sinara-hw/Kasli/(threads)

Thread 2 (2018-05-26):

Ethernet stops working when multiple EEMs used

gkasprow, 2018-05-26:
@marmeladapk found that when multiple Urukul or other EEM are plugged, Ethernet does not work.
The same happens when Kasli is supplied via extension backplane board.
Did you observe such case?
We will investigate it.

marmeladapk, 2018-05-26:
For example in suservo setup without dios link would not set up. On terminal no errors regarding ethernet are printed. It was a problem when 12V current was higher than ~1,5A.

jordens, 2018-05-27:
I have configured more than a dozen systems and at least 6 of them had 8 EEMs (3 Urukul, 1 Zotino, 1 Sampler, 3 DIO). I haven't seen this. From the description it's unclear what exactly you tried and what your configuration is. You'll have to supply versions, numbers etc.

gkasprow, 2018-05-27:
That's why I'm surprised that this occurred in my lab. Kasli was already tested with various configurations and so far nobody reported such effect.

jordens, 2018-05-28:
And you are sure that the hardware, gatware, firmware, bootloader versions match and are what you expect? What about the rest of the Toolchain?

hartytp, 2019-05-07:
@gkasprow @marmeladapk can you reproduce this, or can we close?

hartytp, 2019-09-19:
Can we close this?

Closed 2019-10-01.

Thread 3 (2018-06-13):

Kasli v1.2 wishlist

marmeladapk, 2018-06-13:
_From @marmeladapk on January 31, 2018 9:53_

- Rotate SATA connector
- Have I2C and UART signals in the same bank (each of them)
- Switch all components to our standard library
- Switch U1 to nonBGA version
- Maybe [Bigger heat sink](https://www.digikey.de/products/en/fans-thermal-management/thermal-heat-sinks/219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) with clamps pending measurements with big artiq setup
- Move the clock input SMA further towards the panel. Leave just enough gap for the insulating washer. Otherwise (with a gap, the two insulating washers, the panel, and the nut, even without the springy/claw washer) there is not enough thread to fully tighten an SMA connector.
- Si5369 instead of Si5324+ADCLK944 (power, board space, components, cost). Or even Si5346
- Move UART RxD away from bank 13
- Replace 100k resistors with 0R on the SMA clock input and MMCX clock outputs to tie all grounds together.
- Add note on schematic by the connectors saying something like "To float connector grounds, replace 0R with 100k. NB Kasli must be connected to mains ground for to avoid damage to it or other equipment connected to it!"
 - Add TVS on JTAG
 - Make board 2-3 mm shorter, so that technosystem doesn't need to grind each board to mount backplane connector... (they told me about it after five months!)

_Copied from original issue: sinara-hw/sinara#499_

marmeladapk, 2018-06-13:
_From @hartytp on January 31, 2018 14:2_

Is there a Kasli v1.2 planned for any time in the future?

marmeladapk, 2018-06-13:
_From @jordens on January 31, 2018 14:38_

I think we need more experience with it in the field to be able to say that.

marmeladapk, 2018-06-13:
First let's see how v1.1 operates, IMO points in the top post are not worth it right now.

marmeladapk, 2018-06-13:
> Change the Si5324 (loss of lock) LOL LED to red (as it indicates an error condition) or invert it.

@jordens Oh come on! You told me to change it from red to green so there are fewer items in the BOM. :D

Anyway LOL polarity can be changed in register 22 B1 of Si5324.

marmeladapk, 2018-06-13:
_From @jordens on February 3, 2018 7:57_

Ah. Right. Then it's perfect. I forgot about both. ;)

marmeladapk, 2018-06-13:
_From @hartytp on March 28, 2018 21:45_

The biggest thing I'd like to see changed on the list above is the heatsink, since the FPGA gets very hot atm. It might be worth going for a heatsink with a clip on fan.

marmeladapk, 2018-06-13:
_From @hartytp on March 28, 2018 23:31_

- [ ] Replace 100k resistors with 0R on the SMA clock input and MMCX clock outputs to tie all grounds together.
- [ ] Add note on schematic by the connectors saying something like "To float connector grounds, replace 0R with 100k. NB Kasli must be connected to mains ground for to avoid damage to it or other equipment connected to it!"

marmeladapk, 2018-06-13:
I think we're slowly approaching point when we can think about next revision. Are there any other things we'd like to test before I start implementing changes? What's the consensus on Si5324/Si5369/Si5346?

marmeladapk, 2018-06-13:
_From @hartytp on March 29, 2018 9:6_

@marmeladapk In the long run, I'm still potentially keen to implement WR on Kasli. Probably use a DAC + high-quality VCO for clock recovery. Then either use a LVPECL clock buffer (noise isn't critical here, so there are lots of options) or something like an AD9516-4 to do the fanout.

However, we're still doing a design study to make sure we get that right, so we won't have a design for that for another week or two.

Until/unless we switch to WR, I'm not fussed about any of the options being discussed. IMHO, the present clocking works well (modulo the stability/phase determinism issues with the Si5324) and none of the options presented above offer a good enough advantage in terms of cost/power/simplicity to be worth changing a working design and risking breaking things. However, if @jordens feels strongly about it, I don't object either.

marmeladapk, 2018-06-13:
_From @jordens on March 29, 2018 9:21_

> Kasli must be connected to mains ground for to avoid damage to it or other equipment connected to it!

I don't think that is accurate and might even be wrong. I'd state how much potential difference we are willing and able to tolerate and what the actual ground paths in the system are. Like it is done on all measurement equipment.

@sbourdeauducq wanted to do tests with the Si5326 to guide that decision.

And I don't think a big heat sink will cut it. We have been equipping them with fans.

marmeladapk, 2018-06-13:
_From @hartytp on March 29, 2018 9:30_

> And I don't think a big heat sink will cut it. We have been equipping them with fans.

:+1: Something like the heat sink on the KC705 would be nice.

> I don't think that is accurate and might even be wrong. I'd state how much potential difference we are willing and able to tolerate and what the actual ground paths in the system are. Like it is done on all measurement equipment.

AFAICT, connecting to PCB ground to mains ground is the most fool-proof solution, which should prevent damage in basically all cases (this is what almost all T&M equipment does), so it's an easy, safe recommendation to make -- I'm not aware of any situation where this could be dangerous/lead to damage, even if it's not often/always optimal from a noise perspective. Maybe change *must* to *should*, or even just re-word it to say that the potential difference between all grounds must be limited to safe-levels for all equipment, *for example* by connecting Kasli to mains ground?

Having said that, if you have a better suggestion, then feel free to make it (can you give exact text, please, including values for potential differences you want to recommend).

marmeladapk, 2018-06-13:
_From @hartytp on March 29, 2018 9:33_

@jordens @sbourdeauducq I believe the answer to this is "no", but to double check: we don't think that a bigger FPGA/higher speed grade would help with anything we're doing? e.g. for large Kasli designs, we're not close to being limited by FPGA resources, right? and, the higher speed grade wouldn't ease the CPU timing issues?

marmeladapk, 2018-06-13:
_From @sbourdeauducq on March 29, 2018 10:28_

After the siphaser system we introduced, I don't think the 5326 would improve anything significantly, it would just save something like one or two MMCMs in the FPGA since we can use the skew control registers instead. And if we start having it on any board, then we need to support both the 5324 and 5326 in the firmware. This family of chips appears to be exceptionally well-designed (case in point: the 5324 and 5326 are pin-compatible) and bug-free, so it's not a big issue if that has to be done, but why should we?

marmeladapk, 2018-06-13:
_From @sbourdeauducq on March 29, 2018 10:38_

Note that the 5326 does **not** have deterministic latency - all it brings to the table is built-in functionality to increase or decrease whatever random skew it has after locking, and higher loop bandwidth. So, it doesn't help with getting deterministic phase from the external clock input to the ARTIQ outputs.

I am in favor of either:
* keeping the 5324 (the engineering costs associated with the change and the maintainance of multiple clock chip variants in the firmware do not seem to be worth using a 5326, 5369 or 5346).
* designing a high-performance PLL a la White Rabbit.

marmeladapk, 2018-06-13:
_From @hartytp on March 29, 2018 11:6_

Thanks @sbourdeauducq. In that case, here is my suggestion:
- @WeiDaZhang keeps working on design of a WR implementation for Sinara, as well as carefully characterizing the performance of our current Si5324 setup and simulating/taking data on the performance of the WR system.
- We agree on a cut-off date for changes to the design for the next version of Kasli
- Once that cut-off date arrives:
  - if @WeiDaZhang's design isn't ready we stick with the current Si5324.
  - if we decide on the basis of @WeiDaZhang's measurements that the benefits from WR aren't sufficient to justify the changes, we stick with the Si5324
  - otherwise, we implement WR on Kasli for the next version.

Everyone happy with that plan? If so, what's the deadline for this decision?

marmeladapk, 2018-06-13:
_From @sbourdeauducq on March 29, 2018 11:18_

> Change the Si5324 (loss of lock) LOL LED to red (as it indicates an error condition) or invert it.
>
> @jordens Oh come on! You told me to change it from red to green so there are fewer items in the BOM. :D

Do we need this LED at all? Lock status is accessible from the firmware. I've never used that LED personally.

marmeladapk, 2018-06-13:
_From @jbqubit on March 29, 2018 12:55_

> AFAICT, connecting to PCB ground to mains ground is the most fool-proof solution

Agreed that this is the most fool-proof. The default configuration should protect casual end users as well as isolate the manufacturer from liability. The grounding implementation could be made so that it's easy to modify. Then modifications which might cause harm to body or the board itself are at the risk of the end user.

marmeladapk, 2018-06-13:
_From @sbourdeauducq on March 29, 2018 16:49_

> Everyone happy with that plan?

Sounds fine, but integrating the WR PLL into ARTIQ doesn't sound trivial; we need to plan for the manpower and development time in the firmware and gateware (in addition to the hardware changes).

marmeladapk, 2018-06-13:
_From @hartytp on March 29, 2018 17:14_

Absolutely, yes. That's an essential part of the cost / benefit analysis. But let's get a concrete proposal to discuss first...

marmeladapk, 2018-06-13:
_From @hartytp on April 1, 2018 8:7_

> Sounds fine, but integrating the WR PLL into ARTIQ doesn't sound trivial; we need to plan for the manpower and development time in the firmware and gateware (in addition to the hardware changes).

If we do go down the WR route, I'd still want to keep the Si5324 as well for at least the next version. Obviously, we would want to be able to use Kasli even while the WR gateware/firmware is developed and debugged.

marmeladapk, 2018-06-13:
_From @hartytp on April 1, 2018 8:19_

Is it worth considering switching to a Kintex FPGA and maybe increasing the ram width (cf the DMA issues @cjbe reported) for the next version?

Speed seems to be by far the biggest complaint of ARTIQ users, and the fact that Kasli is noticeably slower than the KC705 setups we've used in the past seems like a major step in the wrong direction. I'm all for optimising gateware/firmware, but it seems silly not to start from the fastest hardware platform we reasonably can -- I'm not sure about other users (@dhslichter @dtcallcock etc), but I would gladly pay a bit more for HW if it made my setups faster.

marmeladapk, 2018-06-13:
_From @jordens on April 1, 2018 9:0_

I'm against that. Lets keep kasli at the simple end. It was well known and acknowledged that it would be slower. Wider ram will lead to board space and power, thermal issues and redesigns. You are obviously free to fund a new device with a bigger fpga though.

marmeladapk, 2018-06-13:
_From @hartytp on April 1, 2018 14:9_

>  Lets keep kasli at the simple end.

"Simple" doesn't have to equal "slow". I'm not convinced that putting a faster FPGA on there makes it not a simple design.

> It was well known and acknowledged that it would be slower.

Really? That wasn't my impression. When I discussed this via email with you and @sbourdeauducq before Kasli v1.0's design was finalised I explicitly asked about whether there would be CPU frequency issues with the ARTIQ, and was told that there wouldn't be.

In any case, I think this point is largely irrelevant. What matters is whether, having used this in the lab and knowing what we know now, we still think the current design is the right one for the users, or whether changing the FPGA would be better. Let's not get hung up on why decisions were made.

> You are obviously free to fund a new device with a bigger fpga though.

Firstly: I read that to imply that you are funding work on the next Kasli revision. Is that actually true? Does your contract with WUT specify more than the standard two design rounds? If not, is this something that @marmeladapk and @gkasprow are doing on their own steam without and funding? If so, I don't see why you're bringing up funding here.

Secondly: I've worked hard to avoid hardware fragmentation in this project because I (still) believe that's the only way we're going to get a set of high-quality, well supported hardware which is stocked at good prices from a commercial vendor. If we all take the line of "this is my project, so if you don't like it then make your own version" then we're going to end up with a multiplicity of shoddy boards. I think we can be a bit more mature than that and work to find solutions that work for everyone.

Thirdly: while you may have funded the original version of Kasli, if you want someone like Creotech to stock it then they have to believe that it's what the users want. So, let's have an discussion that focusses on technical points, rather than shutting things down with "this is my project, go away".

> Wider ram will lead to board space and power, thermal issues and redesigns.

You've made this kind of assertion several times in this project only to be contradicted by @marmeladapk, who is actually doing the design work and has done the simulations. If you've done a simulation or have anything concrete to back up these claims then I'd love to hear about them. But, otherwise, I'd rather hear from @gkasprow or @marmeladapk.

---

tl;dr: if other users don't think a bigger FPGA is worth it (maybe this is worth addressing to the ARTIQ mailing list), or if @gkasprow or @marmeladapk think that it would be too much work/cause other issues, then let's leave it as is. But, if there are simple changes that can make Kasli work better for the users then we should consider them.

After all, it's not like the current FPGA on Kasli isn't causing problems right now, and that makes me concerned that in the long run it's not a very good choice.

marmeladapk, 2018-06-13:
_From @hartytp on April 1, 2018 14:12_

>  It was well known and acknowledged that it would be slower.

Again, I'd love to hear from one of the other groups who are actually using ARTIQ to run experiments with (e.g. @dtcallcock @dhslichter) but my feeling is that the current slowness of ARTIQ makes it a massive pain in the neck for most use cases. Anything that makes it even slower is of very limited interest as far as I'm concerned.

marmeladapk, 2018-06-13:
_From @hartytp on April 1, 2018 14:40_

To be a bit more concrete here, my concerns are things like: if we're struggling to make ARTIQ meet timing on Kasli as it is, what will happen when we want to add features like hard floating-point maths? Will we just have to accept that they aren't available on Kasli because we put a slow FPGA on it?

marmeladapk, 2018-06-13:
_From @sbourdeauducq on April 1, 2018 14:57_

> It was well known and acknowledged that it would be slower.
>
> Really? That wasn't my impression. When I discussed this via email with you and @sbourdeauducq before Kasli v1.0's design was finalised I explicitly asked about whether there would be CPU frequency issues with the ARTIQ, and was told that there wouldn't be.

I guess @jordens is talking about the RAM, which is obviously slower than on KC705 (16-bit vs. 64-bit data bus).
How strongly Vivado insists on making mor1kx systems slow on Artix-7, on the other hand, is a bit of a surprise. Switching to 7K70T might be OK (it's not much more expensive), if it weren't for the major PCB design change, plus another round of transceiver yak-shaving to make DRTIO and Ethernet work again (among their many problems, transceivers are not compatible between FPGA families and each comes with its own set of idiosyncrasies and obscure bugs).

marmeladapk, 2018-06-13:
_From @sbourdeauducq on April 1, 2018 15:28_

> How strongly Vivado insists on making mor1kx systems slow on Artix-7, on the other hand, is a bit of a surprise.

Part of the reason it's a surprise is because uniprocessor systems (e.g. the DRTIO satellite, and other MiSoC ports to Artix-7 boards) meet timing; the problems appear with the ARTIQ dual-CPU design for some reason.

marmeladapk, 2018-06-13:
_From @hartytp on April 1, 2018 17:28_

> I guess @jordens is talking about the RAM, which is obviously slower than on KC705 (16-bit vs. 64-bit data bus).

Yes, that the RAM on Kasli is obviously slower than the KC705. However, I'm not sure that the effects that has on ARTIQ DMA were obvious or anticipated (the RAM bandwidth is still pretty huge).

However, that can probably be sorted with a more efficient RAM controller, so it may be that no HW changes are needed here. Although, it's still not clear to me that the cost of adding a wider RAM bus to Kasli is actually that high, so it might still be worth considering.

marmeladapk, 2018-06-13:
_From @hartytp on April 1, 2018 17:32_

> How strongly Vivado insists on making mor1kx systems slow on Artix-7, on the other hand, is a bit of a surprise.

Yes, this concerns me much more than the RAM.

> if it weren't for the major PCB design change

IIRC, there will need to be some substantial re-routing to add a bigger heatsink, so now is the time to consider that. @marmeladapk @gkasprow what's your feeling about this? How hard would that be to do?

> plus another round of transceiver yak-shaving to make DRTIO and Ethernet work again (among their many problems, transceivers are not compatible between FPGA families and they each come with their own set of idiosyncrasies and obscure bugs).

ACK. That's a reasonable point. However, what do you think is going to be more work in the long run: fixing the transceivers once or fighting against slow silicon on Kasli for everything we do?

marmeladapk, 2018-06-13:
_From @hartytp on April 1, 2018 17:34_

> Part of the reason it's a surprise is because uniprocessor systems (e.g. the DRTIO satellite, and other MiSoC ports to Artix-7 boards) meet timing; the problems appear with the ARTIQ dual-CPU design for some reason.

Yes, that is a bit concerning. And, again, it doesn't give me much confidence that issues to do with Artix FPGAs being slow won't be a recurring theme as we develop ARTIQ further, e.g. by adding hard FP.

marmeladapk, 2018-06-13:
_From @sbourdeauducq on April 2, 2018 2:45_

> ACK. That's a reasonable point. However, what do you think is going to be more work in the long run: fixing the transceivers once or fighting against slow silicon on Kasli for everything we do?

It's not "everything"; as I posted in https://github.com/m-labs/artiq/issues/891 the LM32 processor has a lot less timing issues. Also, even with mor1kx, the magnitude of the timing failure is small: with the numbers that Robert initially reported, it would run at 122.9MHz instead of the target 125MHz, a 1.7% slowdown.

marmeladapk, 2018-06-13:
_From @hartytp on April 2, 2018 7:35_

> Also, even with mor1kx, the magnitude of the timing failure is small: with the numbers that Robert initially reported, it would run at 122.9MHz instead of the target 125MHz, a 1.7% slowdown.

Yes, although I got the impression that there was some build to build variation in that.

> It's not "everything"; as I posted in m-labs/artiq#891 the LM32 processor has a lot less timing issues.

You're right "everything" is an exaggeration. Lot's of things won't be affected by having a slower FPGA. But, it is hurting us at the moment, and it seems likely that having a CPU that only just meets timing has the potential to cause more issues in the future.

Taking a step back for a moment: I think we all agree that ARTIQ is currently too slow, and that it needs to be speeded up in the future. We know the Artix FPGA on Kasli is slower than comparably priced Kintex FPGAs, and that this can cause issues. Given that, are we sure we don't want to consider using a faster FPGA? Even if we do switch to the LM32 and even if this does fix the timing issues we're currently seeing, are you really sure that the slower FPGA won't cause other problems in the future?

marmeladapk, 2018-06-13:
_From @hartytp on April 2, 2018 7:36_

Of course, if @gkasprow or @marmeladapk say it's too much work to consider for the next version of Kasli, then it may not be an option.

marmeladapk, 2018-06-13:
> Does your contract with WUT specify more than the standard two design rounds? If not, is this something that @marmeladapk and @gkasprow are doing on their own steam without and funding?

I'm not aware of the state of the funding. However week ago I thought that design was frozen and v1.2 was only cosmetic and QoL changes.

---

>> Wider ram will lead to board space and power, thermal issues and redesigns.

@hartytp, @jordens is right on this one. While I wouldn't worry about thermal and power issues (unless we're speaking about FPGA itself, we've got plenty of power left on 1,5 V rail, see schematics) redesign would be needed here. I feel, that current configuration is optimal and we don't have any room to fiddle with this design.

First, we would have to use another bank on FPGA for additional 16 bits. We can't share it with EEM banks since they use different voltages. So we have to get rid of at least 3 extensions (if we want to minimise work that would be eem0 to 2). This is the easiest option to implement. If we don't want to cut any corners then other options include expander and level shifter for all SFP control signals that could then share bank with SDRAM. That would require bottom half of FPGA (and eem0 to 7 and 10 to 11) to be rerouted.

We could also switch to bigger package (and to Artix 200T since we need an additional bank). This may or may not require to switch to 8 layers. I can't tell because on the one hand I need to escape with additional 16 length matched signals and on the other hand FPGA side is bigger. Obviously bigger package requires rerouting everything under and in the vicinity of the FPGA (+ power planes). And changing stackup will probably require changes to all impedance controlled lines.

> if there are simple changes that can make Kasli work better for the users then we should consider them

As I said, I think we don't have any easy ways to improve this design (apart from changing 100T to 200T in the same package, but more on that later).

**TL;DR**: Wider RAM is hard.

-----

> if we're struggling to make ARTIQ meet timing on Kasli

> Vivado insists on making mor1kx systems slow on Artix-7

Is this something that more resources could help? Or are we not using over 60-70% of them (can't check right now, I can't connect to our computers at uni)? Artix 200T is available in the same package. Xilinx says that it's pin compatible, it may only have other decoupling requirements.

Also, stupid question: have we tried different synthesis and implementation strategies? Xilinx recommends trying all of them and then choosing one that works best (seriously) if design barely doesn't meet timing. 1-2% could be gained there.

> ARTIQ is currently too slow

Is it only slow on Kasli or also on Sayma and KC705?

> Is it worth considering switching to a Kintex FPGA and maybe increasing the ram width

> Artix FPGA on Kasli is slower than comparably priced Kintex FPGAs (...) are we sure we don't want to consider using a faster FPGA?

I feel that this would be the change worthy of 2.0 version number. K70T has less resources that A100T so I don't feel that would be the optimal change. Only other FPGA available in 484 package is K160T. But we have to remember, that Xilinx FPGAs are not pin-compatible between families. So that would require rerouting everything under and near FPGA. Also some LVDS lines would have to use HP banks, so we would use 1,8 V LVDS. This should not be a problem for devices (probably, @gkasprow?), just noting. But we could then use HP bank for SDRAM. Not sure if this would help, @jordens and @sbourdeauducq should chime in here.

**TL;DR** Switching to Kintex-7 is also hard.

---

Overall my feelings are, that we're moving away from the idea of cheap and simpler controller that Kasli was supposed to be. Instead I feel like we're stepping closer to inventing MTCA from scratch, only with ribbon cables this time. And while I agree with @hartytp that ARTIQ on Kasli is too slow I wouldn't jump to conclusion that changing hardware right now is the solution. It looks like knee-jerk reaction TBH.

Perhaps giving more time (and funding?) to m-labs to optimize ARTIQ and underlying software could help? It would also translate to gains on all other boards now and in the future. If @sbourdeauducq says, that he didn't anticipate processor to be so slow on Artix and we didn't find a clear bottleneck who says that it won't repeat on small Kintex?

OFC if we find the bottleneck and it's for example RAM then let's change that. But I've outlined why these aren't simple changes.

marmeladapk, 2018-06-13:
_From @sbourdeauducq on April 2, 2018 12:54_

> Also, stupid question: have we tried different synthesis and implementation strategies? Xilinx recommends trying all of them and then choosing one that works best (seriously) if design barely doesn't meet timing. 1-2% could be gained there.

Yeah, I've been looking into this. I can make many mor1kx options meet timing on many variants (opticlock, sysu, master etc.) by using various Vivado commands, but what works on one variant doesn't often work on another and some combination of commands have very long runtime.

Trying a pin-compatible 200T FPGA is a good idea, and easy to change in the gateware - let me see if that improves timing.

Closed 2018-06-13.

Thread 4 (2018-06-13):

Kasli v1.2 wishlist

marmeladapk, 2018-06-13:
_From @marmeladapk on January 31, 2018 9:53_

- Rotate SATA connector
- Have I2C and UART signals in the same bank (each of them)
- Switch all components to our standard library
- Switch U1 to nonBGA version
- Maybe [Bigger heat sink](https://www.digikey.de/products/en/fans-thermal-management/thermal-heat-sinks/219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) with clamps pending measurements with big artiq setup
- Move the clock input SMA further towards the panel. Leave just enough gap for the insulating washer. Otherwise (with a gap, the two insulating washers, the panel, and the nut, even without the springy/claw washer) there is not enough thread to fully tighten an SMA connector.
- Si5369 instead of Si5324+ADCLK944 (power, board space, components, cost). Or even Si5346
- Move UART RxD away from bank 13
- Replace 100k resistors with 0R on the SMA clock input and MMCX clock outputs to tie all grounds together.
- Add note on schematic by the connectors saying something like "To float connector grounds, replace 0R with 100k. NB Kasli must be connected to mains ground for to avoid damage to it or other equipment connected to it!"
 - Add TVS on JTAG
 - Make board 2-3 mm shorter, so that technosystem doesn't need to grind each board to mount backplane connector... (they told me about it after five months!)

_Copied from original issue: sinara-hw/sinara#499_

marmeladapk, 2018-06-13:
_From @hartytp on January 31, 2018 14:2_

Is there a Kasli v1.2 planned for any time in the future?

marmeladapk, 2018-06-13:
_From @jordens on January 31, 2018 14:38_

I think we need more experience with it in the field to be able to say that.

marmeladapk, 2018-06-13:
First let's see how v1.1 operates, IMO points in the top post are not worth it right now.

marmeladapk, 2018-06-13:
> Change the Si5324 (loss of lock) LOL LED to red (as it indicates an error condition) or invert it.

@jordens Oh come on! You told me to change it from red to green so there are fewer items in the BOM. :D

Anyway LOL polarity can be changed in register 22 B1 of Si5324.

marmeladapk, 2018-06-13:
_From @jordens on February 3, 2018 7:57_

Ah. Right. Then it's perfect. I forgot about both. ;)

marmeladapk, 2018-06-13:
_From @hartytp on March 28, 2018 21:45_

The biggest thing I'd like to see changed on the list above is the heatsink, since the FPGA gets very hot atm. It might be worth going for a heatsink with a clip on fan.

marmeladapk, 2018-06-13:
_From @hartytp on March 28, 2018 23:31_

- [ ] Replace 100k resistors with 0R on the SMA clock input and MMCX clock outputs to tie all grounds together.
- [ ] Add note on schematic by the connectors saying something like "To float connector grounds, replace 0R with 100k. NB Kasli must be connected to mains ground for to avoid damage to it or other equipment connected to it!"

marmeladapk, 2018-06-13:
I think we're slowly approaching point when we can think about next revision. Are there any other things we'd like to test before I start implementing changes? What's the consensus on Si5324/Si5369/Si5346?

marmeladapk, 2018-06-13:
_From @jordens on March 29, 2018 9:21_

> Kasli must be connected to mains ground for to avoid damage to it or other equipment connected to it!

I don't think that is accurate and might even be wrong. I'd state how much potential difference we are willing and able to tolerate and what the actual ground paths in the system are. Like it is done on all measurement equipment.

@sbourdeauducq wanted to do tests with the Si5326 to guide that decision.

And I don't think a big heat sink will cut it. We have been equipping them with fans.

marmeladapk, 2018-06-13:
_From @hartytp on March 29, 2018 9:30_

> And I don't think a big heat sink will cut it. We have been equipping them with fans.

:+1: Something like the heat sink on the KC705 would be nice.

> I don't think that is accurate and might even be wrong. I'd state how much potential difference we are willing and able to tolerate and what the actual ground paths in the system are. Like it is done on all measurement equipment.

AFAICT, connecting to PCB ground to mains ground is the most fool-proof solution, which should prevent damage in basically all cases (this is what almost all T&M equipment does), so it's an easy, safe recommendation to make -- I'm not aware of any situation where this could be dangerous/lead to damage, even if it's not often/always optimal from a noise perspective. Maybe change *must* to *should*, or even just re-word it to say that the potential difference between all grounds must be limited to safe-levels for all equipment, *for example* by connecting Kasli to mains ground?

Having said that, if you have a better suggestion, then feel free to make it (can you give exact text, please, including values for potential differences you want to recommend).

marmeladapk, 2018-06-13:
_From @hartytp on March 29, 2018 9:33_

@jordens @sbourdeauducq I believe the answer to this is "no", but to double check: we don't think that a bigger FPGA/higher speed grade would help with anything we're doing? e.g. for large Kasli designs, we're not close to being limited by FPGA resources, right? and, the higher speed grade wouldn't ease the CPU timing issues?

marmeladapk, 2018-06-13:
_From @sbourdeauducq on March 29, 2018 10:28_

After the siphaser system we introduced, I don't think the 5326 would improve anything significantly, it would just save something like one or two MMCMs in the FPGA since we can use the skew control registers instead. And if we start having it on any board, then we need to support both the 5324 and 5326 in the firmware. This family of chips appears to be exceptionally well-designed (case in point: the 5324 and 5326 are pin-compatible) and bug-free, so it's not a big issue if that has to be done, but why should we?

marmeladapk, 2018-06-13:
_From @sbourdeauducq on March 29, 2018 10:38_

Note that the 5326 does **not** have deterministic latency - all it brings to the table is built-in functionality to increase or decrease whatever random skew it has after locking, and higher loop bandwidth. So, it doesn't help with getting deterministic phase from the external clock input to the ARTIQ outputs.

I am in favor of either:
* keeping the 5324 (the engineering costs associated with the change and the maintainance of multiple clock chip variants in the firmware do not seem to be worth using a 5326, 5369 or 5346).
* designing a high-performance PLL a la White Rabbit.

marmeladapk, 2018-06-13:
_From @hartytp on March 29, 2018 11:6_

Thanks @sbourdeauducq. In that case, here is my suggestion:
- @WeiDaZhang keeps working on design of a WR implementation for Sinara, as well as carefully characterizing the performance of our current Si5324 setup and simulating/taking data on the performance of the WR system.
- We agree on a cut-off date for changes to the design for the next version of Kasli
- Once that cut-off date arrives:
  - if @WeiDaZhang's design isn't ready we stick with the current Si5324.
  - if we decide on the basis of @WeiDaZhang's measurements that the benefits from WR aren't sufficient to justify the changes, we stick with the Si5324
  - otherwise, we implement WR on Kasli for the next version.

Everyone happy with that plan? If so, what's the deadline for this decision?

marmeladapk, 2018-06-13:
_From @sbourdeauducq on March 29, 2018 11:18_

> Change the Si5324 (loss of lock) LOL LED to red (as it indicates an error condition) or invert it.
>
> @jordens Oh come on! You told me to change it from red to green so there are fewer items in the BOM. :D

Do we need this LED at all? Lock status is accessible from the firmware. I've never used that LED personally.

marmeladapk, 2018-06-13:
_From @jbqubit on March 29, 2018 12:55_

> AFAICT, connecting to PCB ground to mains ground is the most fool-proof solution

Agreed that this is the most fool-proof. The default configuration should protect casual end users as well as isolate the manufacturer from liability. The grounding implementation could be made so that it's easy to modify. Then modifications which might cause harm to body or the board itself are at the risk of the end user.

marmeladapk, 2018-06-13:
_From @sbourdeauducq on March 29, 2018 16:49_

> Everyone happy with that plan?

Sounds fine, but integrating the WR PLL into ARTIQ doesn't sound trivial; we need to plan for the manpower and development time in the firmware and gateware (in addition to the hardware changes).

marmeladapk, 2018-06-13:
_From @hartytp on March 29, 2018 17:14_

Absolutely, yes. That's an essential part of the cost / benefit analysis. But let's get a concrete proposal to discuss first...

marmeladapk, 2018-06-13:
_From @hartytp on April 1, 2018 8:7_

> Sounds fine, but integrating the WR PLL into ARTIQ doesn't sound trivial; we need to plan for the manpower and development time in the firmware and gateware (in addition to the hardware changes).

If we do go down the WR route, I'd still want to keep the Si5324 as well for at least the next version. Obviously, we would want to be able to use Kasli even while the WR gateware/firmware is developed and debugged.

marmeladapk, 2018-06-13:
_From @hartytp on April 1, 2018 8:19_

Is it worth considering switching to a Kintex FPGA and maybe increasing the ram width (cf the DMA issues @cjbe reported) for the next version?

Speed seems to be by far the biggest complaint of ARTIQ users, and the fact that Kasli is noticeably slower than the KC705 setups we've used in the past seems like a major step in the wrong direction. I'm all for optimising gateware/firmware, but it seems silly not to start from the fastest hardware platform we reasonably can -- I'm not sure about other users (@dhslichter @dtcallcock etc), but I would gladly pay a bit more for HW if it made my setups faster.

marmeladapk, 2018-06-13:
_From @jordens on April 1, 2018 9:0_

I'm against that. Lets keep kasli at the simple end. It was well known and acknowledged that it would be slower. Wider ram will lead to board space and power, thermal issues and redesigns. You are obviously free to fund a new device with a bigger fpga though.

marmeladapk, 2018-06-13:
_From @hartytp on April 1, 2018 14:9_

>  Lets keep kasli at the simple end.

"Simple" doesn't have to equal "slow". I'm not convinced that putting a faster FPGA on there makes it not a simple design.

> It was well known and acknowledged that it would be slower.

Really? That wasn't my impression. When I discussed this via email with you and @sbourdeauducq before Kasli v1.0's design was finalised I explicitly asked about whether there would be CPU frequency issues with the ARTIQ, and was told that there wouldn't be.

In any case, I think this point is largely irrelevant. What matters is whether, having used this in the lab and knowing what we know now, we still think the current design is the right one for the users, or whether changing the FPGA would be better. Let's not get hung up on why decisions were made.

> You are obviously free to fund a new device with a bigger fpga though.

Firstly: I read that to imply that you are funding work on the next Kasli revision. Is that actually true? Does your contract with WUT specify more than the standard two design rounds? If not, is this something that @marmeladapk and @gkasprow are doing on their own steam without and funding? If so, I don't see why you're bringing up funding here.

Secondly: I've worked hard to avoid hardware fragmentation in this project because I (still) believe that's the only way we're going to get a set of high-quality, well supported hardware which is stocked at good prices from a commercial vendor. If we all take the line of "this is my project, so if you don't like it then make your own version" then we're going to end up with a multiplicity of shoddy boards. I think we can be a bit more mature than that and work to find solutions that work for everyone.

Thirdly: while you may have funded the original version of Kasli, if you want someone like Creotech to stock it then they have to believe that it's what the users want. So, let's have an discussion that focusses on technical points, rather than shutting things down with "this is my project, go away".

> Wider ram will lead to board space and power, thermal issues and redesigns.

You've made this kind of assertion several times in this project only to be contradicted by @marmeladapk, who is actually doing the design work and has done the simulations. If you've done a simulation or have anything concrete to back up these claims then I'd love to hear about them. But, otherwise, I'd rather hear from @gkasprow or @marmeladapk.

---

tl;dr: if other users don't think a bigger FPGA is worth it (maybe this is worth addressing to the ARTIQ mailing list), or if @gkasprow or @marmeladapk think that it would be too much work/cause other issues, then let's leave it as is. But, if there are simple changes that can make Kasli work better for the users then we should consider them.

After all, it's not like the current FPGA on Kasli isn't causing problems right now, and that makes me concerned that in the long run it's not a very good choice.

marmeladapk, 2018-06-13:
_From @hartytp on April 1, 2018 14:12_

>  It was well known and acknowledged that it would be slower.

Again, I'd love to hear from one of the other groups who are actually using ARTIQ to run experiments with (e.g. @dtcallcock @dhslichter) but my feeling is that the current slowness of ARTIQ makes it a massive pain in the neck for most use cases. Anything that makes it even slower is of very limited interest as far as I'm concerned.

marmeladapk, 2018-06-13:
_From @hartytp on April 1, 2018 14:40_

To be a bit more concrete here, my concerns are things like: if we're struggling to make ARTIQ meet timing on Kasli as it is, what will happen when we want to add features like hard floating-point maths? Will we just have to accept that they aren't available on Kasli because we put a slow FPGA on it?

marmeladapk, 2018-06-13:
_From @sbourdeauducq on April 1, 2018 14:57_

> It was well known and acknowledged that it would be slower.
>
> Really? That wasn't my impression. When I discussed this via email with you and @sbourdeauducq before Kasli v1.0's design was finalised I explicitly asked about whether there would be CPU frequency issues with the ARTIQ, and was told that there wouldn't be.

I guess @jordens is talking about the RAM, which is obviously slower than on KC705 (16-bit vs. 64-bit data bus).
How strongly Vivado insists on making mor1kx systems slow on Artix-7, on the other hand, is a bit of a surprise. Switching to 7K70T might be OK (it's not much more expensive), if it weren't for the major PCB design change, plus another round of transceiver yak-shaving to make DRTIO and Ethernet work again (among their many problems, transceivers are not compatible between FPGA families and each comes with its own set of idiosyncrasies and obscure bugs).

marmeladapk, 2018-06-13:
_From @sbourdeauducq on April 1, 2018 15:28_

> How strongly Vivado insists on making mor1kx systems slow on Artix-7, on the other hand, is a bit of a surprise.

Part of the reason it's a surprise is because uniprocessor systems (e.g. the DRTIO satellite, and other MiSoC ports to Artix-7 boards) meet timing; the problems appear with the ARTIQ dual-CPU design for some reason.

marmeladapk, 2018-06-13:
_From @hartytp on April 1, 2018 17:28_

> I guess @jordens is talking about the RAM, which is obviously slower than on KC705 (16-bit vs. 64-bit data bus).

Yes, that the RAM on Kasli is obviously slower than the KC705. However, I'm not sure that the effects that has on ARTIQ DMA were obvious or anticipated (the RAM bandwidth is still pretty huge).

However, that can probably be sorted with a more efficient RAM controller, so it may be that no HW changes are needed here. Although, it's still not clear to me that the cost of adding a wider RAM bus to Kasli is actually that high, so it might still be worth considering.

marmeladapk, 2018-06-13:
_From @hartytp on April 1, 2018 17:32_

> How strongly Vivado insists on making mor1kx systems slow on Artix-7, on the other hand, is a bit of a surprise.

Yes, this concerns me much more than the RAM.

> if it weren't for the major PCB design change

IIRC, there will need to be some substantial re-routing to add a bigger heatsink, so now is the time to consider that. @marmeladapk @gkasprow what's your feeling about this? How hard would that be to do?

> plus another round of transceiver yak-shaving to make DRTIO and Ethernet work again (among their many problems, transceivers are not compatible between FPGA families and they each come with their own set of idiosyncrasies and obscure bugs).

ACK. That's a reasonable point. However, what do you think is going to be more work in the long run: fixing the transceivers once or fighting against slow silicon on Kasli for everything we do?

marmeladapk, 2018-06-13:
_From @hartytp on April 1, 2018 17:34_

> Part of the reason it's a surprise is because uniprocessor systems (e.g. the DRTIO satellite, and other MiSoC ports to Artix-7 boards) meet timing; the problems appear with the ARTIQ dual-CPU design for some reason.

Yes, that is a bit concerning. And, again, it doesn't give me much confidence that issues to do with Artix FPGAs being slow won't be a recurring theme as we develop ARTIQ further, e.g. by adding hard FP.

marmeladapk, 2018-06-13:
_From @sbourdeauducq on April 2, 2018 2:45_

> ACK. That's a reasonable point. However, what do you think is going to be more work in the long run: fixing the transceivers once or fighting against slow silicon on Kasli for everything we do?

It's not "everything"; as I posted in https://github.com/m-labs/artiq/issues/891 the LM32 processor has a lot less timing issues. Also, even with mor1kx, the magnitude of the timing failure is small: with the numbers that Robert initially reported, it would run at 122.9MHz instead of the target 125MHz, a 1.7% slowdown.

marmeladapk, 2018-06-13:
_From @hartytp on April 2, 2018 7:35_

> Also, even with mor1kx, the magnitude of the timing failure is small: with the numbers that Robert initially reported, it would run at 122.9MHz instead of the target 125MHz, a 1.7% slowdown.

Yes, although I got the impression that there was some build to build variation in that.

> It's not "everything"; as I posted in m-labs/artiq#891 the LM32 processor has a lot less timing issues.

You're right "everything" is an exaggeration. Lot's of things won't be affected by having a slower FPGA. But, it is hurting us at the moment, and it seems likely that having a CPU that only just meets timing has the potential to cause more issues in the future.

Taking a step back for a moment: I think we all agree that ARTIQ is currently too slow, and that it needs to be speeded up in the future. We know the Artix FPGA on Kasli is slower than comparably priced Kintex FPGAs, and that this can cause issues. Given that, are we sure we don't want to consider using a faster FPGA? Even if we do switch to the LM32 and even if this does fix the timing issues we're currently seeing, are you really sure that the slower FPGA won't cause other problems in the future?

marmeladapk, 2018-06-13:
_From @hartytp on April 2, 2018 7:36_

Of course, if @gkasprow or @marmeladapk say it's too much work to consider for the next version of Kasli, then it may not be an option.

marmeladapk, 2018-06-13:
> Does your contract with WUT specify more than the standard two design rounds? If not, is this something that @marmeladapk and @gkasprow are doing on their own steam without and funding?

I'm not aware of the state of the funding. However week ago I thought that design was frozen and v1.2 was only cosmetic and QoL changes.

---

>> Wider ram will lead to board space and power, thermal issues and redesigns.

@hartytp, @jordens is right on this one. While I wouldn't worry about thermal and power issues (unless we're speaking about FPGA itself, we've got plenty of power left on 1,5 V rail, see schematics) redesign would be needed here. I feel, that current configuration is optimal and we don't have any room to fiddle with this design.

First, we would have to use another bank on FPGA for additional 16 bits. We can't share it with EEM banks since they use different voltages. So we have to get rid of at least 3 extensions (if we want to minimise work that would be eem0 to 2). This is the easiest option to implement. If we don't want to cut any corners then other options include expander and level shifter for all SFP control signals that could then share bank with SDRAM. That would require bottom half of FPGA (and eem0 to 7 and 10 to 11) to be rerouted.

We could also switch to bigger package (and to Artix 200T since we need an additional bank). This may or may not require to switch to 8 layers. I can't tell because on the one hand I need to escape with additional 16 length matched signals and on the other hand FPGA side is bigger. Obviously bigger package requires rerouting everything under and in the vicinity of the FPGA (+ power planes). And changing stackup will probably require changes to all impedance controlled lines.

> if there are simple changes that can make Kasli work better for the users then we should consider them

As I said, I think we don't have any easy ways to improve this design (apart from changing 100T to 200T in the same package, but more on that later).

**TL;DR**: Wider RAM is hard.

-----

> if we're struggling to make ARTIQ meet timing on Kasli

> Vivado insists on making mor1kx systems slow on Artix-7

Is this something that more resources could help? Or are we not using over 60-70% of them (can't check right now, I can't connect to our computers at uni)? Artix 200T is available in the same package. Xilinx says that it's pin compatible, it may only have other decoupling requirements.

Also, stupid question: have we tried different synthesis and implementation strategies? Xilinx recommends trying all of them and then choosing one that works best (seriously) if design barely doesn't meet timing. 1-2% could be gained there.

> ARTIQ is currently too slow

Is it only slow on Kasli or also on Sayma and KC705?

> Is it worth considering switching to a Kintex FPGA and maybe increasing the ram width

> Artix FPGA on Kasli is slower than comparably priced Kintex FPGAs (...) are we sure we don't want to consider using a faster FPGA?

I feel that this would be the change worthy of 2.0 version number. K70T has less resources that A100T so I don't feel that would be the optimal change. Only other FPGA available in 484 package is K160T. But we have to remember, that Xilinx FPGAs are not pin-compatible between families. So that would require rerouting everything under and near FPGA. Also some LVDS lines would have to use HP banks, so we would use 1,8 V LVDS. This should not be a problem for devices (probably, @gkasprow?), just noting. But we could then use HP bank for SDRAM. Not sure if this would help, @jordens and @sbourdeauducq should chime in here.

**TL;DR** Switching to Kintex-7 is also hard.

---

Overall my feelings are, that we're moving away from the idea of cheap and simpler controller that Kasli was supposed to be. Instead I feel like we're stepping closer to inventing MTCA from scratch, only with ribbon cables this time. And while I agree with @hartytp that ARTIQ on Kasli is too slow I wouldn't jump to conclusion that changing hardware right now is the solution. It looks like knee-jerk reaction TBH.

Perhaps giving more time (and funding?) to m-labs to optimize ARTIQ and underlying software could help? It would also translate to gains on all other boards now and in the future. If @sbourdeauducq says, that he didn't anticipate processor to be so slow on Artix and we didn't find a clear bottleneck who says that it won't repeat on small Kintex?

OFC if we find the bottleneck and it's for example RAM then let's change that. But I've outlined why these aren't simple changes.

marmeladapk, 2018-06-13:
_From @sbourdeauducq on April 2, 2018 12:54_

> Also, stupid question: have we tried different synthesis and implementation strategies? Xilinx recommends trying all of them and then choosing one that works best (seriously) if design barely doesn't meet timing. 1-2% could be gained there.

Yeah, I've been looking into this. I can make many mor1kx options meet timing on many variants (opticlock, sysu, master etc.) by using various Vivado commands, but what works on one variant doesn't often work on another and some combination of commands have very long runtime.

Trying a pin-compatible 200T FPGA is a good idea, and easy to change in the gateware - let me see if that improves timing.

marmeladapk, 2018-06-13:
Error when importing.

Closed 2018-06-13.

Thread 5 (2018-06-13):

Kasli v1.2 wishlist

marmeladapk, 2018-06-13:
_From @marmeladapk on [2018-01-31 09:53](https://github.com/sinara-hw/sinara/issues/499)_

- [ ] Rotate SATA connector
- [ ] Have I2C and UART signals in the same bank (each of them)
- [ ] Switch all components to our standard library
- [ ] Switch U1 to nonBGA version
- [ ] Maybe [Bigger heat sink](https://www.digikey.de/products/en/fans-thermal-management/thermal-heat-sinks/219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) with clamps pending measurements with big artiq setup
- [ ] Move the clock input SMA further towards the panel. Leave just enough gap for the insulating washer. Otherwise (with a gap, the two insulating washers, the panel, and the nut, even without the springy/claw washer) there is not enough thread to fully tighten an SMA connector.
- [ ] Si5369 instead of Si5324+ADCLK944 (power, board space, components, cost). Or even Si5346
- [x] Move UART RxD away from bank 13
- [x] Replace 100k resistors with 0R on the SMA clock input and MMCX clock outputs to tie all grounds together.
- [ ] Add note on schematic by the connectors saying something like "To float connector grounds, replace 0R with 100k. NB Kasli must be connected to mains ground for to avoid damage to it or other equipment connected to it!"
 - [ ] Add TVS on JTAG
 - [x] Make board 2-3 mm shorter, so that technosystem doesn't need to grind each board to mount backplane connector... (they told me about it after five months!)

marmeladapk, 2018-06-13:
_From @hartytp on [2018-01-31 14:02](https://github.com/sinara-hw/sinara/issues/499#issuecomment-361940819)_

Is there a Kasli v1.2 planned for any time in the future?

marmeladapk, 2018-06-13:
_From @jordens on [2018-01-31 14:38](https://github.com/sinara-hw/sinara/issues/499#issuecomment-361951448)_

I think we need more experience with it in the field to be able to say that.

marmeladapk, 2018-06-13:
_From @marmeladapk on [2018-01-31 14:44](https://github.com/sinara-hw/sinara/issues/499#issuecomment-361953185)_

First let's see how v1.1 operates, IMO points in the top post are not worth it right now.

marmeladapk, 2018-06-13:
_From @marmeladapk on [2018-02-02 21:04](https://github.com/sinara-hw/sinara/issues/499#issuecomment-362706992)_

> Change the Si5324 (loss of lock) LOL LED to red (as it indicates an error condition) or invert it.

@jordens Oh come on! You told me to change it from red to green so there are fewer items in the BOM. :D

Anyway LOL polarity can be changed in register 22 B1 of Si5324.

marmeladapk, 2018-06-13:
_From @jordens on [2018-02-03 07:57](https://github.com/sinara-hw/sinara/issues/499#issuecomment-362788316)_

Ah. Right. Then it's perfect. I forgot about both. ;)

marmeladapk, 2018-06-13:
_From @hartytp on [2018-03-28 21:45](https://github.com/sinara-hw/sinara/issues/499#issuecomment-377047747)_

The biggest thing I'd like to see changed on the list above is the heatsink, since the FPGA gets very hot atm. It might be worth going for a heatsink with a clip on fan.

marmeladapk, 2018-06-13:
_From @hartytp on [2018-03-28 23:31](https://github.com/sinara-hw/sinara/issues/499#issuecomment-377071799)_

- [ ] Replace 100k resistors with 0R on the SMA clock input and MMCX clock outputs to tie all grounds together.
- [ ] Add note on schematic by the connectors saying something like "To float connector grounds, replace 0R with 100k. NB Kasli must be connected to mains ground for to avoid damage to it or other equipment connected to it!"

marmeladapk, 2018-06-13:
_From @marmeladapk on [2018-03-29 08:30](https://github.com/sinara-hw/sinara/issues/499#issuecomment-377162583)_

I think we're slowly approaching point when we can think about next revision. Are there any other things we'd like to test before I start implementing changes? What's the consensus on Si5324/Si5369/Si5346?

marmeladapk, 2018-06-13:
_From @hartytp on [2018-03-29 09:06](https://github.com/sinara-hw/sinara/issues/499#issuecomment-377172387)_

@marmeladapk In the long run, I'm still potentially keen to implement WR on Kasli. Probably use a DAC + high-quality VCO for clock recovery. Then either use a LVPECL clock buffer (noise isn't critical here, so there are lots of options) or something like an AD9516-4 to do the fanout.

However, we're still doing a design study to make sure we get that right, so we won't have a design for that for another week or two.

Until/unless we switch to WR, I'm not fussed about any of the options being discussed. IMHO, the present clocking works well (modulo the stability/phase determinism issues with the Si5324) and none of the options presented above offer a good enough advantage in terms of cost/power/simplicity to be worth changing a working design and risking breaking things. However, if @jordens feels strongly about it, I don't object either.

marmeladapk, 2018-06-13:
_From @jordens on [2018-03-29 09:21](https://github.com/sinara-hw/sinara/issues/499#issuecomment-377176336)_

> Kasli must be connected to mains ground for to avoid damage to it or other equipment connected to it!

I don't think that is accurate and might even be wrong. I'd state how much potential difference we are willing and able to tolerate and what the actual ground paths in the system are. Like it is done on all measurement equipment.

@sbourdeauducq wanted to do tests with the Si5326 to guide that decision.

And I don't think a big heat sink will cut it. We have been equipping them with fans.

marmeladapk, 2018-06-13:
_From @hartytp on [2018-03-29 09:30](https://github.com/sinara-hw/sinara/issues/499#issuecomment-377178815)_

> And I don't think a big heat sink will cut it. We have been equipping them with fans.

:+1: Something like the heat sink on the KC705 would be nice.

> I don't think that is accurate and might even be wrong. I'd state how much potential difference we are willing and able to tolerate and what the actual ground paths in the system are. Like it is done on all measurement equipment.

AFAICT, connecting to PCB ground to mains ground is the most fool-proof solution, which should prevent damage in basically all cases (this is what almost all T&M equipment does), so it's an easy, safe recommendation to make -- I'm not aware of any situation where this could be dangerous/lead to damage, even if it's not often/always optimal from a noise perspective. Maybe change *must* to *should*, or even just re-word it to say that the potential difference between all grounds must be limited to safe-levels for all equipment, *for example* by connecting Kasli to mains ground?

Having said that, if you have a better suggestion, then feel free to make it (can you give exact text, please, including values for potential differences you want to recommend).

marmeladapk, 2018-06-13:
_From @hartytp on [2018-03-29 09:33](https://github.com/sinara-hw/sinara/issues/499#issuecomment-377179619)_

@jordens @sbourdeauducq I believe the answer to this is "no", but to double check: we don't think that a bigger FPGA/higher speed grade would help with anything we're doing? e.g. for large Kasli designs, we're not close to being limited by FPGA resources, right? and, the higher speed grade wouldn't ease the CPU timing issues?

marmeladapk, 2018-06-13:
_From @sbourdeauducq on [2018-03-29 10:28](https://github.com/sinara-hw/sinara/issues/499#issuecomment-377193363)_

After the siphaser system we introduced, I don't think the 5326 would improve anything significantly, it would just save something like one or two MMCMs in the FPGA since we can use the skew control registers instead. And if we start having it on any board, then we need to support both the 5324 and 5326 in the firmware. This family of chips appears to be exceptionally well-designed (case in point: the 5324 and 5326 are pin-compatible) and bug-free, so it's not a big issue if that has to be done, but why should we?

marmeladapk, 2018-06-13:
_From @sbourdeauducq on [2018-03-29 10:38](https://github.com/sinara-hw/sinara/issues/499#issuecomment-377195503)_

Note that the 5326 does **not** have deterministic latency - all it brings to the table is built-in functionality to increase or decrease whatever random skew it has after locking, and higher loop bandwidth. So, it doesn't help with getting deterministic phase from the external clock input to the ARTIQ outputs.

I am in favor of either:
* keeping the 5324 (the engineering costs associated with the change and the maintainance of multiple clock chip variants in the firmware do not seem to be worth using a 5326, 5369 or 5346).
* designing a high-performance PLL a la White Rabbit.

marmeladapk, 2018-06-13:
_From @hartytp on [2018-03-29 11:06](https://github.com/sinara-hw/sinara/issues/499#issuecomment-377201497)_

Thanks @sbourdeauducq. In that case, here is my suggestion:
- @WeiDaZhang keeps working on design of a WR implementation for Sinara, as well as carefully characterizing the performance of our current Si5324 setup and simulating/taking data on the performance of the WR system.
- We agree on a cut-off date for changes to the design for the next version of Kasli
- Once that cut-off date arrives:
  - if @WeiDaZhang's design isn't ready we stick with the current Si5324.
  - if we decide on the basis of @WeiDaZhang's measurements that the benefits from WR aren't sufficient to justify the changes, we stick with the Si5324
  - otherwise, we implement WR on Kasli for the next version.

Everyone happy with that plan? If so, what's the deadline for this decision?

marmeladapk, 2018-06-13:
_From @sbourdeauducq on [2018-03-29 11:18](https://github.com/sinara-hw/sinara/issues/499#issuecomment-377203830)_

> Change the Si5324 (loss of lock) LOL LED to red (as it indicates an error condition) or invert it.
>
> @jordens Oh come on! You told me to change it from red to green so there are fewer items in the BOM. :D

Do we need this LED at all? Lock status is accessible from the firmware. I've never used that LED personally.

marmeladapk, 2018-06-13:
_From @jbqubit on [2018-03-29 12:55](https://github.com/sinara-hw/sinara/issues/499#issuecomment-377225991)_

> AFAICT, connecting to PCB ground to mains ground is the most fool-proof solution

Agreed that this is the most fool-proof. The default configuration should protect casual end users as well as isolate the manufacturer from liability. The grounding implementation could be made so that it's easy to modify. Then modifications which might cause harm to body or the board itself are at the risk of the end user.

marmeladapk, 2018-06-13:
_From @sbourdeauducq on [2018-03-29 16:49](https://github.com/sinara-hw/sinara/issues/499#issuecomment-377299054)_

> Everyone happy with that plan?

Sounds fine, but integrating the WR PLL into ARTIQ doesn't sound trivial; we need to plan for the manpower and development time in the firmware and gateware (in addition to the hardware changes).

marmeladapk, 2018-06-13:
_From @hartytp on [2018-03-29 17:14](https://github.com/sinara-hw/sinara/issues/499#issuecomment-377306887)_

Absolutely, yes. That's an essential part of the cost / benefit analysis. But let's get a concrete proposal to discuss first...

marmeladapk, 2018-06-13:
_From @hartytp on [2018-04-01 08:07](https://github.com/sinara-hw/sinara/issues/499#issuecomment-377770512)_

> Sounds fine, but integrating the WR PLL into ARTIQ doesn't sound trivial; we need to plan for the manpower and development time in the firmware and gateware (in addition to the hardware changes).

If we do go down the WR route, I'd still want to keep the Si5324 as well for at least the next version. Obviously, we would want to be able to use Kasli even while the WR gateware/firmware is developed and debugged.

marmeladapk, 2018-06-13:
_From @hartytp on [2018-04-01 08:19](https://github.com/sinara-hw/sinara/issues/499#issuecomment-377771120)_

Is it worth considering switching to a Kintex FPGA and maybe increasing the ram width (cf the DMA issues @cjbe reported) for the next version?

Speed seems to be by far the biggest complaint of ARTIQ users, and the fact that Kasli is noticeably slower than the KC705 setups we've used in the past seems like a major step in the wrong direction. I'm all for optimising gateware/firmware, but it seems silly not to start from the fastest hardware platform we reasonably can -- I'm not sure about other users (@dhslichter @dtcallcock etc), but I would gladly pay a bit more for HW if it made my setups faster.

marmeladapk, 2018-06-13:
_From @jordens on [2018-04-01 09:00](https://github.com/sinara-hw/sinara/issues/499#issuecomment-377773031)_

I'm against that. Lets keep kasli at the simple end. It was well known and acknowledged that it would be slower. Wider ram will lead to board space and power, thermal issues and redesigns. You are obviously free to fund a new device with a bigger fpga though.

marmeladapk, 2018-06-13:
_From @hartytp on [2018-04-01 14:09](https://github.com/sinara-hw/sinara/issues/499#issuecomment-377789367)_

>  Lets keep kasli at the simple end.

"Simple" doesn't have to equal "slow". I'm not convinced that putting a faster FPGA on there makes it not a simple design.

> It was well known and acknowledged that it would be slower.

Really? That wasn't my impression. When I discussed this via email with you and @sbourdeauducq before Kasli v1.0's design was finalised I explicitly asked about whether there would be CPU frequency issues with the ARTIQ, and was told that there wouldn't be.

In any case, I think this point is largely irrelevant. What matters is whether, having used this in the lab and knowing what we know now, we still think the current design is the right one for the users, or whether changing the FPGA would be better. Let's not get hung up on why decisions were made.

> You are obviously free to fund a new device with a bigger fpga though.

Firstly: I read that to imply that you are funding work on the next Kasli revision. Is that actually true? Does your contract with WUT specify more than the standard two design rounds? If not, is this something that @marmeladapk and @gkasprow are doing on their own steam without and funding? If so, I don't see why you're bringing up funding here.

Secondly: I've worked hard to avoid hardware fragmentation in this project because I (still) believe that's the only way we're going to get a set of high-quality, well supported hardware which is stocked at good prices from a commercial vendor. If we all take the line of "this is my project, so if you don't like it then make your own version" then we're going to end up with a multiplicity of shoddy boards. I think we can be a bit more mature than that and work to find solutions that work for everyone.

Thirdly: while you may have funded the original version of Kasli, if you want someone like Creotech to stock it then they have to believe that it's what the users want. So, let's have an discussion that focusses on technical points, rather than shutting things down with "this is my project, go away".

> Wider ram will lead to board space and power, thermal issues and redesigns.

You've made this kind of assertion several times in this project only to be contradicted by @marmeladapk, who is actually doing the design work and has done the simulations. If you've done a simulation or have anything concrete to back up these claims then I'd love to hear about them. But, otherwise, I'd rather hear from @gkasprow or @marmeladapk.

---

tl;dr: if other users don't think a bigger FPGA is worth it (maybe this is worth addressing to the ARTIQ mailing list), or if @gkasprow or @marmeladapk think that it would be too much work/cause other issues, then let's leave it as is. But, if there are simple changes that can make Kasli work better for the users then we should consider them.

After all, it's not like the current FPGA on Kasli isn't causing problems right now, and that makes me concerned that in the long run it's not a very good choice.

marmeladapk, 2018-06-13:
_From @hartytp on [2018-04-01 14:12](https://github.com/sinara-hw/sinara/issues/499#issuecomment-377789550)_

>  It was well known and acknowledged that it would be slower.

Again, I'd love to hear from one of the other groups who are actually using ARTIQ to run experiments with (e.g. @dtcallcock @dhslichter) but my feeling is that the current slowness of ARTIQ makes it a massive pain in the neck for most use cases. Anything that makes it even slower is of very limited interest as far as I'm concerned.

marmeladapk, 2018-06-13:
_From @hartytp on [2018-04-01 14:40](https://github.com/sinara-hw/sinara/issues/499#issuecomment-377791361)_

To be a bit more concrete here, my concerns are things like: if we're struggling to make ARTIQ meet timing on Kasli as it is, what will happen when we want to add features like hard floating-point maths? Will we just have to accept that they aren't available on Kasli because we put a slow FPGA on it?

marmeladapk, 2018-06-13:
_From @sbourdeauducq on [2018-04-01 14:57](https://github.com/sinara-hw/sinara/issues/499#issuecomment-377792463)_

> It was well known and acknowledged that it would be slower.
>
> Really? That wasn't my impression. When I discussed this via email with you and @sbourdeauducq before Kasli v1.0's design was finalised I explicitly asked about whether there would be CPU frequency issues with the ARTIQ, and was told that there wouldn't be.

I guess @jordens is talking about the RAM, which is obviously slower than on KC705 (16-bit vs. 64-bit data bus).
How strongly Vivado insists on making mor1kx systems slow on Artix-7, on the other hand, is a bit of a surprise. Switching to 7K70T might be OK (it's not much more expensive), if it weren't for the major PCB design change, plus another round of transceiver yak-shaving to make DRTIO and Ethernet work again (among their many problems, transceivers are not compatible between FPGA families and each comes with its own set of idiosyncrasies and obscure bugs).

marmeladapk, 2018-06-13:
_From @sbourdeauducq on [2018-04-01 15:28](https://github.com/sinara-hw/sinara/issues/499#issuecomment-377794423)_

> How strongly Vivado insists on making mor1kx systems slow on Artix-7, on the other hand, is a bit of a surprise.

Part of the reason it's a surprise is because uniprocessor systems (e.g. the DRTIO satellite, and other MiSoC ports to Artix-7 boards) meet timing; the problems appear with the ARTIQ dual-CPU design for some reason.

marmeladapk, 2018-06-13:
_From @hartytp on [2018-04-01 17:28](https://github.com/sinara-hw/sinara/issues/499#issuecomment-377802564)_

> I guess @jordens is talking about the RAM, which is obviously slower than on KC705 (16-bit vs. 64-bit data bus).

Yes, that the RAM on Kasli is obviously slower than the KC705. However, I'm not sure that the effects that has on ARTIQ DMA were obvious or anticipated (the RAM bandwidth is still pretty huge).

However, that can probably be sorted with a more efficient RAM controller, so it may be that no HW changes are needed here. Although, it's still not clear to me that the cost of adding a wider RAM bus to Kasli is actually that high, so it might still be worth considering.

marmeladapk, 2018-06-13:
_From @hartytp on [2018-04-01 17:32](https://github.com/sinara-hw/sinara/issues/499#issuecomment-377802848)_

> How strongly Vivado insists on making mor1kx systems slow on Artix-7, on the other hand, is a bit of a surprise.

Yes, this concerns me much more than the RAM.

> if it weren't for the major PCB design change

IIRC, there will need to be some substantial re-routing to add a bigger heatsink, so now is the time to consider that. @marmeladapk @gkasprow what's your feeling about this? How hard would that be to do?

> plus another round of transceiver yak-shaving to make DRTIO and Ethernet work again (among their many problems, transceivers are not compatible between FPGA families and they each come with their own set of idiosyncrasies and obscure bugs).

ACK. That's a reasonable point. However, what do you think is going to be more work in the long run: fixing the transceivers once or fighting against slow silicon on Kasli for everything we do?

marmeladapk, 2018-06-13:
_From @hartytp on [2018-04-01 17:34](https://github.com/sinara-hw/sinara/issues/499#issuecomment-377802981)_

> Part of the reason it's a surprise is because uniprocessor systems (e.g. the DRTIO satellite, and other MiSoC ports to Artix-7 boards) meet timing; the problems appear with the ARTIQ dual-CPU design for some reason.

Yes, that is a bit concerning. And, again, it doesn't give me much confidence that issues to do with Artix FPGAs being slow won't be a recurring theme as we develop ARTIQ further, e.g. by adding hard FP.

marmeladapk, 2018-06-13:
_From @sbourdeauducq on [2018-04-02 02:45](https://github.com/sinara-hw/sinara/issues/499#issuecomment-377841329)_

> ACK. That's a reasonable point. However, what do you think is going to be more work in the long run: fixing the transceivers once or fighting against slow silicon on Kasli for everything we do?

It's not "everything"; as I posted in https://github.com/m-labs/artiq/issues/891 the LM32 processor has a lot less timing issues. Also, even with mor1kx, the magnitude of the timing failure is small: with the numbers that Robert initially reported, it would run at 122.9MHz instead of the target 125MHz, a 1.7% slowdown.

marmeladapk, 2018-06-13:
_From @hartytp on [2018-04-02 07:35](https://github.com/sinara-hw/sinara/issues/499#issuecomment-377875472)_

> Also, even with mor1kx, the magnitude of the timing failure is small: with the numbers that Robert initially reported, it would run at 122.9MHz instead of the target 125MHz, a 1.7% slowdown.

Yes, although I got the impression that there was some build to build variation in that.

> It's not "everything"; as I posted in m-labs/artiq#891 the LM32 processor has a lot less timing issues.

You're right "everything" is an exaggeration. Lot's of things won't be affected by having a slower FPGA. But, it is hurting us at the moment, and it seems likely that having a CPU that only just meets timing has the potential to cause more issues in the future.

Taking a step back for a moment: I think we all agree that ARTIQ is currently too slow, and that it needs to be speeded up in the future. We know the Artix FPGA on Kasli is slower than comparably priced Kintex FPGAs, and that this can cause issues. Given that, are we sure we don't want to consider using a faster FPGA? Even if we do switch to the LM32 and even if this does fix the timing issues we're currently seeing, are you really sure that the slower FPGA won't cause other problems in the future?

marmeladapk, 2018-06-13:
_From @hartytp on [2018-04-02 07:36](https://github.com/sinara-hw/sinara/issues/499#issuecomment-377875650)_

Of course, if @gkasprow or @marmeladapk say it's too much work to consider for the next version of Kasli, then it may not be an option.

marmeladapk, 2018-06-13:
_From @marmeladapk on [2018-04-02 12:38](https://github.com/sinara-hw/sinara/issues/499#issuecomment-377920810)_

> Does your contract with WUT specify more than the standard two design rounds? If not, is this something that @marmeladapk and @gkasprow are doing on their own steam without and funding?

I'm not aware of the state of the funding. However week ago I thought that design was frozen and v1.2 was only cosmetic and QoL changes.

---

>> Wider ram will lead to board space and power, thermal issues and redesigns.

@hartytp, @jordens is right on this one. While I wouldn't worry about thermal and power issues (unless we're speaking about FPGA itself, we've got plenty of power left on 1,5 V rail, see schematics) redesign would be needed here. I feel, that current configuration is optimal and we don't have any room to fiddle with this design.

First, we would have to use another bank on FPGA for additional 16 bits. We can't share it with EEM banks since they use different voltages. So we have to get rid of at least 3 extensions (if we want to minimise work that would be eem0 to 2). This is the easiest option to implement. If we don't want to cut any corners then other options include expander and level shifter for all SFP control signals that could then share bank with SDRAM. That would require bottom half of FPGA (and eem0 to 7 and 10 to 11) to be rerouted.

We could also switch to bigger package (and to Artix 200T since we need an additional bank). This may or may not require to switch to 8 layers. I can't tell because on the one hand I need to escape with additional 16 length matched signals and on the other hand FPGA side is bigger. Obviously bigger package requires rerouting everything under and in the vicinity of the FPGA (+ power planes). And changing stackup will probably require changes to all impedance controlled lines.

> if there are simple changes that can make Kasli work better for the users then we should consider them

As I said, I think we don't have any easy ways to improve this design (apart from changing 100T to 200T in the same package, but more on that later).

**TL;DR**: Wider RAM is hard.

-----

> if we're struggling to make ARTIQ meet timing on Kasli

> Vivado insists on making mor1kx systems slow on Artix-7

Is this something that more resources could help? Or are we not using over 60-70% of them (can't check right now, I can't connect to our computers at uni)? Artix 200T is available in the same package. Xilinx says that it's pin compatible, it may only have other decoupling requirements.

Also, stupid question: have we tried different synthesis and implementation strategies? Xilinx recommends trying all of them and then choosing one that works best (seriously) if design barely doesn't meet timing. 1-2% could be gained there.

> ARTIQ is currently too slow

Is it only slow on Kasli or also on Sayma and KC705?

> Is it worth considering switching to a Kintex FPGA and maybe increasing the ram width

> Artix FPGA on Kasli is slower than comparably priced Kintex FPGAs (...) are we sure we don't want to consider using a faster FPGA?

I feel that this would be the change worthy of 2.0 version number. K70T has less resources that A100T so I don't feel that would be the optimal change. Only other FPGA available in 484 package is K160T. But we have to remember, that Xilinx FPGAs are not pin-compatible between families. So that would require rerouting everything under and near FPGA. Also some LVDS lines would have to use HP banks, so we would use 1,8 V LVDS. This should not be a problem for devices (probably, @gkasprow?), just noting. But we could then use HP bank for SDRAM. Not sure if this would help, @jordens and @sbourdeauducq should chime in here.

**TL;DR** Switching to Kintex-7 is also hard.

---

Overall my feelings are, that we're moving away from the idea of cheap and simpler controller that Kasli was supposed to be. Instead I feel like we're stepping closer to inventing MTCA from scratch, only with ribbon cables this time. And while I agree with @hartytp that ARTIQ on Kasli is too slow I wouldn't jump to conclusion that changing hardware right now is the solution. It looks like knee-jerk reaction TBH.

Perhaps giving more time (and funding?) to m-labs to optimize ARTIQ and underlying software could help? It would also translate to gains on all other boards now and in the future. If @sbourdeauducq says, that he didn't anticipate processor to be so slow on Artix and we didn't find a clear bottleneck who says that it won't repeat on small Kintex?

OFC if we find the bottleneck and it's for example RAM then let's change that. But I've outlined why these aren't simple changes.

marmeladapk, 2018-06-13:
_From @sbourdeauducq on [2018-04-02 12:54](https://github.com/sinara-hw/sinara/issues/499#issuecomment-377923344)_

> Also, stupid question: have we tried different synthesis and implementation strategies? Xilinx recommends trying all of them and then choosing one that works best (seriously) if design barely doesn't meet timing. 1-2% could be gained there.

Yeah, I've been looking into this. I can make many mor1kx options meet timing on many variants (opticlock, sysu, master etc.) by using various Vivado commands, but what works on one variant doesn't often work on another and some combination of commands have very long runtime.

Trying a pin-compatible 200T FPGA is a good idea, and easy to change in the gateware - let me see if that improves timing.

marmeladapk, 2018-06-13:
_From @hartytp on [2018-04-02 13:39](https://github.com/sinara-hw/sinara/issues/499#issuecomment-377931006)_

Thanks for the detailed explanation @marmeladapk! If wider RAM/a faster FPGA isn't an option for the next revision then that makes the decision for us, at least for the time being.

I guess that so long as we press ahead with Metlino, we should have a genuine high-performance option in case Kasli proves problematic.

> Is it only slow on Kasli or also on Sayma and KC705?

I can't comment on Sayma yet, but ARTIQ is definitely slow on the KC705. However, we're seeing new issues with Kasli that we didn't see on the KC705 and that concerns me.

> Perhaps giving more time (and funding?) to m-labs to optimize ARTIQ and underlying software could help?

I think we all agree that this is essential (I believe there is already an effort underway to do this). However, ARTIQ is quite a long way from the point where speed wouldn't be an issue, so it seems like a step in the wrong direction to move to a slower hardware platform. And, again, the concern is that even if we do eek out a few extra percent to get the CPU to meet timing, what will happen when we try to add future improvements like hard FP? Will the slower FPGA make that
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

Thread 10 (2018-07-13):

sort out grounding...

hartytp, 2018-07-13:

jordens, 2018-12-18:
@hartytp details and context for this? clock or power or switcher or FPGA or panel?

marmeladapk, 2018-12-18:
I think @hartytp meant what you outlined in #26.

hartytp, 2018-12-18:
@jordens not sure why this doesn't have a description. Let's assume that what I meant was
1. Change default population options to avoid floating the MMCXs
2. Add RC components to allow the FP to be floated, but populate the R with 0R so that by default the FP is tied to circuit ground
3. Use nice FPs with EMC gaskets

Essentially, follow the same grounding strategy we're using in other boards now.

jordens, 2018-12-18:
and ground the SMA input as well.

jordens, 2018-12-18:
Let's implement the MMCX and SMA changes ASAP.

marmeladapk, 2019-01-08:
a87c75c

Closed 2019-01-08.

Thread 7 (2018-07-13):

[RFC] Bigger heat sink

hartytp, 2018-07-13:
- [ ] Use a larger heat sink, maybe with a fan like the one on KC705. Use a clip on heat sink instead of a glue on one.

cf https://github.com/sinara-hw/Kasli/issues/5 and https://github.com/sinara-hw/Zotino/issues/4

sbourdeauducq, 2018-07-13:
IMO this is the biggest problem with Kasli right now; the current solution of gluing fans and soldering their wires onto other components of the PCB is not nice.

sbourdeauducq, 2018-07-13:
If 2.0 takes a long time, adding a fan power connector would be a minor change and already a welcome improvement.

marmeladapk, 2019-08-21:
Since I had to move EEM connectors because of SFP connector I will also move the FPGA away from EEM connectors. This will allow me to place heatsink with fan like this: https://cofan-usa.com/pdf/30-2304_REV01.pdf

I couldn't find any heatsinks with fans for 23mm x 23mm package.

If you have a tried heatsink with fan please let me know.

marmeladapk, 2019-09-10:
Closing in favour of #44

Closed 2019-09-10.

Thread 9 (2018-07-13):

[RFC] internal power connector

hartytp, 2018-07-13:
consider adding an internal ATX or other 12V power connector

jordens, 2018-07-13:
The backplane connector or the backplane adapter are already made specifically for that. I'd avoid adding a fourth power input option. It's another part on the bin, another piece that must be documented, and another source of confusion and risk.

gkasprow, 2018-07-13:
We can use RA version of one used on Sayma

hartytp, 2018-07-13:
> The backplane connector or the backplane adapter are already made specifically for that. I'd avoid adding a fourth power input option. It's another part on the bin, another piece that must be documented, and another source of confusion and risk.

True.

I'm not fussed about whether or not we have this or not. I raised it now because I was going over the old issues to break the discussions out into individual issues per item where possible, and this was something we'd discussed before.

> We can use RA version of one used on Sayma

You mean on the BP adapter?

sbourdeauducq, 2018-07-25:
I would like most Kasli systems to use an internal power supply:
* The power brick doesn't fit well in a rack.
* Many systems have free space in the crate that the power module could use.
* The current power supply solution looks a bit consumer/amateur.
* If you build a crate with two Kasli and DRTIO, there is a nice solution to transfer data (use the internal SATA connector) but having two power bricks or a DC connector splitter isn't good.

It seems to me that imposing a backplane adapter on those systems is expensive, bulky and slightly difficult to assemble, compared to adding an ATX connector on the Kasli PCB. Unlike ATX connectors, the DIN 41612 connector isn't meant to be wired directly to a small cable, so a PCB adapter would be necessary to do that cleanly.

@jordens What are the risks with that ATX connector? And, to reduce options, I'm actually happy to do away with the front panel power connector, if we have a nice internal power supply solution.

gkasprow, 2018-07-25:
We discussed it already that PSU + mains filter + IEC socket attached to the chassis rear wall is optimal solution. full ATX connector is LARGE.
It's better to add 4 pin Molex connector ( right angle) that we use on Sayma.
There is idea to merge Kasli with its backplane as single board - cost difference would be negligible.

gkasprow, 2018-07-25:
If you define exact PN of chassis, we can prepare such rear wall with cutout and remaining stuff.
2 or 3 wall lengths would do the job. Maybe one needs to have some other cutouts for i.e. SMA connectors?

jordens, 2018-07-25:
@sbourdeauducq The risks associated with adding an ATX or molex connector (changes in layout, knock on effects due to other parts being moved, things that can go wrong when using that connector, pinout uncertainty, parts supply, manufacturing the pig-tail) are probably not your biggest problem and not what you want to focus on. Have you looked at the regulatory situation in the different countries? What about certification and safety issues?
If you figure out all the issues then it sounds still much simpler and less risky to either have a 8HP wide module with IEC input and 12V barrel output that you jumper at the front panel into Kasli. That does not break other people's use cases and does not worsen the crate cabling situation by adding another set of cables on top of the ribbon + coax set.
I'm also fine with integrating the BP adapter into Kasli and making Kasli a 200mm card (still fully standard) with a Molex connector instead of the dual barrel connectors in the back. Then there is just two powering options instead of potentially four.
@gkasprow The rear wall in most use cases is currently just a 84HP panel. If you are dead set to put a PSU inside the crate covering different crates and use cases, then I'd just make it a 3U/42HP shallow device to operate next to a 3U/42HP filler panel on the back or a 3U/8HP deep device either for the front or the back. The latter could fit fine opposing a short EEM (*DIO,IDC-BNC,HD68-IDC,Clocker).

sbourdeauducq, 2018-07-25:
> It's better to add 4 pin Molex connector ( right angle) that we use on Sayma.

Yes, I meant that connector (it's also called ATX 4-pin I think?) - not the large motherboard one. There are no pinout uncertainties with that one. Or any other simple connector, really.

> There is idea to merge Kasli with its backplane as single board - cost difference would be negligible.

I'm afraid this might cause chassis compatibility problems.

We should definitely avoid getting locked into one chassis PN; there are often sourcing issues with them so it is better to keep many options.

> The rear wall in most use cases is currently just a 84HP panel.

There are many systems that fit in a 42hp crate.

> If you are dead set to put a PSU inside the crate covering different crates and use cases, then I'd just make it a 3U/42HP shallow device to operate next to a 3U/42HP filler panel on the back or a 3U/8HP deep device either for the front or the back.

These options sound good, except that it could potentially be problematic to insert a device from the back (the card guides are not symmetrical in some chassis).

jordens, 2018-07-25:
The usual 235mm depth crates (DIN: Fischer, Schroff, Vector) would work fine holding a 220mm (standard eurocard) Kasli. I don't care whether the card extends beyond the 160mm rails or whether we would use the 220mm rails.
And I don't think you need card guides at all if the supply is bolted flat to the rear panel. And yes, they are not symmetric. I just rotate them and since the horizontal rails are strictly symmetric that works fine.  Does that not work for you?

hartytp, 2019-05-07:
What's the conclusion here? Does anyone still want an ATX connector or shall we just scrap this idea (in the long run, we may be able to power via a BP connector)? I'm not fussed either way.

gkasprow, 2019-05-07:
We won't have the backplane connector anymore. So right angle Molex connector or dual footprint (Molex / DC Jack) would be useful.

jordens, 2019-05-08:
If the dual footprint is not a problem, then do it. Tight angle 4 pin Molex being default.

marmeladapk, 2019-05-08:
So right angle dual footprint if possible on the back AND front panel DC jack?

jordens, 2019-05-08:
Barrel only to the front and dual to the back with Molex default.
The Molex Is imo not suitable for external connectivity.

marmeladapk, 2019-08-21:
I placed the same connector as in banker + DC jack connector.
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

Closed 2019-08-28.

Thread 11 (2018-07-25):

Extend Kasli to 200mm

hartytp, 2018-07-25:
- Essentially, merge the current "Kasli BP adapter" with Kasli.
- moving discussion from #9

This is something I'd personally be very keen on for the next batch of Kasli. We will make heavy use of those extra EEM slots (SU-servo eats EEMs), and this gets rid of the annoying BP adapter + associated mechanical issues. Most racks I've looked at work fine with 200mm eurocards.

sbourdeauducq, 2018-07-25:
Oh right, I misunderstood what was meant by "merge with its backplane". Then this sounds fine to me.

marmeladapk, 2019-08-21:
I extended Kasli, but not to 220mm. @gkasprow requested that I conserve some space for a CPCI backplane adapter. For EEM8-11 connectors I used the same layout as on backplane adapter for easier routing.

```
                       8  9
0  1  2  3  4  5  6  7 10 11
```

jordens, 2019-08-22:
Fine.
What about reducing the space between the IDC connectors?

1. IME the IDC connectors can only be detached by pulling on the ribbon.
2. The standard way of crimping ribbon cables is such that the ribbon is pointing to the front panel on one end, i.e. "the wrong way".
3. An IDC strain relief clamp that folds the cable can only be used on 8HP cards.

Therefore adding a IDC ribbon strain relief on the Kasli end is convenient and addresses all three constraints.

gkasprow, 2019-08-22:
True. The 3M strain relief IDC assemblies enable higher density packaging of IDC headers. They can be pulled by the ribbon.

marmeladapk, 2019-09-10:
@jordens Reducing the space between IDC connectors is a minor change that requires a lot of work.

jordens, 2019-09-10:
ACK. This was only meant to point out a possible way to save space if you need it.

Thread 12 (2018-08-06):

ground front panel

gkasprow, 2018-08-06:
- [ ] ground front panel

hartytp, 2019-10-01:
Done AFAICT so closing (but please reopen if I'm wrong about that)

Closed 2019-10-01.

Thread 14 (2018-08-18):

Kasli SI/Remote EEMs

gkasprow, 2018-08-18:
_From @hartytp on April 17, 2018 9:24_

I thought there was already an issue for this, but I can't find it now :(

- I've done some basic testing to look at SI when Kasli is used with long EEM cables.
- Part of the idea here was to investigate the feasibility of using Kasli with "remote EEMS" -- EEMs connected to Kasli via a long cable (e.g. a SCSI cable, using a VHDCI_CARRIER card at each end as a VHDCI<->IDC adapter). Remote EEMs are potentially useful for things like {S,N}U-servo where one wants an ADC connected to a remote Kasli, but does not want the link to go via DRTIO.
- Design is here: https://github.com/hartytp/artiq/tree/kasli_si_test  -- it was a bit of a learning experience, so a few rough edges, but does the job
- Artiq experiment used to collect data is here: https://hastebin.com/rajoyuvegu.py
- Test uses EEM0 on Kasli as a data source, EEM1 as a sink. EEM contains a 7-bit counter as a data source and a 1-bit framing signal. Data rate is 125MHz DDR.

_Copied from original issue: sinara-hw/sinara#543_

Closed 2018-08-21.

Thread 15 (2018-08-18):

PCA9548 failed to ack write address

gkasprow, 2018-08-18:
_From @hartytp on April 11, 2018 22:4_

One of my Kasli boards is now showing up this error on boot "panic at src/libcore/result.rs:906: cannot initialize Si5324: "PCA9548 failed to ack write address"

_Copied from original issue: sinara-hw/sinara#540_

gkasprow, 2018-12-12:
Was this PCA9548 failed last time? How did Technosystem repaired it? They replaced this chip?
Did it die just itself or after configuration of boards changed?

hartytp, 2018-12-12:
Sorry, I wasn't clear. This is a different Kasli (TechnoSystem replaced the old one with a Kasli v1.1 with higher speed-grade FPGA).

I think the board configuration was changed.

gkasprow, 2018-12-12:
ESD is one issue, mains filter EMC filter capacitors charge is another issue that can kill such chip

Closed 2018-08-21.

Thread 16 (2018-08-18):

Kasli/v1.1 clock distribution

gkasprow, 2018-08-18:
_From @jordens on March 7, 2018 19:33_

The single ended clock outputs on board have gotten quite a bit noisier than in v1.0. Haven't checked AM vs PM. And the 440 kHz spur from before is now at 300 kHz. This is opticlock with free_run.

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

_Copied from original issue: sinara-hw/sinara#525_

Closed 2018-08-21.

Thread 17 (2018-08-20):

BNX022 soldering issue

sbourdeauducq, 2018-08-20:
Sometimes the solder blob on a BNX022 pad touches the component lead but does not wet it. This causes an unreliable connection and a nasty problem where a board passes tests but no longer powers on after shipping, as the vibrations broke the connection.
Might be a problem with the coating of the lead on some BNX022s as it is unusually difficult to make the solder wet when fixing it manually.

gkasprow, 2018-08-20:
Can you take a photo and post it here please?

sbourdeauducq, 2018-08-26:
It seems the coating is ok, the problem is the large metallic part connected to the ground pins inside the BNX022, which sinks heat (the problem happens on GND but I haven't seen it on +12V).

hartytp, 2019-05-07:
@gkasprow what do we do about this?

gkasprow, 2019-05-07:
There is already the thermal relief used for this part so we cannot do much from PCB design perspective.
One must pay attention during inspection and tests.

hartytp, 2019-05-07:
Ack. I guess these kind of issues are best fed back directly to the manufacturer.

Closed 2019-05-07.

Thread 18 (2018-08-30):

Change power sequence

marmeladapk, 2018-08-30:
S25FL128S (FPGA memory) datasheet states:

>During the rise of power supplies the V_IO supply voltage must remain less than or equal to the V_CC supply voltage.

Changing power sequence to bring 3V3 after 1V0 would also allow to ramp 1V8 after 1V0 and 2V5 after 1V8, which would be in line with Xilinx suggested sequence (current sequence is acceptable, but may cause higher current draw during power-on).

marmeladapk, 2019-05-08:
New power-up sequence:
12 V -> 1,0 V -> 3,3 V -> 1,8 V -> 2,5 V -> 1,5 V & 1,2 V

Closed 2019-05-08.

Thread 19 (2018-10-22):

WR PLL/ clock recover

hartytp, 2018-10-22:
Issue to discuss how a WR PLL could be implemented on Kasli (not necessarily suggesting that it *should* at this stage).

- As discussed elsewhere, we wish to use a Digitally Controllable Crystal Oscillator (DCXO) for the oscillator, combined with DDMTD for the phase detector.
- The only good choices of DCXO that we've seen so far are: Si549, LMK61e07, Si570. Si570 is a lower cost option with significantly worse noise. We're having issues getting the LMK61e07 to meet its specified performance, debugging is ongoing. Our current preference is the Si549 as it's very well documented and seems to work as expected without surprises.
- All three DCXO candidates use the same footprint and can be supported by population options. I suggest that we do that and pick the Si549 as out default population
- We should maintain support for the Si5324 at least in the next version, both for risk mitigation and to support easier switching to other clock frequencies until we have really good WR design tools.
- We need a fanout after the DCXO to drive the FPGA + EEM MMCXs. Suggest that we make this fanout a 2-input mux and drive one input from the DCXO and the other from the Si5324. One output routes to the FPGA 'MGTREFCLK_0_216' input
- DCXO needs its own dedicated I2C bus to allow updating at max rate
- DDMTD needs a "helper" oscillator. The noise for this isn't important. Can be either a Si549 or an Si570 depending on which is cheaper (does it cost less to have fewer BOM lines or to use simpler components)? The helper needs its own dedicated I2C bus as well. The helper must drive a cc pin on the fpga
- In "master" mode the SMA supplies the reference clock. This clock must not go through the Si5324 to avoid degrading the noise/stability of the reference
- In principle this can route to either a cc pin or to a MGTREF pin. In our tests on the KC705 we've always used a MGTREF pin (that was the easiest to access), but there is no fundamental reason why it has to. However, we have not directly checked the noise/stability when using a standard CC pin.
- It would be nice to connect the SMA to a MGTREF pin so that in master mode the transceivers can be clocked directly from the SMA instead of the DCXO/WR-PLL. In principle the transceivers can be clocked from a fabric clock, but that doesn't seem to be a "preferred" option
- Currently `MGTREFCLK1_216` is used by the on-board xtal. As I understand it, the reason for doing this is that the GbE needs a 125MHz clock, but some users may wish to run the WR PLL at a frequency different to 125MHz. @jordens @sbourdeauducq ***am I correct in thinking that it's not an option to route the SMA input to this for the WR reference? If so, we need to use the CC input and measure its performance on a KC705***
- The SMA should still feed one input of the Si5324 (as it currently does). This can either be done by having the SMA feed an FPGA cc pin and then connect an FPGA differential output to the Si5324. The FPGA can loop the clock back. There will be a small amount of degradation of the quality of the signal but, given the known issues with the Si5324, that's probably ok -- the Si5324 will not be used for critical clocks anyway. The other option is to add a fanout before the FPGA. That's a nice option anyway as it provides some protection to the FPGA input against signals from the outside world.
- The `CLKREC` signal is not needed by WR and can be left routed to the Si5324

Comments @jordens @sbourdeauducq @gkasprow @marmeladapk

One issue that I see is that there are few (no?) spare pins on the FPGA. This will require some thought!

WeiDaZhang, 2018-10-29:
> In principle this can route to either a cc pin or to a MGTREF pin. In our tests on the KC705 we've always used a MGTREF pin (that was the easiest to access), but there is no fundamental reason why it has to. However, we have not directly checked the noise/stability when using a standard CC pin.

> As I understand it, the reason for doing this is that the GbE needs a 125MHz clock, but some users may wish to run the WR PLL at a frequency different to 125MHz.

We are trying to determine if the GTP on Kasli can be driven by a reference input through a pair of MRCC pins, without worsening phase noise and stability of the clock transferred through the serial link.
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
A test is done as the diagram shown.
The data on the serial link is configured to be periodic, therefore the phase noise of the data itself can be measured. Though the far-end phase noise is probably whiten by the data, the close-in phase noise should reflect the phase noise of the transmitted clock.
The Tx User Clock is driven by `TXOUTCLKPMA`, the stability of which should indicate the wander/jitter caused by the clock path inside the FPGA.

The test result is interesting, the MRCC pins provide better performance on both phase noise and stability comparing to MGTREF pins, - the default and suggested GTP reference input pins.

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

The stability difference between the two reference paths is about a factor of 2, which is not much. The phase noise difference however is rather big, especially between 10Hz to 100Hz (where the loop filter bandwidth of WR and Si5324 lies), around 10dB.
The result basically suggests, for better-recovered clock at the slave end, the master should use the MRCC pins to drive the GTP and send the data, which is quite opposite to what [Xilinx suggested](https://forums.xilinx.com/t5/7-Series-FPGAs/Using-GTGREFCLK-on-V7-GTP/m-p/685353#M15626).

My hypothesis is that MRCC is less decoupled from the core power supply of the FPGA, while MGTREF is less decoupled from GTP power supply.
During the test, the core of the FPGA is basically idle, but the GTP is fairly busy, which makes MGTREF works not as good as MRCC.

We are doing the test with some work loaded to the FPGA core to see if any difference it makes.

Any other suggestions? @gkasprow @sbourdeauducq  Thanks.

sbourdeauducq, 2018-10-30:
My understanding is that Xilinx decoupled the transceiver clock from the fabric network to make it immune to whatever is happening in the fabric, causing noise that can depend on the bitstream and the data the fabric is processing (from power supplies but also crosstalk).
If we re-characterize this, we have to be very careful and do it over a wide range of fabric activity spread across many resources, including switching activity on different clock networks. We should also make sure that the hardware allows us to fall back on the recommended clocking connection if we experience unforeseen problems. The Xilinx docs are pretty clear that the fabric clock input should not be used.

hartytp, 2018-12-07:
> The Xilinx docs are pretty clear that the fabric clock input should not be used.

@sbourdeauducq yes, I think that's essentially what Weida meant (it *can* be used but shouldn't). And, indeed, subsequent tests show that with any activity on the FPGA fabric at all this does not work.

hartytp, 2018-12-07:
Closing in favour of #25

Closed 2018-12-07.

Thread 20 (2018-10-31):

Kasli v1.1 SDRAM init failed :: Read leveling: Small window

jbqubit, 2018-10-31:
Using 3.0.dev+2729.ga9f0d6a3 on a pair of Kasli v1.1. One board consistently passes SDRAM leveling check and the second fails about 4 of 5 boot attempts. Has this been seen before?

Good board....
```
Bootloader CRC passed
Gateware ident 3.0.dev+2729.ga9f0d6a3.dirty;brittonlaba
Initializing SDRAM...
Read leveling scan:
Module 1:
00000000000000000011111111000000
Module 0:
00000000000000000011111111000000
Read leveling: 21+-4 21+-4 done
SDRAM initialized
Memory test passed
```

Bad board... s/n TS 277/18 002
```
MiSoC Bootloader
Copyright (c) 2017-2018 M-Labs Limited

Bootloader CRC passed
Gateware ident 3.0.dev+2729.ga9f0d6a3.dirty;brittonlaba
Initializing SDRAM...
Read leveling scan:
Module 1:
00000000000000000000011111000000
Module 0:
00000000000000000000111111000000
Read leveling: Small window: 1: 21-25 (5)
SDRAM initialization failed
Halting.
```

jbqubit, 2018-10-31:
The ARTIQ commit is 0b43ec4719dd67aa0d839a9e9c69e26783481bdf.

jbqubit, 2018-10-31:
Also see the same error on another Kasli v1.1.

When I roll back to a much earlier version of ARTIQ I don't see any symptoms on the problematic boards.

```
[     0.000010s]  INFO(runtime): ARTIQ runtime starting...
[     0.003945s]  INFO(runtime): software ident 4.0.dev+1298.ge4d48a78;opticlock
[     0.011007s]  INFO(runtime): gateware ident 4.0.dev+1298.ge4d48a78;opticlock
[     0.018101s]  INFO(runtime): log level set to INFO by default
[     0.023799s]  INFO(runtime): UART log level set to INFO by default
[     0.029956s]  INFO(runtime): press 'e' to erase startup and idle kernels...
[     1.030653s]  INFO(runtime): continuing boot
[     1.311238s]  INFO(board_artiq::si5324): waiting for Si5324 lock...
[     5.589166s]  INFO(board_artiq::si5324):   ...locked
[     5.592905s]  INFO(runtime): using MAC address 00-0a-35-03-1e-78
[     5.598875s]  INFO(runtime): using IP address 128.8.195.91
[     5.606311s]  INFO(runtime::mgmt): management interface active
[     5.620600s]  INFO(runtime::session): accepting network sessions
[     5.635685s]  INFO(runtime::session): running startup kernel
[     5.640243s]  INFO(runtime::session): no startup kernel found
[     5.645978s]  INFO(runtime::session): no connection, starting idle kernel
[     6.105487s]  INFO(runtime::kern_hwreq): resetting RTIO
[    35.722324s]  INFO(runtime::mgmt): new connection from 128.8.195.15:41002
```

sbourdeauducq, 2018-11-01:
duplicate of https://github.com/m-labs/artiq/issues/1149

Closed 2018-11-01.

Thread 21 (2018-11-07):

Kasli sudden death during tests

gkasprow, 2018-11-07:
It happed already 3 times that Kasli FPGA died. In all cases the 2V5 rail was shorted to GND. Only FPGA replacement helped. Futher investigation shown the problem - it was short circuit between LVDS line and 3V3 supply on EEM board. Last time it happened on Urukul.
3.3V souced by Urukul from buck converter enters FPGA bank supplied from 2.5V. 0.7V is enough to trigger latchup. FPGA can typically handle 20mA of input current. Higher current triggers parasitic thyristor which then shorts 2.5V rail to GND. And it it is enough to kill the FPGA because current sourced by Kasli SMPS is high enough.
I want to build simple EEM feed-through that would sense LVDS line voltages using fast Schottky diodes and short the excessive voltage to let's say 1.5V. LVDS is centered around 1.25V so won't harm the signals. So Schottky connected to 1.5V would limit the LVDS line voltage to max 2V at 2A. To not kill the diodes thermally, such event will cut 12V rail immediately.
So I will design such module that supports 2 EEM connectors and has 3.3 and 12V MOSFET switch.

hartytp, 2018-11-07:
Nice catch Greg! Is the plan to add this to Kasli for the next revision?

gkasprow, 2018-11-07:
It won't be part of Kasli, but another module used only during tests.
It would harm signal integrity of LVDS signals and make serious impact on Kasli price.

jordens, 2018-11-07:
I'd also like to avoid putting 200 diodes on Kasli. Nice testing and deployment tool though.
How would Banker/Humpback react to 3.3V being fed on the LVDS lines? Do the resistors limit the current to not trigger?

hartytp, 2018-11-07:
> It won't be part of Kasli, but another module used only during tests.
> It would harm signal integrity of LVDS signals and make serious impact on Kasli price.

> I'd also like to avoid putting 200 diodes on Kasli. Nice testing and deployment tool though.

Fair enough. Sounds like a good plan.

gkasprow, 2018-11-07:
@jordens The same applies to ICE40 FPGA and we need such tool to protect it against damage during tests with faulty EEMs.

gkasprow, 2018-11-07:
@marmeladapk please have a look at the protection circuit I designed.
[EEM_Protector.PDF](https://github.com/sinara-hw/Kasli/files/2557602/EEM_Protector.PDF)

jordens, 2018-11-07:
How did the shorts between 3.3V and the lvds lines happen on Urukul? Bad solder on the LVDS converter?

marmeladapk, 2018-11-07:
It seems that there was a short on PCB between lines.

gkasprow, 2018-11-08:
The PCB house did'd do the electrical test properly.

hartytp, 2019-05-07:
@gkasprow closing this issue, as the EEM protector is a separate design and not part of Kasli, so I don't think there is anything to change on the Kasli repo here.

Closed 2019-05-07.

Thread 23 (2018-11-07):

JTAG and J3 MMCX collision

jordens, 2018-11-07:
Right angled MMCX connectors in J3 are hard to route and collide with the JTAG header. Either move the header (can even be DNPed IMO, I am not aware of anybody using it in practice) or J3.
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

Closed 2019-09-19.

Thread 24 (2018-11-08):

Beef up 5V USB to 3.3V LDO (IC16)

jordens, 2018-11-08:
Robustify it against >5.5V USB voltage, surges, and discharging EMI capacitors across power supplies.

gkasprow, 2019-05-11:
The FTDI 1V8 core supply is typ. 70mA. It is derived from 3V3. USB PHY (3V3) consumes max 60mA.
So we have 130mA just for the chip, without the load, output buffers, and translators.
130mA*(5V-3.3V) gives 0.2W of losses. So we don't need the switching converter here and single SOT-23 LDO would do the job nicely.
MIC5219-3.3YM5 works up to 12V, has 500mA of max current and costs pennies.
Its Thja is 220°C/W so even with 200mA of power will work. I saw SOT-23 LDOs on many boards with this chip.
BYP capacitor is not needed. Remove 10uF load cap because it has too low ESR. Leave only 100nF and 22uF output caps.

marmeladapk, 2019-05-22:
I copied the design from Sayma AMC.

Closed 2019-05-22.

Thread 25 (2018-11-24):

Kasli 1.2 WR support

gkasprow, 2018-11-24:
We have just a few free BGA balls which are not sufficient to support WR-like clocking.
we have some spare pins:
2.5V bank: W19 (clock input), F21, T3, Y17
1.5V bank: E3
But we don't need all SFP control lines like rate select, LOS, FAULT.
We don't use them and can re-route to I2C extender. In this way we get
another 10 pins or so. @jordens any objection?
In all my new designs I route all SFP control lines to dedicated per
SFP I2C extender so they don't consume valuable FPGA lines. They don't
cosume I2C switch ports either because SFPs are already connected to
I2C.
In this way we would remove bunch of level translators and replace them
by 3 8bit I2C extenders which enable SFPs be default.

jordens, 2018-11-24:
We are using the SFP lines. But I am OK with moving them somewhere else. I don't know whether I2C or SPI would be better here. And I am unclear how the software/gateware support will be implemented and who will do that. Also there are a few things that should be wired to the FPGA, like the I2C switch reset.

marmeladapk, 2018-11-24:
@jordens https://github.com/sinara-hw/sinara/issues/349#issuecomment-360517401

jordens, 2018-11-24:
Sure. But since we are now doing a big revision that will lead to a bunch of incompatibility and we just freed up a lot of pins, it's fair to revisit that perspective and enable resetting the I2C switches from the FPGA. Right now we don't make much use of the I2C bus. That is likely to change. If e.g. the FTDI interface leaves the I2C bus stuck and forgets to reset it, the FPGA can't even boot.
As a sidenote on the I2C front I have had problems with talking to SFP modules. It seems a bit fragile but it could also be a problem with the modules. One thing that I would consider is increasing the pullup resistances on the downstream switch ports to e.g. 10k-20k. Otherwise the pullup impedance is 1k in use or even lower when the tree is deeper than one switch level. That might be a bit low. AFAICT there is no situation where a bus segment would have a too high impedance or the entire bus would have too high impedance when in use.

gkasprow, 2018-11-24:
@jordens which ones are you using? Lines like Rate Select of TX Fault are not supported by most SFPs
We need just a few of them.

jordens, 2018-11-24:
LOS is supported and we use it to drive the LED.
We are using the cheap ones from FiberStore in different incarnations but also a bunch of genuine Aruba/HP ones (SFP-SX).

hartytp, 2018-12-07:
cf https://github.com/sinara-hw/meta/issues/15

hartytp, 2019-05-07:
Continuing from https://github.com/sinara-hw/Kasli/issues/5#issuecomment-490073738

> (@marmeladapk) Do we want to implement WR CDR as in Sayma and Metlino?

Side note: should we stop calling this WR, since we're not implementing most of the WR stack (PTP etc)? Shall we just call it CDR PLL or something generic? Or call it WR PLL to indicate the history?

I definitely want a DCXO PLL on Kasli v2.0 (making sure we have resources for this was the main reason we funded Kasli 2.0). Let's copy Sayma, but leave the DFF off.

> (@jordens ) WR CDR once the first iteration has flown successfully beyond bread boards and the Si5324 should be scrapped then.

I'd strongly prefer to keep the Si5324 on for v2.0, with the aim of removing it in v2.1 Ideally, I'd like a mux to select between Si5324 and DCXO PLL, but solder jumpers are fine too.

1. I don't want to rely on Sayma for the DCXO PLL development (issues with limited hardware availability for testing, likely to be delays in getting working boards ready for testing, complex design to test, potential issues with Ultrascale FPGAs etc). Ideally, we would have demonstrated the DCXO PLL on Kalsi before freezing the Sayma design, but that wasn't possible. I don't want to put off Kasli v2.0 until we've been able to demo the DCXO PLL working reliably on Sayma v2.0
2. I don't want to remove the Si5324 until we've done a few months of field testing with the DCXO PLL. I don't expect any major issues, but best to be safe.

I think it's fine to support both paths in v2.0, with the aim of moving on to v2.1, which will only have one option, fairly quickly.

marmeladapk, 2019-05-08:
Assuming that we add two Si549:
- We would need to switch from ADCLK944 to 948 to switch from main DCXO to Si5324 (IHO that a good thing, Kasli is the only board using 944)
- We have a free MRCC input on the FPGA for helper DCXO
- We would need to add two I2C buses straight to the FPGA - we have free pins for that
- I would put output enables on I2C extenders, these aren't critical signals (just for the sake of easier routing)
- We would need a beefier LDO to power Si5324 and Si549. Both Si549 and 570 support 2,5V supply (though Si570 has a different part number for 2,5V version)
- Considering board area - it might be a bit tricky to put those chips in the same area as Si5324 so I think I'll place them on the right side of MMCX connectors

hartytp, 2019-05-08:
> Is there really no way we can reassure everyone sufficiently to decide on one CDR solution instead of dragging multiple mutually exclusive approaches for the same problem around?

Let's see. On the hardware side, the DCXO/WR PLL has been quite well tested using evaluation boards and a KC705: we've checked it locks reliably (well, say 10 out of 10 times); we've used a scope on persist to verify that no cycles are slipped over days; we've measured phase noise; we've measured long term phase stability with an interferometer (mixer). It all seems good. Moreover, we've done tests both with unloaded and with heavily loaded FPGAs.

However, the cautious side of me would still like to spend a few weeks testing this on a live Artiq experiment before we commit to it as our only CDR scheme. For the reasons spelled out above, I don't think Sayma will be a good test bed for that and would much prefer to use Kasli. We could put only the DCXO/WR PLL on Kasli v2.0 and test like that, however if we do find an issue with the design those boards will be effectively useless.

On the software side: while we have working POC code, it's not close to being ready to merge into ARTIQ (although @WeiDaZhang is working on it). So, we either need to put both the SI5324 and DCXO on Kasli v2.0 or accept that we won't be able to use Kasli 2.0 until the code is ready for ARTIQ integration. I'd prefer to press on with both solutions and switch to the DCXO when the code is tested and working.

If @marmeladapk feels that keeping both the SI5324 and DCXOs will cause SI/PI/layout issues then that would change things. But, if it's not a problem to have both then that's what I'd like to do for the next version. We can finally drop one in v2.1.

marmeladapk, 2019-05-09:
@hartytp By default CMOS DCXOs are mounted. Do we plan to use LVPECL variant at all? I couldn't find stocked LVPECL variant anywhere. LVPECL and LVDS variants are shown to have nearly the same phase noise. If we'll use only CMOS and LVDS then I could simplify schematic for helper DCXO and route both output signals directly to the FPGA and (in CMOS case) terminate _P line to ground.

I also need to add buck from 12V to 5V and then LDO from 5V to 3,3V, as ADCLK948 can only be used with 3,3V.

There will be plenty of space for this since I remove one SFP cage.

jordens, 2019-05-09:
* The ADCLK948 is pretty hungry (288 mA at 3.3 V versus 139 mA at 2.5 V, both static).
* If the external SMA then only goes to the FPGA and to the SI5324, do we need another fanout? If we go for capacitors then we can do that just as well at the input to the downstream fanout and don't need the ADCLK948.
* Does the WR PLL also work well with 100 MHz or 10 MHz external reference? Since 100 MHz is the dominant use case so far it should definitely be verified.

marmeladapk, 2019-05-09:
@jordens I wanted to change ADCLK944 to 948 to have clock input selection, so it's not _another_ fanout. External SMA only goes to Si5324.

jordens, 2019-05-09:
Sure, I understand that. Is that worth the increased power consumption?
Not a path from the sma to the fpga if the dcxo is used means the external sma becomes dependent on the si5324 blocking it's removal.

hartytp, 2019-05-09:
> External SMA only goes to Si5324

> Not a path from the sma to the fpga if the dcxo is used means the external sma becomes dependent on the si5324 blocking it's removal.

For the WR master, we need an external coax (MMCX/SMA) connection to the FPGA.

Can we get away with only routing the clock to the FPGA and then use the FPGA as a mux to route it to the Si5324 if necessary?

hartytp, 2019-05-09:
> Does the WR PLL also work well with 100 MHz or 10 MHz external reference? Since 100 MHz is the dominant use case so far it should definitely be verified.

We've verified 100MHz and 125MHz so far. I'm not aware of any limitation that would make 10MHz worse (assuming clean edges), however it needs different parameters and we don't currently have a nice design tool to determine them (it's on the to do list).

hartytp, 2019-05-09:
> @hartytp By default CMOS DCXOs are mounted. Do we plan to use LVPECL variant at all? I couldn't find stocked LVPECL variant anywhere. LVPECL and LVDS variants are shown to have nearly the same phase noise. If we'll use only CMOS and LVDS then I could simplify schematic for helper DCXO and route both output signals directly to the FPGA and (in CMOS case) terminate _P line to ground.

I'm not aware of any reason to use LVPECL since the LVDS specs are fine. We used LVDS in our tests. LVCMOS isn't specified as well an we haven't tested it yet. But, if I had to guess, I'd say it's probably fine too (generally, there is another PLL after the WR DCXO like the HMC830 to clean up the broad-band noise).

hartytp, 2019-05-16:
> Does the WR PLL also work well with 100 MHz or 10 MHz external reference? Since 100 MHz is the dominant use case so far it should definitely be verified.

@jordens most of the tests @WeiDaZhang has done so far were with a 100MHz reference and 125MHz DCXO frequency. He used an FPGA PLL (MMCM?) to convert the 100MHz to 125MHz before feeding it to the DDMTD DFF. Interestingly, he did not observe any degradation in the noise spectrum or long-term stability due to the FPGA PLL (even under heavy load). So, this seems to work fine.

I guess the close-in noise for those PLLs is fine, and the WR PLL takes out all the high-frequency noise with an aggressive loop filter. In any case, it seems that this will be fine for the vast majority of use-cases.

To get an RTIO frequency significantly different to 125MHz one has to re-optimize the loop-filter and potentially change some register values in the DCXO. I'd guess that the range 100MHz to 150MHz can be supported decently without retuning the loop, but @WeiDaZhang would need to confirm this.

marmeladapk, 2019-06-12:
I pushed updated schematics, see if this is what you had in mind.
(Si549 OE needs translation)

hartytp, 2019-06-12:
@WeiDaZhang

hartytp, 2019-06-14:
> I pushed updated schematics, see if this is what you had in mind.

Can you post a pdf please?

marmeladapk, 2019-06-14:
[KASLI.PDF](https://github.com/sinara-hw/Kasli/files/3290442/KASLI.PDF)

hartytp, 2019-06-14:
Thanks! That looks good to me.

hartytp, 2019-06-18:
@marmeladapk are we sure it's okay to pull the NC pins high?

hartytp, 2019-06-27:
Wide have both reviewed the WR/clocking and are happy (modulo my above question). Assuming @sbourdeauducq / @jordens can't see any issues, I think we're good to go.

@marmeladapk what's the timeline for finishing Kasli 2.0? I'm keen to get the next batch of boards off asap as we're out of hardware in the lab.

hartytp, 2019-07-07:
@WeiDaZhang has produced an FMC with DCXOs etc on it for prototyping the WR interface on a KC705. Can you post the schematic here, please?

The test board has DFFs on it, so we can look at the loop performance both with the DDMTD DFFs inside the FPGA and with them externally. The broadband noise is about 6dB lower for the PLL external DFFs than for the FPGA DFFs. That suggests that we can have a somewhat broader-bandwidth/lower-noise lock with the external DFFs, which is nice, but not a game changer. IMHO that's not sufficient grounds to use the DFFs on Kasli yet since I'd prefer to optimize for simplicity over squeezing out the last few dB of phase noise at this stage.

Still to do: measure close-in phase noise, temp-co and long-term stability with both approaches.

hartytp, 2019-07-07:
One interesting thing that did come up is that the Si549 close-in phase noise seems to degrade with increasing DCXO temperature. This figure shows the open-loop phase noise of the DCXOs on Weida's test boards. Red is with a large heat-sink on the DCXO, orange is with a small heat-sink and yellow is no heat sink.

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

The difference is all basically in the 0.1Hz to 10Hz region. That's a bit close to the typical loop bandwidth we want to run at. It can be dealt with to a certain extent by using an aggressive (probably >3rd order) loop filter. But was unexpected and needs thought.

I don't think the DCXO thermal grounding was particularly good on Weida's board. Next week, he'll put the test setup in an oven and measure the open-loop phase noise for a couple of different DCXO case temperatures. (@WeiDaZhang NB we should ask SiLabs if this is expected behaviour on the forums once we have that data).

marmeladapk, 2019-09-03:
@hartytp Close this issue if there's nothing else to do here.

hartytp, 2019-09-03:
@weida I think we now agree that there is no point having an ext dff since the transceiver PLLs dominate. In which case, this design is optimal, right?

marmeladapk, 2019-09-18:
Uh oh. Well, we can't have everything. This excludes the whole board ;) I'd also like to keep main dcxo near clock fanout so that the clock doesn't pick up noise from travelling across the board. Perhaps above I2C fanouts and beneath JTAG connector? This seems like the most quiet place + away from everything @jordens mentioned (esp SFP cage may be dumping a lot of heat). But Si549 won't be shielded from airflow then.

Closed 2019-09-03.

Thread 26 (2018-12-18):

ground clock in (SMA) and out (MMCX) [v1.1 BOM change]

jordens, 2018-12-18:
I have a couple times now that that floating shield thing is a bad idea, also on crate-internal MMCX wiring. The symptom is 400/800 kHz switcher modulation sidebands on the urukul clock. Shorting the shield on both ends resolved it each time.
This can a pure BOM change and I'd like to have it implemented on all future Kasli v1.1 builds and Kasli v2.0 as well.

c.f. #5 and maybe #10

hartytp, 2018-12-18:
Agreed. Floating grounds can be the right thing to do in rare cases, but it's not a sensible default option.

hartytp, 2018-12-18:
(I thought we agreed to do this ages ago)

jordens, 2018-12-18:
We agreed. I'm just pushing to rush this into the current boards without waiting for v1.2/v2.0.

marmeladapk, 2019-01-08:
a87c75c

jordens, 2019-01-08:
Thanks. The v1.1.1 version you assigned is a very good idea.

Thread 27 (2019-02-25):

SDRAM module "zero window" breakage

sbourdeauducq, 2019-02-25:
This happened after shipping on a Kasli (mounted in a subrack) that was working before, without touching the firmware:
```
Initializing SDRAM...
Read leveling scan:
Module 1:
00000000000000000000000000000000
Module 0:
00000000000111111111111000000000
Read leveling: Zero window: 1: 0-0 (0)
SDRAM initialization failed
```
Has anyone seen this issue before?

marmeladapk, 2019-02-25:
We may have seen something similar when the FPGA wasn't soldered correctly.

sbourdeauducq, 2019-02-27:
Why did that affect the SDRAM in particular? Which solders were broken?

marmeladapk, 2019-02-27:
Part of the FPGA was lifted and some FPGA pins (particularly lower left quadrant) didn't make proper contact. It was easy to see visually, FPGA wasn't aligned horizontally with the board. We didn't check pin by pin as it was obvious that the FPGA had to be resoldered.

sbourdeauducq, 2019-03-01:
That failing Kasli also developed breakage on EEMs 9 and 10.

jordens, 2019-03-01:
I have one where SFP0 is not receiving and where this SDRAM zero window happens sporadically. It's also a speed grade 3.

hartytp, 2019-05-07:
@gkasprow what do we do about this?

gkasprow, 2019-05-07:
This happened on a PCB series where FPGA was soldered later on manually.
There is nothing to do with PCB design. The tests were probably not sufficient or were not conducted at all.

Closed 2019-05-07.

Thread 28 (2019-04-03):

backplane adapter fastening

sbourdeauducq, 2019-04-03:
Before Kasli 2.0, can we find a short-term solution to solidly attach backplane adapters to Kasli?
The friction from the connector + 220mm card guides is not enough. I had a crate where the adapter detached completely during shipping.

gkasprow, 2019-04-11:
@sbourdeauducq you can use the edge connector mounting holes and thin plastic zip ties to fasten the backplane to the Kasli.

Closed 2019-05-07.

Thread 29 (2019-05-07):

rotate SATA connector

hartytp, 2019-05-07:

marmeladapk, 2019-05-08:
This also requires rotating JTAG connector -- I'll switch it to surface mounted (same as in Sayma), otherwise it will block current in power planes on all layers.

jordens, 2019-05-08:
What about ditching the JTAG connector? Is it important to keep it? Is it needed and used?

marmeladapk, 2019-05-08:
Yes, for example during tests. Also you cannot use USB JTAG with Vivado (MIG and IBERT) (we'll try something with FTDI in the near future but we're not certain that it will work).

jordens, 2019-05-08:
Ok.
But really? That would imply that you can't use the digilent castellated modules (which are just FTDI) on the standard dev kits (KC705...) with IBERT or MIG.

marmeladapk, 2019-05-08:
Yes you can, however they have special ROM contents and are seen differently by Vivado. And these FTDIs on digilent modules are FT2232 not 4232.

marmeladapk, 2019-08-28:
SATA connector will be rotated and placed above SFP cage.

Closed 2019-09-19.

Thread 31 (2019-05-07):

Switch all components to our standard library

hartytp, 2019-05-07:

hartytp, 2019-10-01:
Is this done? Can we close?

gkasprow, 2019-10-01:
not yet

marmeladapk, 2019-11-28:
Only components that are not in CERN libs are:
- 43k2 1% resistor
- fansink
- Si549 (no LVDS version)

gkasprow, 2019-11-29:
Did you check recent CERN libs?

marmeladapk, 2019-11-29:
I checked those from 31st of October.

marmeladapk, 2019-12-15:
CERNlib from 3rd of December 2019 - 43k2 1% resistors and fansink are still missing.

Thread 32 (2019-05-07):

Switch U1 to nonBGA version

hartytp, 2019-05-07:

marmeladapk, 2019-08-16:
Removed it, DS181 states that absolute maximum current on V_MGTAVTT is 12 mA. If it's per pin we're still good with 200 mA LDO.

Closed 2019-08-16.

Thread 33 (2019-05-08):

move clock SMA

hartytp, 2019-05-08:
> Move the clock input SMA further towards the panel. Leave just enough gap for the insulating washer. Otherwise (with a gap, the two insulating washers, the panel, and the nut, even without the springy/claw washer) there is not enough thread to fully tighten an SMA connector.

I see a similar issue on Urukul as well, where I am not able to fully tighten the SMAs on some cards unless I fiddle with the stackup.

Now that we're not floating grounds by default, should we just DNP these washers?

jordens, 2019-08-22:
I don't think the plastic washers are the cause of the problem. And if the washers are gone, probably the hole would have to be smaller to properly counter the spring washer and nut. The smaller hole would then always prevent using the plastic washers and AC-coupling the shield. If there are no plastic washers, then the foil on the panel or anodizing will be likely be damaged by the standard metal spring/teeth washers. This would need to be considered. Also if we decide against the use of plastic washers, then we should go all the way and fully ground the shield without the use of 0R jumpers.
If this can be solved with getting the positioning and stackup right, then why not do that?

gkasprow, 2019-08-22:
I managed to:
- move the SMA 0.75mm to the panel
- move the board edge to the panel, leave 0.5mm clearance
- increase the SMA hole diameter by 0.5mm
It should solve the issue.

Closed 2019-09-19.

Thread 34 (2019-05-08):

Si5369 instead of Si5324+ADCLK944

hartytp, 2019-05-08:
>  Si5369 instead of Si5324+ADCLK944 (power, board space, components, cost). Or even Si5346

For the next version, I think we won't do this, since we'll have the DCXO PLL + ADCLK948. However, if for any reason we scrap the DCXO PLL in a future revision then we can reconsider this...

Closed 2019-05-08.

Thread 35 (2019-05-08):

add note about grounding

hartytp, 2019-05-08:
Add note on schematic by the connectors saying something like "To float connector grounds, replace 0R with 100k. NB Kasli must be connected to mains ground for to avoid damage to it or other equipment connected to it!"

dhslichter, 2019-05-08:
How about "Kasli power input must be connected to a reference ground to prevent switching power supplies from floating to hazardous voltages." or something like that.

jordens, 2019-05-08:
Please leave out that scare comment about the ground connection. As pointed out elsewhere it's inaccurate, confusing, and inconsistent. It doesn't need to be connected to "mains ground". Your instrument/measurement ground/trap ground will work. It will also work fine if not connected to mains ground.
For that comment to make sense it would need to be clear why it needs to be connected to mains ground, what exactly needs to be connected and why/how not connecting it to mains ground will damage it or other equipment.
It also contradicts itself by implying that the option explicitly described in the sentence before must not be used.

Thread 37 (2019-05-08):

hot plug warning

hartytp, 2019-05-08:
Write "DO NOT HOTPLUG" next to the EEM connectors schematic/pcb

jordens, 2019-05-08:
I think it does in fact hurt because it gives a false sense of safety and an excuse. It's incomplete.
But if you insist. Please don't overdo it in the font size, all-caps and number of exclamation marks. If the text doesn't get the message across all-caps won't help. Keep it at the same size as the "EEM0" markings.
From my observation handling devices wearing wool/plastic sweaters, rubber shoes, dragging plastic chairs without ESD protection is significantly more common. And since the damage caused by ESD is typically not immediately visible and associated with improper handling it is costlier in the long run and much harder to learn.

dhslichter, 2019-05-08:
I think it doesn't hurt to add it on the schematic and PCB.  However I agree with @jordens that what is really needed is a manual detailing these sorts of things.  I will say that the schematic may be brutally clear to those who know how to read it (or who even bother to), but the most likely case is a new grad student who doesn't fully understand the electronics or ramifications and probably didn't even look at the schematic.  A manual with a few key bullet points on the front page would go a long way towards addressing this (large, never-going-to-go-away) group of users.

gkasprow, 2019-05-08:
True, It was the first thing one of my student did with Kasli :D

gkasprow, 2019-05-08:
That's funny. I commented 3 mins ago and that comment was placed before your comments which were placed 5h ago...

dhslichter, 2019-05-08:
@gkasprow Somebody's clock is off, we are getting comments from the future!

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

jbqubit, 2019-05-09:
Within the Sinara platform several interfaces are hot pluggable including Ethernet, SFP, uTCA  AMC, uTCA RTM, USB. So it's not unreasonable for users to assume that EEM is too.

Agreed that important precautions should be written down. Users ought not have to refer to the PCB schematics to be advised on best practices.

An interim solution is the [wiki](https://github.com/sinara-hw/Kasli/wiki) which I've just updated.

jordens, 2019-05-10:
Flawed reasoning.

There is no reason to extrapolate from the connectors you mention. Why would there be? The EEM connector is actually an internal connector that is not (easily) accessible when in a crate. It is significantly different.

If you survive poking those connectors with a screw driver naively extrapolating to a wall outlet can be deadly. If you have crossed a road 100 times without being hit by a car that doesn't mean there are no cars on roads. If you have survived being stung/bitten by a mosquito, a bee, a wasp, and a rose that doesn't allow extrapolation to other animals or plants. Extrapolation is unsound without detailed reasoning and always risky.

dhslichter, 2019-05-10:
@jordens I think the point is that many first-time users will be idiots with flawed reasoning :)

jordens, 2019-05-21:
If many first time users are idiots with flawed reasoning and if this is really considered a likely behavior that needs to be addressed this way, then I don't understand why nobody wanted to put similar warnings on the mezzanine connectors on Sayma AMC, RTM and Metlino (and probably the VHDCI connectors as well since shield connection is not reliable during mating), on the TEC connector on Zotino, or on the connectors on Stabilizer and Humpback.
Now you have a system that warns in one place but omits warnings in others. That's IMO worse than before as it stimulates the risky and flawed reasoning it's supposed to prevent.

dhslichter, 2019-05-21:
The solution to this is to put warnings in all necessary places, not to put them nowhere in the name of consistency.  I agree that it would be good to be consistent with all of this if we can.

jordens, 2019-05-22:
This is getting a bit petty, but I am worried by three things which apply to other areas as well.

* Under the assumption that people act the way you describe it is plausible that when faced with an inconsistent situation where connector A has a prominent warning about hot plugging (which they don't understand but maybe accept anyway) and another connector B doesn't (e.g. right at the other end of the EEM ribbon cable), the user can in good faith assume the warning does not apply to connector B. That's certainly worse than no warning at all and hoping the user acts cautiously or asks.
* There is no activity at all to apply this warning to any of the other places where it would need to be applied. That suggests that this warning here is just a superficial reaction to some incident which may be coincident but likely doesn't have a root cause that's related to the hardware design at all. Then it shouldn't be addressed in the hardware.
* Claiming to aim for eventual consistency but then only some attempt at a partial interim solution is applied and people don't bother cleaning up after themselves.

hartytp, 2019-05-22:
@jordens I don't feel strongly about this issue, but a couple of comments:
- We have had a Kasli killed by a student (who I would definitely not describe as an idiot) hot plugging EEM connectors.
- Swapping EEM connectors is likely to be much more common than things like Sayma AFEs, so it warrants a warning there
- We currently do have a warning about hot-swapping directions for the DIO boards (as a response to that breaking boards)
- a consistent policy here is that we can't warn against everything silly people can do, but picking on the ones that are most common and most destructive in the typical lab usage scenarios we've encountered so far doesn't seem daft

jordens, 2019-05-22:
@hartytp
Please note that the idiot label does not come from me. It's not my view and contradicts my assumptions. I would like to assume the opposite and would rather give the users the info they need to understand the problem than add confusion with incomplete and inconsistent warnings.
Why does it matter whether connector mating is a common operation? If the risk is the same then the same rules apply. The argument that "it doesn't hurt" is a pretty low bar and doesn't carry much weight.
The DIO issue seems fundamentally different. It's handled consistently and arose from a design flaw that was not meant to be there. Both don't don't apply here.
We don't know whether it is even worth the board space. In practice (and at least for myself) it would not have made a difference at all. I have hot-plugged them as well. Observing myself and going into the details of the thought process when handling: Hotplugging occurs here when you are convinced you know what you are doing because you have done it several times before but you forget to check whether the prerequisites are met (the power supply is off). In that situation you would have never processed the warning on Kasli since you have already seen it several times. You already know about the risks and you are fully aware that electronics is sensitive. After it happens you immediately know what went wrong. Trying to get into that thought process at that instant and break it with a warning on the board is utterly pointless from a ergonomics perspective. Was the student you are referring able to correctly power down the boards before? Then maybe the cause was a similar lapse and not "lack of warnings"?
With "most common" you are referring to once (plus the one time it happened in Greg's lab AFAIK). We've hade ESD damage more than twice before and don't bother putting a ESD warning pictogram on the PCBs.
This warning is a non sequitur and disproportionate to me.

dtcallcock, 2019-05-22:
Perhaps we can ship every board with a pack of stickers so people can customise according to taste/philosophy.  As well as boring safety warnings, some of them could have bad puns or cool graphics on them.

Talking of which, we only have stickers with the old 'ice skaters' ARTIQ logo on.  Can we get a sticker upgrade @sbourdeauducq ?

dhslichter, 2019-05-23:
My use of the phrase "idiots with flawed reasoning" was followed by a smiley face in an attempt to indicate a certain level of satirical excess -- I don't think Kasli users are actual idiots, but was trying to point out that most will not have thought deeply about these sorts of issues prior to trying to get a system up and running for the first time.

I think that a blanket statement of "Never hot plug peripherals to Sinara boards", placed next to each such connector on all boards (stickers are fine if we already have fabbed boards, and can be applied or not depending on the taste of the user), would be nice.  Of course one is always going to have the failure mode of forgetting to turn off the power supply before connecting, and we can't protect against that.  But we can use writing on the boards themselves (whenever possible) just to provide a constant reminder for this failure mode, which seems to occur relatively often, and is an expensive error to make.  It won't prevent all issues but might help prevent some.

@dtcallcock the ARTIQ logo is open source, make your own stickers ;)

jbqubit, 2019-05-24:
Physical students in particular don't typically have an electronics background. They're not typically thinking critically about what's on PCBs when putting a system together for the first time. If we were designing a system with high-cost or consequences of failure (eg airplane, medical device) this level of analysis about consequences of imperfect warning-sign coverage might be appropriate. However, Sinara is a system for pragmatic people who are trying to string together complex lab setups often in teaching environments. I like @hartytp 's perspective here.

> a consistent policy here is that we can't warn against everything silly people can do, but picking on the ones that are most common and most destructive in the typical lab usage scenarios we've encountered so far doesn't seem daft

"People Aren’t Dumb. The World Is Hard." -Richard Thaler

http://freakonomics.com/podcast/richard-thaler/
https://science.sciencemag.org/content/339/6124/1152

gkasprow, 2019-05-25:
What about making the next revision of EEMs hot-plug survivable?
This needs adding the MOSFET power switch on the 12V rail on either Kasli or each EEM extension.
The main power would be applied after a few hundreds of ms after the EEM connector is plugged.
We can use one of the GND lines as a sensing circuit. With AC decoupling this would not break the SI of LVDS line. From the cost perspective, we need to add 12 MOSFETS, 0.2$/pc + some discrete RC components.

gkasprow, 2019-05-25:
Yet another idea is to link such hot-insertion with power-cycling of the FPGA.

dtcallcock, 2019-05-25:
I think this is a great idea if it's that simple.  Would 100ms delay work though?  I don't have a connector to hand but I feel like if you get it wrong and go in at a slight angle you might be able to make about half the connections and then get stuck.

gkasprow, 2019-05-25:
We can detect if the EEM is fully inserted and then deliver the power.

hartytp, 2019-05-26:
I’m wary of trying to make eems hot-pluggable. The worst-case scenario is that we bill them as hot-playable but there are still corner-cases where hot plugging breaks boards. E.g someone is hot plugging a unit in a rack where the cable is at an awkward angle and they offset the connector by a few pins. Now the 3V3 shorts to ground and the unit starts and breaks. What about eems with two connectors, so that when the second is plugged in it’s 12V is already live? What about hot plugging when there is still charge left on capacitors (again if the cable is accidentally offset by a few pins).

Hot plugging isn’t that useful and hard to make really robust, it just encourages bad practice. Much better to just document that eems/afes/etc should never be hot plugged.

gkasprow, 2019-05-26:
@hartytp this is a protection mechanism only. They won't be hot-pluggable. We won't even write a word about such a feature. This is only to add some robustness, especially if we go for the backplane.
With 2-EEM boards, when one is already inserted, the thread is minimal since GND and power rails are already there. The main risk is when somebody plugs 12V first, then LVDS and then GND. This breaks the FPGA.

hartytp, 2019-05-26:
@gkasprow if the connector is partially inserted but displaced by a few pins then I believe it’s possible to break the fpga as well (iirc one can end up connecting lvds to 12V or something like that).

Personally I wouldn’t bother adding complexity for a feature that will still leave many damage mechanisms open.

dhslichter, 2019-05-29:
Aren't the EEM connectors shrouded to help prevent pin misalignments?  I don't like the idea of trying to make EEMs truly hot-pluggable, but putting in some protection for common failure modes (like this MOSFET idea) seems like a reasonable thing to do as long as it doesn't degrade performance or cost a lot.

gkasprow, 2019-05-29:
they are shrouded but can be partially inserted causing missing contacts for some pins.

hartytp, 2019-10-01:
I'm not fussed about this and it seems controversial so closing.

marmeladapk, 2019-10-02:
It's already in schematics and I'll place text under EEM connectors.

Closed 2019-10-01.

Thread 38 (2019-05-08):

move some signals to I2C extenders

hartytp, 2019-05-08:
@marmeladapk
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

@jordens
> Ok moving the signals to an extender apart from the three SFP LEDs please. The other user_leds can go away.

marmeladapk, 2019-06-12:
Additional signals:
- Clock source select for AD948
- Main, Helper DCXO OE

There are 7 free pins. @jordens requested some additional FP leds, how many do you want?

jordens, 2019-06-12:
I'd like at least one FP LED on a non-I2C pin directly on the FPGA. That LED doesn't need to be associated with a connector. This is really useful for debugging and status signalling on Kasli.
The other LEDs don't matter. One I2C LED per SFP port is fine IMO. Maybe another one associated to the SMA connector.

marmeladapk, 2019-06-12:
@jordens You have 3 SFP LEDs on FP, is that enough or do you want additional one?

jordens, 2019-06-12:
If they go directly to fpga pins then that's fine. if they go through i2c extenders, I'd like another fp led that goes directly to the fpga.

marmeladapk, 2019-06-12:
You asked for SFP LEDs to go directly to the FPGA.

jordens, 2019-06-12:
Good. Then I see no urgent need for more LEDs.

Are the 7 extra pins on the FPGA or on the I2C extender?

marmeladapk, 2019-06-12:
11 on FPGA, 7 on extender, however I would avoid adding more signals to the FPGA just for the sake of it.

marmeladapk, 2019-06-12:
@jordens from https://github.com/sinara-hw/Kasli/issues/39
> And with the I2C extenders we could add a few (maybe two) more edge LEDs to indicate not SFP-related status but system status like e.g. clock lock, idle kernel running, something else running.

Is this still valid then?

jordens, 2019-06-12:
Sorting my thoughts: If the extender pins are free and if there is space to place FP LEDs so that it is clear that they are not related to the SFPs, I think we should clean this situation up a bit and put the LEDs that are associated with the SFPs onto the extender as well and add (two) general purpose indicator LEDs on the FPGA pins to the panel.

marmeladapk, 2019-08-27:
@jordens after adding SFP3 I have one free pin on GPIO expander. What about moving 2 of 3 user leds to FP and adding another one?

jordens, 2019-08-27:
Good

Closed 2019-08-28.

Thread 41 (2019-05-08):

[RFC] 2x2 SFP

jordens, 2019-05-08:
What about the following:

* Stacked SFP cages/connectors. Either 2x1 or [2x2](https://www.digikey.de/product-detail/de/pulse-electronics-network/SFPP-3130-L/553-3386-ND/4169641). That would simplify routing, space, front panel openings, LEDs. It would also get rid of the two different SFP cages.
* Ditching the SATA connector and going for 4 SFP. (Or make SATA a capacitor jumper option if sombody insists). So far the use for SATA has been to drive Sayma AFAIK. But that would be doable via SFP as well. Also having multiple Kaslis in a crate could be done cheaply with DAC SFP cables.

sbourdeauducq, 2019-05-08:
>     * So far the use for SATA has been to drive Sayma AFAIK.

No, it's also been useful for having two Kasli inside the same crate, after all EEM slots of one Kasli are exhausted.

jordens, 2019-05-08:
I prefer an external cable.

marmeladapk, 2019-05-08:
I'm for using at least one 2x1 - this will allow to better space power supply, USB and SMA connectors. And it would give more space for DCXOs.

jordens, 2019-05-08:
But then -- and even if we keep the SATA connector -- it might make sense to go 2x2 and jumper the GT lines. Two BOM lines (connector and cage) and space between the cages saved.

hartytp, 2019-05-08:
My preference would definitely be to go for 4 SPFs on the FP and scrap the SATA to make routing easier. A 2x2 SFP cage sounds like a great idea. IIRC the only reason we didn't do that on v1.0 was that we were trying to fit Kasli into a 4HP form factor. Now it's 8HP I don't see a good reason not to do this.

The internal cable between two Kasli seems a bit niche to me.

hartytp, 2019-05-08:
FWIW on Kasli Zync I suspect we may end up needing to use stacked connectors in any case as I think we'll want a SFP routed to the PS MAC for ethernet (as an added bonus, this gives us ethernet on DRTIO slaves, which could be useful). So, we'd probably want 1SFP for ethernet, then 4 SFP to the PL.

dnadlinger, 2019-05-08:
> The internal cable between two Kasli seems a bit niche to me.

Yep, that – I haven't looked at the signal standard, etc. side of things, but from purely a user's perspective, having only one type of connector/cable/… to worry about is definitely an improvement in modularity.

If just having 4 equivalent (up to gateware) SFPs is an option, that would particularly interesting as adding Ethernet to satellites is still on the back of my mind for throughput reasons, and we could still have a 1:2(+1 local) DRTIO switch this way.

sbourdeauducq, 2019-05-09:
> this gives us ethernet on DRTIO slaves, which could be useful

Why is it useful?
We could already tunnel Ethernet packets on the DRTIO aux channel, which needs no additional wiring.

sbourdeauducq, 2019-05-09:
> from purely a user's perspective, having only one type of connector/cable/… to worry about is definitely an improvement in modularity.

What I like about the internal cable is that we can ship a more seamless solution where the Kaslis are already connected; otherwise the user has to add the SFP cable themselves (which also takes space on the front of the crate).

marmeladapk, 2019-05-09:
What solution would make most sense if we plan to eventually move to cPCI?

gkasprow, 2019-05-09:
Standard CPCIS defines controller as 4HP. So we would need another PCB design anyway.
CERN backplane will have 6HP spacing.

jordens, 2019-05-10:
AFAICT cPCI will invalidate the MMCX connectors and the SATA connector because the backplane is in the way for any internal cabling. Right?

gkasprow, 2019-05-10:
CPCIS backplane has dedicated clock distribution on the backplane.
About the SATA, it depends on what you would like to use it.
We can connect it to one dedicated CPCIS slot.

jordens, 2019-05-10:
Sure. That can all be done on cPCI(S). I was just referring the mechanics of internal cabling being mutually exclusive with cPCI(S), at least for standard or "CERN" backplanes.

marmeladapk, 2019-05-22:
Okay, was there any resolution to this discussion?

gkasprow, 2019-05-22:
Can we leave it as it is?
Stacked SFPs are not that common and I already experienced availability issues.

hartytp, 2019-05-22:
> Stacked SFPs are not that common and I already experienced availability issues.

Yes, I hadn't realised that they are less common. However, there are enough parts that seem widely stocked that I wouldn't have thought it was too much of a concern. e.g.

https://octopart.com/2007492-5-te+connectivity-42631824?r=ap&s=i32uZXbMQPe8xcJPmDmv3Q

My feeling is that it's not essentially, but definitely nice to have. e.g. as @dnadlinger points out, having an ethernet port on DRTIO slaves for diagnostics/streaming data off. Also, on Kasli-Zynq how will we do ethernet? If we use the PS MAC, can we easily switch that between ethernet and DRTIO (transceiver) as we currently do? If not, then slaves only have 1 downstream port, which is a bit obnoxious for growing DRTIO trees.

gkasprow, 2019-05-22:
It depends which ZynQ you use. GTR transceivers do not support 1000BaseX, only SGMII. An obvious thing is to use the same PHY we use in Sayma and connect it to RGMII. Such configuration works nicely.
Once  I had to use GTH transceivers with Ethernet SFP modules, but only 1000Mbit was supported by Xilinx Linux kernel. I didn't manage to make GTH working in SGMII mode for other speeds than 1Gbit. It's probably not a problem here but SFP + ZYnq transceiver + EMAC configuration does not work so nicely as it should. We won't use LInux here so maybe such issues won't appear.

marmeladapk, 2019-08-21:
For now I placed 75640-5001 2x1 connector. It's necessary because I need more space for WR-like clocking. I'm still on the verge whether to put 2x2 SFP or leave SATA. @gkasprow is there a difference between 2x2 and 2x1 availability?

On a side note, 2x1 connector is longer, so I had to move EEM connectors.

gkasprow, 2019-08-21:
choose the one that is available from more sources and make sure does not have EOL status.

marmeladapk, 2019-08-22:
I'll use 2x2 cage and place SATA connector above the cage with 0201 jumpers connecting to SFP by default. Unless @sbourdeauducq is willing to forgo the SATA port.
I'll place [Amphenol UE78B212700321](https://www.amphenol-icc.com/sfp-ue78b212700321.html), it seems to be the cheapest available option.

marmeladapk, 2019-08-27:
@jordens @hartytp Additional SFP requires an additional I2C bus. Is it okay to merge Si5324 and Main Si549 I2C buses? I don't think that Si5324 and Si549 will be used in the same time and this gives us a free slot in I2C switch (IC15) for SFP3.

jordens, 2019-08-27:
Fine with me. But I think the I2C gateware is different for the Si5324 and the WR oscilators (bit bang GPIO vs proper gateware I2C). If I am not completely wrong, the helper oscillator might be doable with bitbanging in software though. @sbourdeauducq
Moving the Si5324 off of the I2C switch is definitely fine. But on that same bus there is the EEPROM which can't be shared with any of the other I2C extender buses and also should be accessible to the FT4232.
In that case it might be easiest to skip the I2C bus of the last SFP module.

sbourdeauducq, 2019-08-28:
I am already planning to support bit-banging the Si549 bus in software, so that firmware can initialize (and debug) it instead of gateware. Then there is a multiplexer that selects the gateware I2C engine.
https://github.com/m-labs/artiq/blob/wrpll/artiq/gateware/wrpll/si549.py
So this sounds fine. And anyway, I suppose that there would be different firmware/gateware depending on whether one uses the Si5324 or the Si549?

marmeladapk, 2019-08-28:
I'll connect EEPROM to SFP_3 bus with jumpers. Additionally I'll add jumpers to SFP_3, so we'll have the option to disconnect one or the other with BOM change.

marmeladapk, 2019-08-28:
@jordens On a second thought I'll leave Si5324, EEPROM and SFP3 on the same bus but I'll change EEPROM to one that has address pins. Without them it takes to much of address space and collides with SFP (as far as I've read).
So now we'll have:
Si5324: 0x68
EEPROM: 0x57
SFP3: 0x50 and 0x51.
with jumpers to each device.

jordens, 2019-08-29:
That's good.

Closed 2019-08-28.

Thread 44 (2019-08-01):

FPGA temperature control

jordens, 2019-08-01:
If a bigger/better heat sink can not keep the die temperature low enough in typical air flow conditions (I don't want to rely on forced airflow for these crates, most people don't seem to bother with that), then we need to go for a small fan and fan controller. Depends on a realistic power budget and thermal sim.

E.g. [MAX6639](https://datasheets.maximintegrated.com/en/ds/MAX6639-MAX6639F.pdf) which is also used in other projects, e.g. DIOT. The DXP/N diode connections on the FPGA die are there.

This would probably be required for Kasli-ZYNQ anyway which makes this the perfect place to test it on.

* https://github.com/sinara-hw/Kasli/issues/5#issuecomment-396934974  for the original request
* #7 for the heat sink

sbourdeauducq, 2019-08-01:
Do we need a fan controller or can the fan be simply left on at all times?

jordens, 2019-08-01:
The controller would increase the lifetime of the fan, lower power usage (up to 1W), allow monitoring over I2C, and provide protection against fan failure and overtemperature. Since the thermal shutdown of the FPGA is AFAICT above it's maximum junction temperature (certainly for the commercial temperature range) this seems required.

sbourdeauducq, 2019-08-01:
Absolute maximum temperature rating is the same for all industrial/expanded/military grades. So, if we are above the recommended temperature for the commercial grade but below the thermal shutdown threshold, the FPGA may not operate correctly (due to slowing down of the silicon and timing paths failing, likely) but should not be permanently damaged.

sbourdeauducq, 2019-08-01:
That being said, if the fan controller has good reset behavior (i.e. by default and without having to
use SMBus, the fan is on and the FANFAIL pin is working) then it's fine to use it and connect FANFAIL to e.g. the power supply control, for extra safety. I have little trust in most silicon vendors when it comes to this sort of things (especially since this particular MAX chip comes from the PC market which has a track record of awful standards such as ACPI, EFI and USB3), so this should probably be tested beforehand.

jordens, 2019-08-01:
Just connect FANFAIL. No requirement to juggle SMBus. There is no ACPI, EFI or USB3 involved here.

gkasprow, 2019-08-05:
we can place LM75-like sensor (in SOT23) close to the FPGA. It does not need any initialization and would shut down the power supply at ~80 degrees.
The MAX6649 should also work that way, but I did not test it. We can choose  85,95 or 125 deg version.
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

sbourdeauducq, 2019-08-05:
@gkasprow I think @jordens means the  MAX66**3**9, which contains a fan controller.

gkasprow, 2019-08-05:
Yes, but I'm not sure it will work without initialization. The MAX6639 needs multi-pole or high-speed fans that generate high-frequency pulses. It generates funny haunting-noise with fans with tachometers slower than 400Hz. Small fans usually meet this condition.

sbourdeauducq, 2019-08-08:
Should I order one and test it? IMO, poor reset behavior (i.e. the fan is off before configuration) is pretty bad because:
* it increases the risk for us if the configuration doesn't work for any reason.
* it makes it more difficult and frustrating to load alternative FPGA designs into Kasli, since those may need to initialize the fan controller. In my experience, many FPGA designs, including the quasi-totality of ARTIQ bitstreams, cause enough heating that a fan is necessary.

gkasprow, 2019-08-08:
@sbourdeauducq it depends on how you connect the fan. You can use PMOS or NMOS. One of these configurations will turn on fans before config. In Booster we have another one.

sbourdeauducq, 2019-08-08:
Oh, I see - yes, we can try something like that, though I think this still needs testing. There's also a proposed solution in the datasheet (figure 9) for the noise.

marmeladapk, 2019-09-03:
I found [this fansink](https://www.radianheatsinks.com/product/fi23/), which fits our package and does not require mounting holes however it does not have tachometer output.

jordens, 2019-09-03:
Looks like the KC705 thing. I am fine with this and either a fan controller or LM75 if you (@marmeladapk and @gkasprow) think its easier, less noisy, and serves the purpose.
30 khours are just 3.5 years but there are very few fans that offer significantly more (e.g. 70kh for some).

hartytp, 2019-09-03:
> 30 khours are just 3.5 years but there are very few fans that offer significantly more (e.g. 70kh for some).

Indeed. The benefit of a fan controller is that it pushes that up by a factor of a few if used in a decent thermal environment...

marmeladapk, 2019-09-04:
If we don't have tachometer then I can put just a connection to transistor base:
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
This way you cannot shut it down completely in case of a fault.
Radian wrote to me that they couldn't find a fan of this size with tachometer so it's unlikely that I'll find anything.

marmeladapk, 2019-09-04:
Do we want MAX6646 to shutdown all supply rails? With a FP red LED to indicate overtemperature. I'm only worried about LVDS inputs from EEMs and GTP inputs damaging the FPGA while it's disabled (these are the only signals that could reach the FPGA). @gkasprow is this something to worry about? Also this would disable 3V3MP on EEMs while keeping 12V on.
I will place another MIC5219-3.3 (same as used for FTDI supply) to make P3V3_MP for overtemp LED and MAX6646. It consumes max 400uA, so no worries there.

jordens, 2019-09-04:
Won't that circuit lead to weird behavior and gain reversal if the minimum duty cycle is 0 and the temperature is low enough?

GTP inputs should be AC coupled and the SFP modules should be turned off with the FPGA, right? AC signals coming in on direct-attach cables would generally be a problem independent of over temp or fain failure shutdown.
I'd be interested to hear what EEM LVDS signals would do if the FPGA is unpowered. This is generally tricky for "remote EEMs" that are powered independently.

But if we don't control the fan to gain lifetime, then for over temperature shutdown, we should just use the XADC and lower the threshold accordingly. The MAX664[679] don't seem useful then.
Maybe we can just wire the XADC to control the fan threshold as well (binary on/off , no PWM, large hysteresis to not oscillate).

What about other boards like the [Digilent Zybo Z7](https://reference.digilentinc.com/_media/reference/programmable-logic/zybo-z7/zybo-z7_rm.pdf)?
They have smaller packages, screw the fan in between the fins and are using the long life Sunon fans.

The [Genesys 2](https://reference.digilentinc.com/_media/reference/programmable-logic/genesys-2/genesys2_rm.pdf) has a tacho controlled fan for the FFG900 package, maybe we can copy from that.

Also, there should probably be some additional filtering between P12V0 and the fan. Might make sense to connect it to the upstream side of the big power supply EMI filter.

hartytp, 2019-09-04:
Not critical, but it would be fun if we could control the fan speed to stabilize the FPGA temperature e.g. to get ultra-stable clock recovery.

marmeladapk, 2019-09-10:
@jordens
> Won't that circuit lead to weird behavior and gain reversal if the minimum duty cycle is 0 and the temperature is low enough?

That was the plan - if FAN_PWM line is shorted to DC then it won't turn off the fan.

> AC signals coming in on direct-attach cables would generally be a problem independent of over temp or fain failure shutdown.

Yes, it's also a problem with external media converters.

> What about other boards like the Digilent Zybo Z7? They have smaller packages, screw the fan in between the fins and are using the long life Sunon fans.

Thanks! [This one is available](http://portal.sunon.com.tw:7778/images/sunon/rddoc/201712/266105/(D01002820G-00)-1.pdf?20190905005103) from [TME](https://www.tme.eu/en/details/mf17080v1-g99-a/dc5v-fans/sunon/mf17080v1-1000u-g99), however I'm not sure if we'll be able to screw it in the heatsink. There's also [another fansink](http://www.malico.com.tw/index.php?option=com_content&view=article&id=349:hf23&catid=70:hf&Itemid=341) from this company, perhaps with tacho. However I'm not sure about pricing or availability of those. I'm also not sure if ordering them from Malico and not through a distributor is a good idea. There's also a UK based company which has the same fansink in offer, I sent them an email. This fan however requires  5V supply.

@jordens So if we don't have a tacho then you don't want any additional temp. sensor?

jordens, 2019-09-10:
I'm probably not the most experienced person designing FPGA cooling solutions. But if we don't have a tacho and if PWM is too noisy then I'd just go for the XADC doing OT shutdown and fan on/off via ALM[0], i.e. no additional sensor and no fan controller.

Closed 2019-09-19.

Thread 45 (2019-08-19):

Kasli PCB Schematic PDF file

cnourshargh, 2019-08-19:
Can a PDF version of the Kasli schematic be added? I don't have access to a software package to view to files in the repository.

jordens, 2019-08-19:
See releases

Closed 2019-08-19.

Thread 46 (2019-08-27):

I2C pullups and I2C repeaters

jordens, 2019-08-27:
* Raise the 2k2 pullups at the I2C extender downstream side (R155-R190) to 10k: there is already 2k2 in parallel on the upstream side and 10k (typical) on each EEM. Downstream EEMs that support being I2C masters need special consideration anyway and will pull up stronger themselves. Having too strong pullups risks violating V-in-low and current compliance.
* Raise R146 and R147 to 10k. That segment is only driven by IC13 and the FPGA and can get a weaker pullup (low capacitance by design). Same for R206/R207 and R25/R26.
* The EN input to the TCA9517DGKR is referenced to and pulled up internally by the B side (VCCB). The B side outputs are somewhat stronger but don't run at 2.5V. IC13 and IC22 and IC7 are externally pulled up/driven by the A side. The side choice seems correct. But: consider removing external pullups on EN on IC7 and IC13 and making R208 2k2 to pull down stronger than the internal B side pullup if there is no USB power.

Changes are schematics/BOM-only.

jordens, 2019-08-27:
Also check:

> 9.3.3 VOL B-Side Offset Voltage
The B-side drivers operate from 2.7 V to 5.5 V. The output low level for this internal buffer is approximately 0.5 V,
but the input voltage must be 70 mV or more below the output low level when the output internally is driven low.
The higher-voltage low signal is called a buffered low. When the B-side I/O is driven low internally, the low is not
recognized as a low by the input. This feature prevents a lockup condition from occurring when the input low
condition is released. This type of design prevents 2 B-side ports from being connected to each other.

I don't really understand the "internally" notion. But the "This type of design prevents 2 B-side ports from being connected to each other." is what we are doing with IC13 and IC22. Might be wrong.

(sidenote: I have seen I2C issues on Kasli but couldn't figure out why and where).

jordens, 2019-08-27:
I think 9.3.3. means that we can't talk I2C between the FPGA I2C and the FT4232 the way we have set it up.

marmeladapk, 2019-08-29:
@jordens I implemented changes that you suggested.

Regarding I2C issues, I had one on EEM with Si570, where it didn't accept low level of ~0,5V-0,55V. Changing pull-up resistor value didn't help. I added another TCA9517 with B-side connected to Kasli and A-side facing the board (A-side generates true low states) and it worked despite the warning. I can measure voltage levels on this board if you want.

hartytp, 2019-08-29:
@marmeladapk what's the current time line for getting the new version of Kasli ready for manufacture?

jordens, 2019-08-29:
@marmeladapk We have an EEM with a Si570?
I am also worried by the 0.5 V Vol of the B side and I agree that weakening the pull ups may not be sufficient to make it robust. But I'd be equally worried about running the B side on 2.5 V.
Any other I2C extender? Or should we just hope for the best?

jordens, 2019-09-05:
Maybe look at [PCA9306](https://www.nxp.com/docs/en/data-sheet/PCA9306.pdf). Doesn't mention that high VOL and seems to be more symmetric. It also has a lot of advice about pull up strength on both sides. Same package but unfortunately not pin compatible.

jordens, 2019-09-13:
Or maybe we could look at active pull-ups like the [LTC1694](https://www.analog.com/media/en/technical-documentation/data-sheets/1694fa.pdf)?

marmeladapk, 2019-09-18:
Active pullups don't seem to solve this problem as ~0,5V bias is inherently in TCA buffer and we can only push it up or down 100mV or so. So we can only hide this problem until another problematic part shows up.

Hmm, I'm worried about this: "Vref(1)-Vbias(ref)(2)>=1 V for best results in level shifting application" in PCA from maxim. They don't seem to specify what's worse when voltage difference is less than 1V.

[Similar part from TI](https://www.ti.com/lit/ds/symlink/pca9306.pdf) lists 2V5 to 3V3 translation (part has V1-V2>=0,6V)  and I think we can use it. We don't need buffering and isolation of such a short path to FPGA is pointless (it's only around 1 pF/cm). One minus is that we'll have enable signal connected to 3V3 rail, which wakes up earlier than 2V5, but all pins are supposedly open-drain, so it should not be a problem.

jordens, 2019-09-18:
Yes. That's the PCA9306 I mentioned. They say that the propagation delays become more symmetric and slower the lower the voltage difference.
Are you sure we don't need to buffer the FPGA? The I2C switches are all is passive and in the worst case there is about 1m of ribbon cabling, a couple 10k (hopefully no 2k anymore) pullups, a couple more I2C switches (e.g. Banker, Humpback, VHDCI Adapter) plus slave devices, and maybe even some VHDCI cable on it.

marmeladapk, 2019-09-18:
> Yes. That's the PCA9306 I mentioned.

You linked PCA9306 from NXP (not from maxim as I initially wrote) which has a different threshold.

> Are you sure we don't need to buffer the FPGA?

This way can only shave off around 10 pF of PCA input capacitance + 4-5 pF as there's only trace capacitance on the path to the FPGA. I don't it will make a huge difference and if we're worried about it then we should place repeaters on slave devices where it will make a real difference.

jordens, 2019-09-18:
Right. The TI version differs quite a bit, also in switch resistance.

I don't get your logic of the repeater. Both master and slave need to be able to drive down the lines and see the pull up raise them. Ignoring transmission line effect (as one apparently does with I2C), that will look the same from both ends independent of where the pull up is, and will require the same "beefiness" on both sides.

marmeladapk, 2019-09-18:
Repeaters = active buffers in my train of thought (maybe I didn't state that clearly). So effectively the capacitance (and pull ups) of I2C bus after the buffer won't be visible for devices driving the buffer. They only need to drive the bus up until the buffer part, and the buffer will drive the part of the bus after it (both ways). So if we put buffers near EEM connectors on slaves then we "cut" the bus in ~half (as well as we can).

If we put a buffer 5cm from the FPGA then we only separate 5pF of trace capacitance that the FPGA has to drive. That buffer has to drive the rest and I think that it doesn't make any difference.

jordens, 2019-09-18:
Ok. Then we agree that EEMs like Banker, Humpback, VHDCI Adapter should get some buffer because they are likely to sit mid span. And if we say that both the FPGA and e.g. some 24c EEPROM on an EEM are ok driving the bus segment between them un-buffered, then we are ok with those passive level translating switches.

marmeladapk, 2019-09-18:
I'm not sure if we need them. Artix-7 has higher drive strength than PCA9517 is specified for (16mA vs 6 mA) so for the FPGA it shouldn't make a difference. Meanwhile slave devices on EEMs shouldn't feel a big difference between TCA and PCA sitting near the FPGA (it's additional 5pF of trace + 8 pF of pin capacitance). Plus I changed pull up resistors on slave side following your request. So if slave devices on EEMs like Banker worked before then they should also work now.

If you're still worried about it I can place pinout for TCA9517 on the bottom and DNP it to have a backup plan. I2C proved to work in mysterious ways many times already.

jordens, 2019-09-18:
I am ok with just the TI PCA9306 for translation and the 2k2 on the master segment and 10k on the EEM segments. That should improve the situation a lot.

marmeladapk, 2019-09-18:
Currently we have:
10k on 2V5 bus to FPGA <- PCA -> 2k2 on 3V3 bus <- TCA9548 fanout -> 10k on downstream bus to EEMs.

jordens, 2019-09-18:
Excellent.

Closed 2019-09-19.

Thread 47 (2019-09-19):

EEM SI simulation

jordens, 2019-09-19:
I'd be interested in seeing the simulated SI of a EEM output from Kasli. Including the FPGA, IDC connectors, 1m ribbon cable, another IDC connector, random patterns on adjacent aggressor channels.

This would be useful for [Fastino](https://github.com/sinara-hw/Fastino/issues/15
) and for the [Urukul SYNC issue](https://github.com/sinara-hw/Urukul/issues/16).

@hartytp did some nice measurements in #14

gkasprow, 2019-09-19:
I'm afraid it would be hard to find S-models of IDC connectors and assemblies. One can theoretically simulate using connector step model as the geometry but I don't know material characteristics to make it practical.
The easiest way to go would be measurements with a high-speed scope and diff probe.

hartytp, 2019-10-01:
Closing this, as it seems like nothing is going to happen here, but please do reopen if you have further requests along these lines.

Closed 2019-10-01.

Thread 48 (2019-10-01):

Kasli V2.0 Si549 Decoupling

WeiDaZhang, 2019-10-01:
A few capacitors on NET P2V5_LDO might be helpful for decoupling the supply rails for the two Si549s.

hartytp, 2019-10-01:
Should there be FBs on the power lines to decouple the two DCXOs from each other?

marmeladapk, 2019-10-16:
My bad.

Closed 2019-10-16.

Thread 49 (2019-10-01):

LVDS DCXOs

hartytp, 2019-10-01:
@marmeladapk AFICT the LVDS Si549 currently has good availability, while the CMOS ones are hard to find. Shall we switch to the LVDS parts (needs RC changes as well)?

marmeladapk, 2019-10-16:
I made a second variant with LVDS Si549:
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
This the only LVDS Si549 that I found to be available. I also DNPed helper termination in this variant near FPGA.

hartytp, 2019-10-16:
@WeiDaZhang can you look at this and sign off asap please? (Check terminations, coupling, voltage levels, part numbers, component availability, etc).

hartytp, 2019-10-16:
@marmeladapk were any changes required for the coupling of the helper PLL to the FPGA?

hartytp, 2019-10-16:
other than that, LGTM

marmeladapk, 2019-10-16:
@hartytp I don't think so, at FPGA we'll use LVDS receiver with termination and Si549 has standard common mode output voltage level.

hartytp, 2019-10-16:
cool

WeiDaZhang, 2019-10-16:
@hartytp
They all look right.

hartytp, 2019-10-16:
Cool.

hartytp, 2019-10-17:
@marmeladapk for LVDS DCXO, don't you need to DNP R225 (the termination on the helper DCXO at the FPGA)?

marmeladapk, 2019-10-17:
@hartytp It is DNPed.

hartytp, 2019-10-17:
Aah, okay, great!

Closed 2019-10-17.

Thread 50 (2019-10-02):

SMA clock in isolation

hartytp, 2019-10-02:
Question: what's the current thinking on isolating the SMA clock in? IIRC we agreed that using capacitors to float grounds was a bad idea, but how do we feel about isolation transformers?

I ask because the clock in SMA currently goes through a DC isolating transformer, which we're not actually using as such.

What about connecting the input ground of TR1 to the input SMA ground rather than the circuit ground and removing the capacitors that tie the SMA and circuit ground together? We can keep the 0R jumper populated by default so that the two grounds are tied together by default, but this would give the users an easy path (by removing the 0R resistors) to isolate the grounds galvanically.

Thoughts? @jordens

jordens, 2019-10-03:
Yes. That sounds good to me with the 0r populated.

Closed 2019-10-16.

Thread 52 (2019-10-02):

DC couple the Si5324 into the ADCLK

hartytp, 2019-10-02:
Why AC-couple it? Having a well-defined DC level at the clock buffer input would help to avoid oscillations (the Si5324 can be shutdown from software giving a logic low at the input, so won't oscillate unlike the buffers)

marmeladapk, 2019-10-15:
@hartytp Currently Si5324 outputs are configured as LVDS on all boards in ARTIQ and LVDS has different common level than LVPECL.

Also this:
> The LVPECL outputs are “LVPECL compatible.” No DC biasing circuitry is required to drive a standard LVPECL load.

and this:
> It is recommended that the outputs be ac coupled to avoid common mode issues.

from Si53xx reference manual doesn't give me much confidence in DC coupling those outputs. I'd leave it as it is unless you have seen problems caused by current coupling.

Closed 2019-10-15.

Thread 53 (2019-10-02):

schematic review

hartytp, 2019-10-02:
@marmeladapk I looked at the schematics. They look good!

I've raised a few issues, mainly with questions. Other that that LGTM. NB however I haven't done the kind of thorough review I've done for the EEMs (checking every pin on every IC, reference designs, etc), I assume that wasn't expected for this release.

@sbourdeauducq @WeiDaZhang can you sign off on the WR parts?

@jordens @sbourdeauducq are you happy to sign off on the design over all?

gkasprow, 2019-10-02:
- [ ] is there any reason to keep the SATA connector?
- [ ] what about removing boot mode selection resistors? Are there any plans to change it?
- [ ] the same with DXN, DXP resistors
- [ ] I'd replace L23, L35 with 1..2.2u inductors. FB has near 0R impedance at the buck frequency. Don't forget about adding poor tantalium to dump LC oscillations.
- [ ] I2C_3V3_SDA/SCL should be called I2C_3V3_SW_SDA/SCL
- [ ] add ordinary diode in parallel to J21. This is to protect the MOSFET and fan
- [ ] 0.5pF caps are not needed with XFMR_MINI-CIRCUITS_TC2-1TX+
- [ ] connect pin 6 of TC2-1TX+ to SMA GND via DNP 0R. At the moment we cannot use isolation potential of the transformer.

sbourdeauducq, 2019-10-02:
>     * is there any reason to keep the SATA connector?

We use it for connecting two Kasli in the same crate with DRTIO. It's a somewhat uncommon use case though.

gkasprow, 2019-10-03:
Now you can do the same with sfp patchcord

hartytp, 2019-10-08:
@jordens @sbourdeauducq have you signed off on this design review?

jordens, 2019-10-16:
Oh. And excellent work on the git commit messages, changelog, and issue tracking @marmeladapk ! Thanks.

hartytp, 2019-10-16:
> Does it make sense to go for the Si53340-B-GM instead of ADCLK948 IC1 and add two more MMCX clock outs? We use it on Urukul already. And it can run at 2.5 V which may make ditching the Si5324 together with its supply more efficient later.

Fine by me. @WeiDaZhang any objections.

@WeiDaZhang please can you confirm that you're happy to sign off on the clocking part of this design asap (apologies if you've already done that!).

Other than that, I'm happy to sign off

hartytp, 2019-10-16:
@WeiDaZhang did you check the rest of the clocking? (I think you did this ages ago, but want to double check you still happy) If so, we just need @sbourdeauducq to sign off on the WR PLL implementation from his side and then I think all reviews are complete.

Would be great to get this off to manufacture in the next week or so

WeiDaZhang, 2019-10-16:
> Fine by me. @WeiDaZhang any objections.

We measured before that ADCLK948 has flicker phase noise of -145dBc/Hz@10kHz offset at 1GHz carrier.
Si53340-B-GM seems to be -137dBc/Hz@10kHz offset at 312MHz, which is slightly worse.

Our WR is no better than 1x10^-13 mod Allan, which about -120dBc/Hz@10kHz offset at 312MHz.
So, should not make any difference.

hartytp, 2019-10-16:
Yes. This is the kind of thing that would have worried me a year ago, but I think we now understand the performance bottlenecks well enough to know that this will not be a limitation (eg compared to the transceiver pll)

@WeiDaZhang are you happy to sign off on the complete design?

WeiDaZhang, 2019-10-16:
> Yes. This is the kind of thing that would have worried me a year ago, but I think we now understand the performance bottlenecks well enough to know that this will not be a limitation (eg compared to the transceiver pll)
>
> @WeiDaZhang are you happy to sign off on the complete design?

Happy

hartytp, 2019-10-16:
Cool so we just need @sbourdeauducq to sign off on the wr connections and then the review is complete

sbourdeauducq, 2019-10-17:
Except for the support for CMOS Si549 oscillators, this looks OK to me.

hartytp, 2019-10-24:
@marmeladapk Okay, everyone has now completed their reviews. So...when can this go to manufacture?

hartytp, 2019-10-26:
@marmeladapk heads up: the grant we used to pay for our creotech kaslis expires soon so we need to get them to manufacture ASAP to avoid problems

hartytp, 2019-11-23:
Ping @marmeladapk @gkasprow we really need to get kasli 2.0 sent to manufacture in the next week before the grant that paid for the work ends. This is very important to us. In any case, it seems like almost all the work is done already

marmeladapk, 2019-11-28:
@hartytp Layout and schematics are finished.

hartytp, 2019-11-28:
Nice!

I've had a skim over the schematics and it looks good to me. I haven't done the usual thorough design review (check every pin description, eval board/ref design, pin abs max ratings, required capacitances, etc etc) as I'm assuming you did that @marmeladapk

@WeiDaZhang can you sign off on the WR/clocking please?

@sbourdeauducq @jordens are you happy with this revision? I'd like to send boards to manufacture on monday if possible.

hartytp, 2019-11-29:
@marmeladapk can you remind me which areas had changes? It's worth us carefully reviewing all changes to ensure we don't break anything...

hartytp, 2019-11-29:
I went over the clock page one last time (the only page that has significant changes that I feel qualified to review). Other than cosmetics I don't see any issues.

Any objections to cutting this release on Monday morning?

WeiDaZhang, 2019-11-29:
> I went over the clock page one last time (the only page that has significant changes that I feel qualified to review). Other than cosmetics I don't see any issues.
>
> Any objections to cutting this release on Monday morning?

May I ask why that?
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
Select the power between 2.5/3.3 I suppose.
If so, shall we use P3V3_LDO1 instead then, as Si549s shall not be used at the same time when Si5324 is in use.

hartytp, 2019-12-01:
Thanks @marmeladapk!

I'm assuming everyone has completed their reviews (@WeiDaZhang @sbourdeauducq @jordens ) so we can close this and go to manufacture on Monday once the last straggling issues are closed.

hartytp, 2020-02-25:
I saw a box labelled Kasli 2 at CTI so I guess this exists now...

hartytp, 2020-02-27:
@marmeladapk we really need these in our lab ASAP. When can you ship them?

marmeladapk, 2020-02-28:
@hartytp I don't even have them on my desk. Do you really want us to send you untested hardware without panels? AFAIK we should receive Kaslis on Monday from production (it's currently during inspection).

Besides you should write to Anna about this not to me, as it's her decision not mine when to ship it.

hartytp, 2020-02-28:
Thanks for the update. Please do test before shipping. Okay, so if receive them on Monday, is it realistic to think that testing will be complete by end of next week?

akaminska, 2020-02-28:
Hi Tom @hartytp , Kasli is still in optical inspection after production. We should get the boards for testing Tuesday morning. We will keep you posted on the progress.

hartytp, 2020-02-28:
Great! Thanks for the update.

marmeladapk, 2020-03-04:
@hartytp @jordens

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

This SFP cage is massive.

We're now validating if our tests work correctly with the new hardware.

sbourdeauducq, 2020-03-04:
Looks good!
Where is the fan plugged?

marmeladapk, 2020-03-04:
J21, above the FPGA. (2-pin header). Currently the pins are too short, but I plan to change them to header with key, which won't allow reverse connection.

hartytp, 2020-03-04:
Awesome, looks beautiful! Good job @marmeladapk

hartytp, 2020-03-04:
When do the panels arrive?

akaminska, 2020-03-04:
On Monday at the latest.

jordens, 2020-03-04:
Re availability of the SFP cages: I noticed that even Cisco would use two 2x1 cages next to each other when they need 4 SFP and not a 2x2.
And what are we going to do with all the unused space when we go to cPCIs...

gkasprow, 2020-03-04:
CPCIS is not an issue because Kasli would be rotated 180degs and the panel can still be 8HP

jordens, 2020-03-04:
I'm not worried about panel space (and for 4 HP, the cooling stack may or may not be in the way as well).
I was wondering whether there is anything useful we can do with all the unused space of the IDC rats nest which occupies half the entire board area.

marmeladapk, 2020-03-04:
Most of that space will still be required to escape from under the bga package. But perhaps we could make Kasli and other CPCIS boards shorter (160mm)?

gkasprow, 2020-03-04:
The idea behind existing Kasli was to add simple adapter that converts EEMs to CPCI.

jordens, 2020-03-04:
I think it will be much better to draw a line and transition a sufficient set of several modules to cPCIs in one go without adapters.

gkasprow, 2020-03-04:
Yes, but for the moment essential part of the community seems to be happy with existing solution

jordens, 2020-03-04:
The community that M-Labs and QUARTIQ serve would very much appreciate a better solution.

marmeladapk, 2020-03-04:
Kasli v1.1 gateware with uart pins moved to new positions.
```
Initializing SDRAM...
Read leveling scan:
Module 1:
00000000000111111111110000000000
Module 0:
00000000000111111111110000000000
Read leveling: 16+-5 16+-5 done
SDRAM initialized
Memory test passed

Booting from flash...
Starting firmware.
[     0.000004s]  INFO(satman): ARTIQ satellite manager starting...
[     0.005612s]  INFO(satman): software ident 5.0.dev+848.g2a909839.dirty;satellite
[     0.013025s]  INFO(satman): gateware ident 5.0.dev+848.g2a909839.dirty;satellite
panic at src/libcore/result.rs:945:5: cannot initialize Si5324: "Si5324 failed to ack write address"
```
I also moved I2C SDA. It seems that I2C works at least initially (no I2C switch error). We'll test this further using our test bench.

akaminska, 2020-03-04:
From the point of view of managing hardware production and stocks, focusing on a specific format of cards for the future instead of having two versions of most cards would make life easier

hartytp, 2020-03-04:
Awesome @marmeladapk

Re cpics: I can see this being what we want long term but would be nice to have a play with the adapter boards and existing eems before making a decision

gkasprow, 2020-03-04:
this is exactly what we do right now. 3 adapters would be needed to serve all EEM boards.

Closed 2019-12-01.

Thread 54 (2019-10-16):

harmonize I2C GPIO extender pinout

jordens, 2019-10-16:
It would be nice if the SFP IOs would be in the same pattern accross the four banks. That makes the code simpler and less error-prone. I.e. use `GPx[0:5]` for the four SFPs in the same pin assignment.

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

Closed 2019-11-28.

Thread 55 (2019-10-17):

float Si549 OE

sbourdeauducq, 2019-10-17:
* The OE signal can be replaced with register 17 to save a few parts.
* Si549 devices ship with a built-in pull-up or pull-down, depending if OE is active-high or active-low, that activates the output. So it can be left floating.

jordens, 2019-10-17:
The mux has limited isolation. It will be necessary to turn of the unused input. If the Si5324 is used, it seems easier to disable the Si549s via the GPIO extender than via Si549 I2C commands.

sbourdeauducq, 2019-10-21:
> it seems easier to disable the Si549s via the GPIO extender

What is the availability of Si549 variants @gkasprow ? Does it help if the board can be stuffed with either a OE-active-high or a OE-active-low model and be indifferent to it ?

gkasprow, 2019-10-21:
It is poor. At the moment, we have only [this one](https://pl.mouser.com/ProductDetail/Silicon-Labs/549BACB001937ABG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)

marmeladapk, 2019-11-28:
It's already implemented and doesn't affect the cost much.

Closed 2019-11-28.

Thread 56 (2019-10-17):

CMOS Si549 support

sbourdeauducq, 2019-10-17:
With the Si549 connected for CMOS:
Why is there a parallel 51 ohm termination for the FPGA? This is not recommended by the Si549 datasheet.
When the Si549 feeds the ADCLK, it also has a 51 ohm series attenuator, and cannot see a 50 ohm impedance. Why does it appear to be not a problem here while the FPGA would need termination?

marmeladapk, 2019-11-26:
> Why is there a parallel 51 ohm termination for the FPGA? This is not recommended by the Si549 datasheet.

It terminates the signal, just differently than series termination. BTW I will change this resistor to ~70 Ohm to match trace impedance.

> When the Si549 feeds the ADCLK, it also has a 51 ohm series attenuator, and cannot see a 50 ohm impedance. Why does it appear to be not a problem here while the FPGA would need termination?

ADCLK has built in 50 Ohm resistors. Come to think of it we may change R37 to 30 Ohm. It will still attenuate signal below maximum value.

marmeladapk, 2019-11-26:
Actually @gkasprow noticed, that series termination is preffered because oscillator may not be able to supply enough current into termination. So I'll change helper termination to 30 ohm series and main also to 30 ohm series.

Closed 2019-11-28.

Thread 58 (2019-11-28):

rear power connector

hartytp, 2019-11-28:
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

Will that cause issues getting the EEMs in/out?

marmeladapk, 2019-11-29:
Again, perspective.
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

Closed 2019-11-29.

Thread 59 (2019-11-28):

R225

hartytp, 2019-11-28:
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

Why is it 30R instead of 0R if we're using a LVDS DCXO?

marmeladapk, 2019-11-29:
@hartytp You're correct, alternative part must have been reset when changing library reference.

hartytp, 2019-11-29:
Ok. Can you double check any other parts you changed in case I missed something?

marmeladapk, 2019-12-03:
Curiously BOM was generated correctly with R225 being 0R.

Closed 2019-12-15.

Thread 62 (2019-11-29):

unused PGs

hartytp, 2019-11-29:
On the clock page, the LDOs have PGFB resistors populated but the PGs aren't connected. Why bother?

IC7 even has a PG pull up but the PG isn't connected.

Not a serious issue, just seems a bit odd.

marmeladapk, 2019-12-03:
It's for fast startup - when PGFB is below 300mV SET current is increased to 2 mA to charge SET capacitor faster. Otherwise startup of those LDOs would take seconds.

Closed 2019-12-03.

Thread 63 (2019-11-29):

unused clock complementary outputs

hartytp, 2019-11-29:
On IC1 (clock buffer) some of the complementary outputs aren't connected. IIRC it's recommended practice to always bias both halves of LVPECL even when only using one (otherwise it unbalances the output stage).

marmeladapk, 2019-12-03:
@hartytp In v1.0 we did so to save power. https://github.com/sinara-hw/sinara/issues/204#issue-231061933

hartytp, 2019-12-03:
Ok, makes sense. However, reading app notes recently, it seems that this is not recommended practice. I can't quantify how bad it is though.

Can we add DNPd termination resistors? When the boards arrive I'll try to find time to do some testing to determine if it's worth populating them in future.

marmeladapk, 2019-12-03:
I didn't see any significant difference between v1.0 and v1.1 (though in v1.1 there was adclk944).

It might be tricky to add resistors now, I'll check.

hartytp, 2019-12-03:
Did you look at phase noise/PSRR? Anyway, if this can't easily be done then don't bother. If you can do it easily then it seems worth it.

Closed 2019-12-15.

Thread 64 (2019-11-29):

incorrect annotation

hartytp, 2019-11-29:
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

No longer true

marmeladapk, 2019-12-03:
It is true, because LVDS Si549 is in a variant. If you open schematics in Altium, CMOS version is placed by default and LVDS is alternative part.

Closed 2019-12-15.

Thread 66 (2020-02-27):

SMPS Emissions

hartytp, 2020-02-27:
@gkasprow when we tested Fastino we saw some relatively large spurs which originated from the main SMPS on Kasli (main frequency is 450kHz, but we also saw (sub)harmonics). @pathfinder49 can you post links the the relevant issues with details please?

The spurs seemed to be heavily dependent on grounding, and could be removed by using a P12V SU with very high AC CMMR/filtering (e.g. an isolated bench supply with an additional CMC + capacitors) to power Kasli. This suggests that the SMPS on Kasli generates relatively large conducted emissions.

Since you have a nice EMI tester in your lab gathering dust, shall we have a look at the emissions from Kasli (doesn't need Fastino to do this)?

If we do find that the emissions are high, we should consider improvements for the next revision. The obvious thing would be to put an LC filter at the SMPS input to prevent noise from coupling onto the 12V network. We should also look again at the layout and see if there are easy ways of optimising it for noise...

pathfinder49, 2020-02-27:
Conducted SMPS noise from Kasli is concisely presented in [this summary](https://github.com/sinara-hw/Fastino/issues/56). A less structured discussion when investigation this is found [here](https://github.com/sinara-hw/Fastino/issues/55).

The SMPS also produces radiated noise, which is [discussed here](https://github.com/sinara-hw/Fastino/issues/59).

pathfinder49, 2020-07-07:
I just came across [these Zotino measurements](https://github.com/sinara-hw/Zotino/issues/21#issuecomment-380472116). This looks extremly similar to what I saw in Fastino. I would wager the same Kasli SMPS noise spurs couple into the Zotino outputs.

dhslichter, 2020-07-13:
@gkasprow is there a plan for making changes to the Kasli SMPS design to reduce this noise, as per some of the recommendations above?

gkasprow, 2020-07-16:
Yes, it is on the todo list. It looks like the noise is injected into the input of the SMPS and then distributed via 12V rail.
The EMI filter present on Kasli does the job by isolating the DC inlet from the SMPS, but not the slave modules.
Once the noise is injected to the 12V rail, it is very difficult to remove it because it is coupled with GND via capacitors, also on the slave modules. The easiest way to mitigate the issue is addition of the PI type LC filter at the SMPS input.

hartytp, 2020-07-16:
> The easiest way to mitigate the issue is addition of the PI type LC filter at the SMPS input.

I agree with that. Wasn't sure if there is any point looking again at the layout as well? (e.g. the kind of ground cuts that you have for the +-12V SMPS module we use on the EEMs).

> The EMI filter present on Kasli does the job by isolating the DC inlet from the SMPS, but not the slave modules

I don't think that's the whole story. In many configurations we were able to suppress this noise by adding an additional CMC on the 12V line between Kasli and the 12V supply. That suggests that the EMI filter doesn't fully prevent the 12V noise form coupling onto the supply. However, I agree that adding an extra LC filter by the SMPS is likely a better solution than altering the EMI filter.

gkasprow, 2020-07-16:
Unfortunately, there is no easy way of checking this with existing HW because there is no simple way of cutting the 12V rail at the SMPS input. P12V0 is directly connected with both EEMs and SMPS.
I’d add 4.7uH inductor + ceramic caps + tantalum caps to damp oscillations.
Of course, the EMI filter has limited attenuation capabilities. Once you inject SMPS noise to the GND, it will stay there forever. So we must do our best to not propagate it to the input.

hartytp, 2020-07-16:
That sounds like a good solution to me!

marmeladapk, 2020-09-02:
Is this still an issue that requires fixing?

From what I've gathered you want to:
- add 4.7uH inductor + ceramic caps + tantalum caps on ADP5052 P12V0 input as close to the chip as possible
- add 2.2 uF (X5R) capacitors on both sides of FL*

I can easily do the latter, but the LC filter will require a sizeable effort due to the fact that P12V0 can come from either side of the board and there's not much space there. This will also require current density simulations on P12V0 with EEMs drawing current.

pathfinder49, 2020-09-02:
My reasons for this fixing would be:
*  Kasli injects SMPS noise into the building mains wiring. We should make sure Kasli is EMI regulation compliant. From my observations, mains EMI should be particularly bad when Kasli is connected to a euro-card that drives a grounded load.
IIRC, this configuration creates an AC ground loop between Kasli and building ground. This ground loop carries SMPS spur currents. The proposed measures break this AC ground loop. Even if Kasli is regulation compliant, it is worth avoiding the mains EMI. There is EMI sensitive research in the vicinity of Kaslis.
*  The SMPS noise forces (all?) EEM modules to use specific grounding configurations. If these are not followed, the SMPS spurs are transmitted to connected loads. This is demonstrated in [this Fastino spur analysis](https://github.com/sinara-hw/Fastino/issues/56). Similar spurs have also [been shown in Zotino](https://github.com/sinara-hw/Zotino/issues/21#issuecomment-380472116)).

The measurements presented in https://github.com/sinara-hw/Fastino/issues/56 demonstrate why both fixes are important.

dhslichter, 2020-09-02:
From my view, fixing the SMPS noise on Kasli is a very high priority, and we should be willing to tolerate substantial redesign/simulation pain to get it right.  If it's not right, it can potentially make the hardware useless for high-sensitivity applications.  I think adding inductors (and/or ferrites to provide some more damping?) probably has to be part of the solution.

hartytp, 2020-09-02:
@marmeladapk yes, this is still something we should fix.

> add 4.7uH inductor + ceramic caps + tantalum caps on ADP5052 P12V0 input as close to the chip as possible

Adding an LC filter to the SMPS power input should fix the issue.

We did also discuss changes to the layout as well (e.g. slots in the ground plane), but IIRC @gkasprow suggested that we don't do this.

> the LC filter will require a sizeable effort due to the fact that P12V0 can come from either side of the board and there's not much space there. This will also require current density simulations on P12V0 with EEMs drawing current.

I don't currently why the power entry from two pairs of input filters affect this (not implying it doesn't)?

The best solution might be to just scrap the rear power entry so that we can generally improve the 12V routing/PI.

>add 2.2 uF (X5R) capacitors on both sides of FL*

This isn't a great solution IMHO. Better to stop noise from the SMPS getting onto the main 12V power plane than to just beef up the input CMC. IIRC (but @pathfinder49 do correct me if I'm wrong) adding bigger capacitors doesn't really help much on its own, but it does help if an additional CMC is added to the 12V input.

My gut feeling is that if we add the LC filter then these capacitors won't be necessary. If there is space on the PCB then it might be worth adding DNP pads so we can easily add capacitors if they do turn out to be useful.

hartytp, 2020-09-02:
@dhslichter ferrites won't help with the spurs we reported since all the noise we observed was hundreds of kHz. I don't currently have any data to suggest that the SMPSs are generating noise at ~100MHz where a ferrite would be particularly effective.

It's also worth noting the perhaps obvious point that with any level of power filtering one can still find quite large spurs due to grounding, cabling, etc. I also would recommend keeping low noise cards a few HP away from Kasli to minimize radiative coupling.

dhslichter, 2020-09-02:
> I don't currently have any data to suggest that the SMPSs are generating noise at ~100MHz where a ferrite would be particularly effective.

So basically you are saying that there is limited harmonic content in the noise you are seeing?  Sometimes SMPS put out sharp "spikes" with ~MHz periodicity but frequency content that goes much higher because of their sharpness.

hartytp, 2020-09-02:
>So basically you are saying that there is limited harmonic content in the noise you are seeing? Sometimes SMPS put out sharp "spikes" with ~MHz periodicity but frequency content that goes much higher because of their sharpness.

I don't have evidence of fast spikes. Partially because we're looking at Fastino so (depending on how they couple in) they would be attenuated by the filters, and partially because we didn't stick our analyzer there for the higher frequency measurements. Also, the CMC already on Kasli should do a better job of attenuating the HF stuff, but more characterization would would be needed to make claims about it.

Either way, the LC filter should give us good coverage over a wide frequency range.

marmeladapk, 2020-09-04:
@hartytp Did you check this on Kasli v1.1 or 2.0?

If on 2.0, did you see 2.5 MHz buck in noise? (IC7 in ClockRecovery.SchDoc).

hartytp, 2020-09-04:
only on v1.1. @pathfinder49 can give you more details than me, but on V1.1 we only saw evidence of that one SMPS...

marmeladapk, 2020-09-04:
@hartytp Please check if these changes are what you and @pathfinder49 had in mind.

hartytp, 2020-09-04:
Thanks!

@pathfinder49 @gkasprow can you review?

Closed 2020-09-23.

Thread 67 (2020-03-04):

Switch fan header to one with key

marmeladapk, 2020-03-04:
(Fan connector does have a key)

jordens, 2020-09-04:
Also we should check whether the circuit works. If it's the same as on phaser I couldn't get it to work. I'll dig out the issue over there if I remember.

dnadlinger, 2020-09-04:
https://github.com/sinara-hw/Phaser/issues/107

marmeladapk, 2020-09-04:
In our tests at CTI we can lower the fan speed.

pt., 4 wrz 2020, 20:14 użytkownik Robert Jördens <notifications@github.com>
napisał:

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

jordens, 2020-09-04:
Ah. Lower significantly towards off? What were the pwm parameters?

Thread 68 (2020-03-04):

use solid ARTIQ logo

sbourdeauducq, 2020-03-04:
The logo should be solid and not an outline.
Incorrect:
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

Correct:
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

sbourdeauducq, 2020-03-04:
Another minor nitpick, the dot on top of the i in Kasli is missing.

marmeladapk, 2020-03-04:
ACK about solid logo. However dot above i is present in the design. I have no idea why it's gone. It's the same size as dots depicting first pin of ICs.

In Kasli v1.1 that we have here there's also no dot above i.

Thread 69 (2020-03-19):

SMA isolator

gkasprow, 2020-03-19:
I designed and 3D-printed new spacer that eliminates issue with longer SMA connectors
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

gkasprow, 2020-03-19:
We will do the same for Kasli and other boards.

gkasprow, 2020-03-19:
The print time is 3mins, print time of batch of 20 is 25mins

gkasprow, 2020-03-19:
The stl, PRUSA settings and source file:
[MECH.zip](https://github.com/sinara-hw/Kasli/files/4356828/MECH.zip)
use 0.15mm print setting

hartytp, 2020-03-19:
> The print time is 3mins, print time of batch of 20 is 25mins

How would you convert that into a commercial price (factoring in machine usage etc)?

gkasprow, 2020-03-19:
both CTI and TS have 3D printers and the price is negligible when printed in batches.
Anyway, I volunteer to print any quantity that is needed.

gkasprow, 2020-03-19:
One spool of material worth 50$ is sufficient to print thousands of such isolators.

hartytp, 2020-03-19:
Cool

marmeladapk, 2020-09-23:
Nothing to do here, closing.

Closed 2020-09-23.

Thread 70 (2020-03-21):

LT3045 output capacitors

hartytp, 2020-03-21:
cf https://github.com/sinara-hw/Urukul/issues/52

Currently we have 10uF capacitors which is the minimum required for stability. Despite the relatively low output voltages, this could lead to issues when voltage derating is taken into account.

@marmeladapk have any Kasli 2.0 shipped yet? If not, can we adjust this release prior to shipping any boards to put a capacitor with larger CV there (22uF 16V) to ensure stability?

Closed 2020-09-04.

Thread 71 (2020-04-09):

Don't isolate the rf shielding

jordens, 2020-04-09:
Having continuous electrical contact is the point of it.
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

akaminska, 2020-04-10:
What you see is the result of a slight overkill of a different problem. The problem is that the SMA connector pins protrude quite a bit from the PCB and should not, according to good practices, touch the panel. Unfortunately we could not find SMA connectors with shorter pins. One possible solution is to cut the pins close to the PCB manually, but we tried it and this process is quite "barbaric" and introduces a lot of stress on the PCB, introducing significant risk of damaging the module. The solution which was used here is Kapton foil insulation between the panel and the pins. Obviously, one could use it only on the part of the panel next to the pins. In the solution above the panel still has electrical contact with the PCB trough the screws and the brackets holding the panel, but I agee that we should introduce a better solution.

jordens, 2020-04-10:
It's not panel-to-PCB but pane-to-panel contact that's broken. That placement of the Kapton tape makes the RF shielded panel useless. I agree that cutting the SMA pins is a bad idea. I see the following options:

1. place sufficiently thick Kapton tape on the PCB and not on the panel lip as I've seen on other boards
2. place the SMA connectors 0.5 mm back if that works with the minimum thread length
3. longer SMA connectors and moving the SMA connector back
4. abandon the RF shielded panels

gkasprow, 2020-04-21:
5. make small cutouts in the RF shield and then secure one side of  it with Kapton tape.

Thread 72 (2020-04-09):

Revert to consistent panel font

jordens, 2020-04-09:
The font and style for both the previous foil panels and the rf shielded ones was ok. It wasn't perfect but it was consistent and very readable.
Please revert to consistent don't and style, logo size, font size, etc.

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

marmeladapk, 2020-04-10:
We'll update the panel to be consistent with our other boards.

jordens, 2020-10-07:
@marmeladapk will this one and #73, #74, #71 be addressed in production of the current release? Could you upload the panel design files?

Thread 73 (2020-04-09):

Sfp dust caps missing

jordens, 2020-04-09:
See photo in #72
They should have been added to the bom (#1).

marmeladapk, 2020-04-10:
They are in BoM and were ordered. I'm investigating what happened to them.

Closed 2022-02-21.

Thread 74 (2020-04-09):

SMA thread length insufficient

jordens, 2020-04-09:
Still only 4 mm thread remaining  with washer, nut, isolation sleeve and panel. Needs to be 5.5 mm AFAICT.
Needs fixing. Options have been suggested and discussed.

marmeladapk, 2020-04-10:
Isolators from GK ( https://github.com/sinara-hw/Kasli/issues/69 ) were used. You should be able to use SMA without the nut (and it should be stable).

jordens, 2020-04-10:
Yes. But that wasn't done. It's either missing information in the BOM or at the assembly line.

akaminska, 2020-04-10:
Both, actually. I already took care of the second and @marmeladapk can take care of the first for the next production run.

Thread 75 (2020-04-23):

SFP numbers on front panel and schematics are inconsistent

sbourdeauducq, 2020-04-23:
Front panel:
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

But schematics says e.g. SFP0 is left bottom:
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

marmeladapk, 2020-04-23:
Turn your Kasli 90 deg ccw ;) I'm pretty sure the markings are correct. In CERN symbol "left bottom" is consistent with manufacturer documentation.

sbourdeauducq, 2020-05-23:
OK.

Closed 2020-05-23.

Thread 76 (2020-05-23):

Kasli 2.0 premature fan failure

sbourdeauducq, 2020-05-23:
After a few weeks of being continuously powered on, the fan (model pictured) on my Kasli 2.0 no longer spins smoothly, and makes a lot of noise and vibrations.

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

gkasprow, 2020-05-23:
The same happened to the fan on my Xilinx devkit. Isn't it the same company who does them ?

sbourdeauducq, 2020-12-31:
Replacement part seems to be OK, even though it is the same P/N and manufacturer.

gkasprow, 2021-01-07:
Maybe it's worth adding the same circuit we use in Thermostat that enables speed control and RPM readout. If we don't need to spin the fan 100% it will significantly prolong its lifetime.

Closed 2020-12-31.

Thread 77 (2020-06-24):

Direct IO

gkasprow, 2020-06-24:
The discussion about Kasli IO connector started [here](https://github.com/sinara-hw/DIO_BNC/issues/11)

>    We can add some uFL or MMCX connector + passive protection or buffer to the next Kasli revision. There are still 8 free IO pins. Then a low-cost SMA-UFL pigtail would do the job.

>    If we're going to discuss this then we should discuss on Kasli not here
    I'd still prefer to reserve a couple of IO for future use. If we are going to break them out then a header seems to be a better way than an uFL/MMCX. It's still dirt cheap to use a ribbon cable to route to a tiny PCB that mates with the FP

True, a single 2mm 10pin IDC header would be better. We can always make a simple board with a level translator and SMA and attach it to the front panel. We have a place for it close to the 1V8 converter.
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

gkasprow, 2020-09-10:
it seems that after adding the SMPS LC filter we don't have the space for the connector. Moreover, the free IO pins are placed on the other side of FPGA so routing them would be tricky without adding more layers.

hartytp, 2020-09-10:
I'd definitely vote not to have this connector if it means more layers.

Is there another location we can fit it in? Otherwise, better to scrap it IMHO. People can always use the IO on an EEM for all the purposes this header was planning to serve (we now have 12 EEMs on Kasli).

marmeladapk, 2020-09-10:
@hartytp If you need some random IO there are 4 testpoints with 2,54mm pitch which are connected directly to the FPGA. Would that be enough?

gkasprow, 2020-09-10:
@marmeladapk can you add to these test points also 2V5/3V3 test points,  spaced by 2.54mm? Make sure the test point holes are large enough (at least 0.9mm) to fit the standard gold pin header. Place them in such way that reversed assembly won't make any harm to FPGA.
In this way, one can insert a single row IDC plug and connect it to the tiny PCB with translator and connectors, attached the front panel.
3V3 in / 3V3 out DC/DC converters are easily [available](https://pl.mouser.com/Power/DC-DC-Converters/Isolated-DC-DC-Converters/_/N-brwkv?P=1z0wb29Z1yxt7f5), so when needed, isolated IO would be feasible
This would solve this issue.

gkasprow, 2020-09-10:
It would be nice to rotate the pads placement by 90deg so the plug won't collide with IDC tapes;

hartytp, 2020-09-11:
> @hartytp If you need some random IO there are 4 testpoints with 2,54mm pitch which are connected directly to the FPGA. Would that be enough?

I'm not pushing for this (IMHO there is plenty of IO already broken out from Kasli to the EEM connectors so I don't see the need for another random connector). But, yes, that sounds sensible to me.

marmeladapk, 2020-09-11:
@gkasprow I can add P2V5 (these pins are P2V5 so it would give a reference voltage). I can rotate it only when pads are in 2x3 configuration, theres too little space there.

In this configuration if you rotate connector then you short P2V5 with GND is that what you had in mind?

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

gkasprow, 2020-09-16:
@marmeladapk yes, reversing supply won't harm the FPGA. Add 3V3 pad as well.
Or, maybe it's better to add a keyed 1.27 connector like this. We can keep it as DNP.
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

it won't interfere with ribbon tapes

marmeladapk, 2020-09-22:
I don't think that adding another type of connector is a correct choice. I'll leave it as it is. It seems at least one user is satisfied with this solution and the rest had ~2 weeks to chime in.

gkasprow, 2020-09-22:
@marmeladapk did you add 3V3 pad?

marmeladapk, 2020-09-22:
@gkasprow No.

gkasprow, 2020-09-22:
please add so one can supply the driver capable of driving TTL logic.

Closed 2020-09-22.

Thread 78 (2020-06-30):

I2C SDA 0.8V when pulled low by Si5324

hartytp, 2020-06-30:
https://chat.m-labs.hk/m-labs/pl/9anbfbwbw3yr8j7xctdsx6isxr

hartytp, 2020-06-30:
@gkasprow @marmeladapk any ideas?

hartytp, 2020-06-30:
(This currently seems to stop some boards booting with ARTIQ).

hartytp, 2020-06-30:
Si5324 specifies a max of 0.4V at 3V3 (3mA)

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

hartytp, 2020-07-01:
@gkasprow any thoughts about this? I can send you a board showing these symptoms if that will help you debug?

marmeladapk, 2020-07-02:
@hartytp I'll take a look at it next week.

hartytp, 2020-07-02:
Thanks @marmeladapk !

I have one more Kasli v2.0 at the moment. It also displays this issue. Do you need me to post it to you, or do you have other v2.0 with this problem?

It's possible that there has been some hardware damage to the two boards I have, but it seems unlikely since they both displayed this straight out of the box and I've never seen it before...

marmeladapk, 2020-07-02:
I'll first check our Kaslis, I suspect that they may have the similar
problem, just not as bad.
W dniu czw, 2 lip 2020 o 11∶51 użytkownik hartytp
<notifications@github.com> napisał:
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

dnadlinger, 2020-07-02:
> I have one more Kasli v2.0 at the moment.

sb0 now has two of our boards, so I'm not sure how many we have left. (Thinking about it, perhaps you meant to ship only one – apologies.)

gkasprow, 2020-07-02:
@hartytp It looks like the pullup current is 6mA or more.
If you enable all I2C ports, the pullup currents add up.
With 16x10k we get 3.3/625R=5.3mA
We also have 2k2 which adds another 1.5mA.
So, it looks like all I2C ports are enabled which do not make much sense because I2C addresses overlap.

DonaldKellett, 2020-07-03:
Following https://github.com/m-labs/artiq/pull/1480 , the voltage at the SDA pin in the shared I<sup>2</sup>C bus remains at 0.85V, which causes an "Si5324 failed to ack register" error following a command to write to address `0x68`. Please find attached a sigrok trace demonstrating this issue.
[trace.txt](https://github.com/sinara-hw/Kasli/files/4868725/trace.txt)

gkasprow, 2020-07-03:
@DonaldKellett are you sure that multiple ports are NOT enabled on the I2C switches?

hartytp, 2020-07-03:
@gkasprow how would that cause this? The only pull-up connected to shared SDA is R189 isn't it?

hartytp, 2020-07-03:
Never mind, turns out I didn't remotely understand how the I2C switches work...

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

I take your point: if you enable lots of channels at once then you get a much stronger pull-up, which would completely explain why this happens (and why it didn't happen with the CTI tests)...

gkasprow, 2020-07-03:
@hartytp there are two types of I2C switches. The ones that let you choose 1 of n outputs (I2C multiplexer). You simply enter the output number to the register and that's done. The ones we use are in fact I2C switches, not muxes.

gkasprow, 2020-07-03:
to avoid such issues in the future, we can increase the pullups at the outputs of switches let's say 10-fold.

sbourdeauducq, 2020-07-04:
@gkasprow As you can see from the I2C logic analyzer trace (open it with sigrok), just before the Si5324 failure, the firmware writes the 0x00 0x08 control bytes to the two respective switches (note that the LA registers the 0.8V as 0). This is supposed to select only one channel - correct? In https://github.com/m-labs/artiq/pull/1480 we tried repeating the control byte, but no effect.

hartytp, 2020-07-04:
@gkasprow if your hypothesis is that the switch is selecting multiple channels at once, can we quickly test that by just shorting a few of the other outputs to ground and seeing if that affects the output? If it doesn’t then that can’t be the issue...

gkasprow, 2020-07-05:
the question is what is the state of the registers before the firmware writes the 0x00 and 0x08...

DonaldKellett, 2020-07-06:
I've just looked into the I2C_SW test points on my Kasli 2.0 board and the voltage readings of the pins are as follows:

- SDA: approx. 1.15V
- SCL: approx. 2.45V

Please find attached the sigrok [trace](https://github.com/sinara-hw/Kasli/files/4876486/trace.txt) and [annotations](https://github.com/sinara-hw/Kasli/files/4876488/annotations.txt) for these test points. As far as I can tell, this trace is more or less the same than the previous one, but I managed to get some interesting annotations from PulseView by selecting "24xx EEPROM" as the stack decoder on top of the I2C decoder.

To reproduce the trace, connect D0, D1 and GND of the logic analyzer to SDA, SCL (in I2C_SW) and GND of the Kasli 2.0 board respectively.

gkasprow, 2020-07-06:
@DonaldKellett this still does not respond to the question I asked. Please check if the other ports are not enabled! Just probe the switch outputs while trying to talk to the Silabs chip.

DonaldKellett, 2020-07-07:
I looked into this again, and, from my understanding of the above discussion, I would need to probe the outputs of the SCx/SDx pins on my board to determine whether more than one of them are active at any given time. So, a quick look at the Kasli schematics indicates that these pins are located on IC14, which is a tiny IC at the back of my board and therefore difficult to solder wires directly on it. I then tried looking at the PCB layout on page 20 of the Kasli schematics to look for appropriate soldering points away from the IC but the PDF does not display the PCB layout very well and I couldn't open the PCB_Kasli.PCBDOC file online in the [Altium 365 viewer](https://www.altium.com/viewer/).

@gkasprow do you happen to know what is the best place to solder on another port on this pcb?

marmeladapk, 2020-07-07:
@DonaldKellett You could probe I2C signals on EEM connectors.

marmeladapk, 2020-07-08:
I probed Kasli v2.0 and compared it with v1.1. Measurments:

v2.0, measured on shared bus (so closest to Si5324):
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

Low level from Si5324 during reads is around 830 mV (I measured it with scope).

---------

v2.0, measured on 3V3_SW bus (between switches and voltage translator):
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

Low level from Si5324 during reads is around 1.1 V.

---------

v2.0, measured on FPGA I2C bus (between FPGA and voltage translator):
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

Low level from Si5324 during reads is around 1.1 V.

---------

v1.1, measured on Si5324 bus:
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

Low level from Si5324 during reads is around 0 V.

----------

v1.1, measured on 3V3_SW bus (between switches and voltage translator):
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

Low level from Si5324 during reads is around 530 mV.

----------

v1.1, measured on FPGA I2C bus (between FPGA and voltage translator):
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

Low level from Si5324 during reads is around 0 V.

| Place | Si5324 bus | Between switches and v. translator | FPGA bus |
|---|---|---|---|
| v2.0 | 830 mV | 1.1 V | 1.1 V |
| v1.1 | 0 V | 530 mV | 0 V |

Artix datasheet specifies low level voltage of 2V5 CMOS to be 0.7 V. So it's only a coincidence that it works on my boards.

Four things changed between v1.1 and v2.0:
1. voltage translator was changed from bus repeater with voltage translation (TCA9517) to voltage translator (PCA9306)
2. pullup resistors on FPGA bus and Si5324 bus were changed from 2k2 to 10k
3. Si5324 now shares bus with 2 GPIO extenders and SFP3
4. Si5324 doesn't have TCA9517 bus repeater on its bus now

See #46 for rationale of those changes.

Initial 830 mV level surprised me. I know that switches are set only to enable only this bus. So Si5324 has to drive 10k || 2k2 || 10k || 10k to ground which is around 1k3. However in v1.0 it had to drive 2k2 || 2k2 to ground which is a slightly stronger pullup. Either way 3 mA sink should be enough.

In v1.1 Si5324 was "shielded" from rest of the I2C by a repeater. To check if 4. changes anything I'll measure v1.0 later this week, but AFAIR there were no issues with Si5324 there.

Sharing bus with other devices probably doesn't matter. After measuring v1.0 I'll check if changing resistors between switches and v. translator from 2k2 to 10k will help.

jordens, 2020-07-08:
Argh.

hartytp, 2020-07-08:
@marmeladapk One thing I don't understand from your measurements is that it looks like there is a 270mV voltage drop across the TCA9548ARGER (830mV low-level on `SHARED_SDA` and 1V1 on `I2C_3V3_SW_SDA`). The max reistance is specified as being 30Ohm (see below). Unless I'm missing something, that would suggest there is 9mA flowing through it, which would suggest that the pull-up is really only a couple of hundred ohms, wouldn't it, or am I misunderstanding things?

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

jordens, 2020-07-08:
And the other strange thing is that the FPGA drives below 0.1 V on v1.1 but only to about 0.3 V on v2.0.

marmeladapk, 2020-07-08:
v1.0, Si5324 bus:
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

----

v1.0, between switches and repeater:
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

----

v1.0, FPGA bus:

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

So it seems that lack of repeater (4.) directly before Si5324 is not a problem. Perhaps having two PCA9306 translating voltage to the same bus is problematic? (USB)

I'll continue on Friday.

gkasprow, 2020-07-08:
@marmeladapk did you check if the switches have multiple outputs enabled?

hartytp, 2020-07-09:
> @marmeladapk did you check if the switches have multiple outputs enabled?

@gkasprow I don't think that can be the issue here (although, I agree it's worth sanity checking).

Among other things, my calculation above suggests that 9mA must be flowing through the I2C switch (and, that's based on worst-case assumptions about switch resistance). With 10k pull-ups, that would require 27 channels, which is more than we have....

gkasprow, 2020-07-09:
This could be assembly error - somebody assembled resistors that are 10 or 100x lower value.

hartytp, 2020-07-09:
Also worth checking. Otherwise, I agree with @marmeladapk that the PCA9306 is the obvious next thing to investigate.

gkasprow, 2020-07-09:
PCA9306 adds pure  series resistance to the chain. It's FET based level translator, not re-driver.

hartytp, 2020-07-09:
To satisfy my curiosity, do you have a rough equivalent circuit for how it works?

gkasprow, 2020-07-09:
It's just a FET with its gate connected to EN pin and substrate connected to GND. The resistance depends on the supply voltage. So, it does not regenerate the signal. It only passes the logic low level and clips the logic high level to the lower supply potential.

sbourdeauducq, 2020-07-10:
Not sure if this is related to the original problem, but @hartytp's board that @DonaldKellett was using has developed what looks like a hardware failure with I2C_SW SCL and SDA now permanently stuck low.

hartytp, 2020-07-10:
Is that just on the FPGA side (i.e. failure of IC13), or is I2C_3V3_SW stuck low as well?

jordens, 2020-07-10:
Elaborating on https://github.com/sinara-hw/Kasli/issues/78#issuecomment-655572273, the > 300 mV when the FPGA is driving low (see "v2.0, measured on FPGA I2C bus (between FPGA and voltage translator):") mean that it's sinking more than 18 mA (12 mA slow drive from IBIS).

hartytp, 2020-07-10:
It's somewhat hard to see where all that current could be coming from. Broken level translator? FTDI chip?

marmeladapk, 2020-07-10:
Ok, I found the culprit. As I thought, USB I2C bus is the problem. FTDI seems to drive all its pins actively high after reset. This means that SDA SCL **and** enable pin of voltage translator (which has pulldown) are driven high. Since it's driven actively it sources current when other devices try to drive the bus low. It wasn't a problem before because previously we used active repeater which didn't have a direct connection to shared bus.

Shared bus has 0.7 V when USB is plugged in and power is disabled.

> The  4  channels  of  the  FT4232H  reset  to  4  asynchronous  serial  UART  interfaces.

Solutions for now:
- disconnect USB cable - FTDI won't be powered and won't drive line high (quickest, though least satisfactory)
- program FTDI to keep these pins low
- remove IC22
- possibly programming EEPROM with "Pull down I/O Pins in USB Suspend" could help but I will have to check if it's reliable (it could work only when nothing is connected to serial terminal)

Long-term solutions:
- Insert inverter on enable pin, so that by default IC22 is disabled (preferred by me)
- Change PCA9306 on this bus back to TCA

hartytp, 2020-07-10:
> Insert inverter on enable pin, so that by default IC22 is disabled (preferred by me)

I don't have the layout in front of me, but is that something we can easily hack into the existing boards with a scalpel and some glue?

jordens, 2020-07-10:
We're already programming the FTDI EEPROM. I bet there is an option to solve this properly.
https://github.com/quartiq/kasli-i2c/blob/master/kasli-ft4232h.conf.in
Try adding `suspend_pull_downs=true`.

jordens, 2020-07-10:
> I don't have the layout in front of me, but is that something we can easily hack into the existing boards with a scalpel and some glue?

Why not just look into programming the EEPROM properly?

hartytp, 2020-07-10:
> Why not just look into programming the EEPROM properly?

If that works reliably then it's fine by me.

marmeladapk, 2020-07-10:
@jordens It may not work if you're connected to the terminal (so FTDI is not USB is not in suspend mode).

sbourdeauducq, 2020-07-10:
I still think the enable pin should be inverted in v2.1 to make the hardware friendlier.

jordens, 2020-07-10:
> @jordens It may not work if you're connected to the terminal (so FTDI is not USB is not in suspend mode).

I meant look for the actual option that sets the state of the FTDI interfaces that are not being used. Note that the four ports are four different and independent USB interfaces. Connecting to one doesn't mean much for the others.

hartytp, 2020-07-10:
@jordens I hadn't seen https://github.com/quartiq/kasli-i2c/blob/master/kasli-ft4232h.conf.in before (I've been using ftprog). That's a nice util.

jordens, 2020-07-10:
> If that works reliably then it's fine by me.

I can't see how properly setting up the EEPROM could be nearly as unreliable as "a scalpel and some glue".

jordens, 2020-07-10:
> I still think the enable pin should be inverted in v2.1 to make the hardware friendlier.

Because of the implied incompatibility this is a bad and shortsighted idea.
Why not just configure it properly?

sbourdeauducq, 2020-07-10:
Removing IC22 is easier than programming FTDI chips, especially since FTDI chips are prone to all sort of bugs.

sbourdeauducq, 2020-07-10:
>  Why not just configure it properly?

Why not just make hardware that is well-behaved by default, especially since the contention may cause permanent damage?

sbourdeauducq, 2020-07-10:
Can't the incompatibility issue be resolved with ~3 lines of code that look at the hardware version and invert the pin?

hartytp, 2020-07-10:
> Removing IC22 is easier than programming FTDI chips

Removing I2C would break all the USB I2C tooling which would be a big regression IMHO

hartytp, 2020-07-10:
Another option is to just add a couple of current limiting resistors between the FTDI chip and IC22. That way we're guaranteed that programming errors can't cause hardware damage (which feels like something we should aim for) at close to 0 extra cost/complexity...

marmeladapk, 2020-07-10:
@jordens

`suspend_pull_downs` doesn't help regardless if console is opened.

> The EEPROM contents have no effect on the selected mode with the exception of selecting the TXDEN for RS485 mode when asynchronous serial interface has been selected in software. If the device is reset, then the 4 channels must be reconfigured into the required mode.

So programming FTDI cannot fix it by default unless there are other options to set in EEPROM (there aren't to my knowledge).

> I don't have the layout in front of me, but is that something we can easily hack into the existing boards with a scalpel and some glue?

@hartytp It's possible but not easy. If you want to add inverter know, easier fix would be to lift 8th pin of IC22 (EN pin) and add inverter (transistor) on top of it + some wires to pulldown resistor nearby.

> I still think the enable pin should be inverted in v2.1 to make the hardware friendlier.

I'm also for it. It will be a proper fix (and currently seems the only possible permanent one).

marmeladapk, 2020-07-10:
> Not sure if this is related to the original problem, but @hartytp's board that @DonaldKellett was using has developed what looks like a hardware failure with I2C_SW SCL and SDA now permanently stuck low.

@sbourdeauducq This looks like a hardware failure. Probably ESD. Let's hope that it's the voltage translator that's fried, not FPGA inputs.

jordens, 2020-07-10:
Yes. There is no EEPROM fix. I went through the entire thing, including the not-yet exposed bits of `libftdi`. That pin is DTR and is an active low output. My proposal ist the following:

* Disconnect BDBUS4, pin 26 from its via
* Connect the via to BDBUS6, pin 28

DCD is an input with a weak enough pull-up. This is forwards and backwards compatible, doesn't need new hardware, and no version detection and special treatment in software.

hartytp, 2020-07-10:
Any objections to pushing out a v2.1 release with minor fixes soon?

jordens, 2020-07-10:
That seems much to early given that a lot of the board hasn't really been tested thoroughly yet. Little data/solutions on the fan, wr clock recovery, 4 sfp, smps noise, panel mechanics, just to name a few.

marmeladapk, 2020-07-14:
I'll check @jordens proposal the next time I'll be in our lab.

@jordens would you have a moment to check if I2C from FTDI works as expected? Or maybe you have already checked it? (even without the fix for current problem)

jordens, 2020-07-14:
If you fix the fundamentally broken ARTIQ I2C implementation it works fine. Don't ever actively drive SCL/SDA high (unless you want to do some risky high speed tricks), especially not in a multi-master topology. That may also be the root of a lot of other problems (including what prompted #46 and the issues with Banker and Fastino I2C).
Unfortunately the switch reset polarity is now switched which requires a special treatment.

jordens, 2020-07-14:
https://github.com/m-labs/artiq/pull/1484

marmeladapk, 2020-07-24:
I checked that @jordens' solution works fine (though I didn't cut the trace yet, I made a non-permanent fix).

ARTIQ implementation and @jordens' bitbang kasli-i2c work fine. However pyftdi in MPSSE mode has problems. I checked that I can talk to other devices but muxes don't seem to react to changes in their registers.

- I can talk to Si5324 (readback of chip id) when mux is switched (and left) by ARTIQ or kasli-i2c on boot and I get correct values.
- I can talk to muxes, write to them and read back values I wrote.
- When I reset the mux and set it again I can't talk to Si5324 and there's no signal on shared bus. Even if I enable all ports on both muxes, nothing happens on any bus.

I've seen this behaviour before and it was caused my simultaneous changes of SDA and SCL (I2C from misoc). Now it doesn't seem to be the case but I'm not sure if it's worth dwelling on this further since pyftdi in MPSSE mode has terrible timings and weird voltage levels.

sbourdeauducq, 2020-07-25:
The I2C proxy bitstream route avoids all these problems at once.

jordens, 2020-07-26:
The i2c mpsse didn't seem worth using. I added it to compare with bitbanging and it wasn't faster in the typical use cases. I wouldn't be surprised if pyftdi doesn't implenent i2c-mpsse correctly (iirc it's not a function of the mpsse but a use case).

pathfinder49, 2021-02-22:
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

I've got an unpatched kasli 2.0.0. Is this the agreed way to fix this on existing boards? Is the software part of the fix included in artiq?

Closed 2020-09-04.

Thread 79 (2020-07-10):

v2.1

hartytp, 2020-07-10:
From https://github.com/sinara-hw/Kasli/issues/78#issuecomment-656806685...

> That seems much to early given that a lot of the board hasn't really been tested thoroughly yet. Little data/solutions on the fan, wr clock recovery, 4 sfp, smps noise, panel mechanics, just to name a few.

Fair enough, but I'd like to move to a new revision soon as this is going to be annoying to patch on v2.0 boards.

>  Little data/solutions on the fan

What data are you looking for here? Do we even have enough v2.0 boards produced to get statistics on that?

Am I right in thinking that there are other fan parts that are mechanically compatible, so we can easily change the fan part as just a BOM change? If so, it's not clear to me that this issue should be a release blocker.

> wr clock recovery

@sbourdeauducq what's your eta for having another look at this?

> 4 sfp

@marmeladapk I assume you did test these post-production? @sbourdeauducq did you check that you could get links on all 4 SFPs? What other testing is needed here?

>  smps noise

What testing do you want to see here? We should have a bit more discussion about options on https://github.com/sinara-hw/Kasli/issues/66. AFAICT all we're talking about would be adding an inductor on the SMPS input to limit noise currents on the main PSU input. It's not easy to prototype that on the current hardware because signals are routed on internal layers. My preference would be to build some prototype boards with the inductors fitted, test those then make a decision. I don't see a good way of doing that with existing hw...

> panel mechanics

Anything beyond
- https://github.com/sinara-hw/Kasli/issues/72
- https://github.com/sinara-hw/Kasli/issues/69
- https://github.com/sinara-hw/Kasli/issues/71
- https://github.com/sinara-hw/Kasli/issues/74

Does this need testing?

>, just to name a few.

What else?

sbourdeauducq, 2020-07-11:
> @sbourdeauducq did you check that you could get links on all 4 SFPs?

Yes.

sbourdeauducq, 2020-07-11:
> > wr clock recovery
>
> @sbourdeauducq what's your eta for having another look at this?

Haven't found hardware problems so far. The problem with ADPLL not being written by the gateware is due to the gateware outputting garbage on the I2C lines, as seen with a logic analyzer.

hartytp, 2020-07-11:
> Haven't found hardware problems so far. The problem with ADPLL not being written by the gateware is due to the gateware outputting garbage on the I2C lines, as seen with a logic analyzer.

Aah, cool! Glad to hear you're making progress on this.

hartytp, 2020-07-11:
@marmeladapk what's your schedule like these days? Do you think you could look at some of the open issues and start to think about resolving them?

I'd really like to get a usable board in the 2.x family relatively soon

marmeladapk, 2020-07-14:
> The problem with ADPLL not being written by the gateware is due to the gateware outputting garbage on the I2C lines, as seen with a logic analyzer.

@sbourdeauducq Some time ago I fixed misoc I2C core during unrelated debugging session. I made version both for CSRs and for wishbone. The code is not polished but it worked. I can send you a diff if you want (and still need it).

> what's your schedule like these days? Do you think you could look at some of the open issues and start to think about resolving them?
> I'd really like to get a usable board in the 2.x family relatively soon

My schedule right now is pretty packed so not really. I could do #78 and #67 but I don't think it warrants an entire production run.

sbourdeauducq, 2020-08-19:
This is fixed now (was just a 1-line change), but thanks.

hartytp, 2020-09-22:
@marmeladapk where are we on the various open issues?

hartytp, 2020-09-23:
All remaining issues are BOM/mechanical changes only, so the plan is to freeze the schematic here so we can move to production.

Thanks for all the work on this @marmeladapk @gkasprow

dtcallcock, 2020-09-23:
Is this the big production run that everyone will buy and use in their lab or is another round of prototype testing needed?

hartytp, 2020-09-23:
With the caveat that the WR oscillators still haven't been fully tested yet, I believe that this release fixes all known issues. So unless/until new issues turn up this is it.

Kasli is now a pretty well-tested design and there haven't been major changes since v1.0 -- just small improvements here and there -- so I wouldn't personally hold back from ordering

dhslichter, 2020-09-28:
unless you want that Zynq Kasli 😁

Closed 2020-09-23.

Thread 81 (2020-09-02):

Rear power entry

hartytp, 2020-09-02:
Do we still want to support power entry at both the rear and front of Kasli? It makes the routing quite a bit harder and I'm not aware of anyone actually using it.

What about keeping the molex connector, but moving it to near the front panel. That way one can get power in from the rear if required (just run a cable from the rear to the front of the PCB, it's a little ugly but no worse than the clock routing) but we don't need two sets of line filters and can simplify the layout.

Any objections @marmeladapk @sbourdeauducq @jordens @cjbe ?

jordens, 2020-09-02:
Ack. Straight molex, e.g. where that ftdi gpio header is.

hartytp, 2020-09-02:
Cool. Unless we hear any objections, let's do that.

marmeladapk, 2020-09-02:
It doesn't matter. 12V still needs to go to EEM connectors to the back so having a connector there doesn't change anything. The only thing that would make routing easier w.r.t filtering discussed in #66 is dropping front panel connector, not the back one.

I'd keep it as it is to avoid change for the sake of change. It's already there, if no one uses it I can DNP components.

Can I close this issue?

hartytp, 2020-09-02:
Aah, ok, I misunderstood your comment in the other issue. The FP connector is the only one we really have to keep, so let's keep the design as is.

Closed 2020-09-02.

Thread 82 (2020-09-18):

DC bias of CKIN_SMA on Kasli2

sbourdeauducq, 2020-09-18:
On Kasli 2.0, the CKIN_SMA pins do not have an external DC bias, which is required for the FPGA differential input buffer to work properly.
The IN_TERM=UNTUNED_SPLIT_50 feature of the FPGA cannot be used to create the bias, because it is not supported at VCCO=2.5V (it is also uncalibrated, and might not be good enough for impedance matching).

gkasprow, 2020-09-18:
We can still fix it in current revision. @marmeladapk

jordens, 2020-09-18:
That would be great.
How feasible is a rework on existing boards? Dc couple and bias the center tap?

gkasprow, 2020-09-18:
I've noticed that generally, FPGA work without bias due to embedded protection diodes that do some kind of DC recovery. However, it's enough to add a 2x10k resistor divider to any of the diff inputs

hartytp, 2020-09-18:
> How feasible is a rework on existing boards? Dc couple and bias the center tap?

Or just leave it AC coupled and use a few RCs to add a bias on the FPGA side of the coupling caps. It looks like there should be room to access the capacitor pads on the current layout.

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

marmeladapk, 2020-09-22:
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

I removed AC couple and added bias to center tap.

jordens, 2020-09-22:
Does the balun bypass work without a bias and ac-coupled on the `_p` signal? Can be scrapped IMO.

marmeladapk, 2020-09-22:
If you remove balun then you can solder 0R between 1st and 2nd pins giving _P signal DC bias.

hartytp, 2020-09-22:
> If you remove balun then you can solder 0R between 1st and 2nd pins giving _P signal DC bias. I'll add a note about that.

Which pads are you using for that?

sbourdeauducq, 2020-09-23:
I'm not sure if a single-ended signal is a good idea since we lose the comparator present in FPGA differential inputs, and a sine wave into a CMOS input buffer may be noisy.

sbourdeauducq, 2020-09-23:
> However, it's enough to add a 2x10k resistor divider to any of the diff inputs

What are easy soldering locations to do this?

marmeladapk, 2020-09-23:
I'd say the best one is under the FPGA. There are pads for termination resistor there:

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

sbourdeauducq, 2020-09-23:
@marmeladapk thank you

SingularitySurfer, 2020-10-01:
Hi, I did some further debugging because it still didn't work after the mod. In addition, the sl5324 needs to be configured for CKIN1 (currently it's still set to CKIN2 in artiq). But even with this change, the si5324 does not lock, even tho we verified there is a clocksignal at CKIN1 coming from the FPGA. Any ideas?

SingularitySurfer, 2020-10-06:
The LVDS seems to be happy without external bias with a 0dBm clock input signal.

sbourdeauducq, 2020-10-07:
Hmm. I would worry about noise or long-term effects... Are negative voltages/currents within FPGA ratings?

SingularitySurfer, 2020-10-07:
Kinda funny: With external bias to 1.25V (which is 50mV off the 1.2V LVDS center) it's fine until ~ -8dBm.
With no external bias until ~ -14dBm, however once it loses signal you have to go quite a bit higher before it works again.
And ofc. thats just a one off try and not according to spec.

hartytp, 2020-10-07:
> With no external bias until ~ -14dBm, however once it loses signal you have to go quite a bit higher before it works again.
And ofc. thats just a one off try and not according to spec.

Sounds like you're baising by rectifying the input clock through the FPGA ESD capacitors, hence the hysteresis

jordens, 2020-10-07:
Long term this is completely harmless (~50 nC per boot) and I don't see how the rectification (assuming you mean ESD *diodes*?) explains the hysteresis. As Greg days, it explains the self-biasing. I'd look at the si5324 and its lock/LOS hysteresis. The V,T stability of the self-biasing might be interesting though, but even that would be common mode.

Closed 2020-09-22.

Thread 83 (2020-10-06):

reference clock input balun ratio

SingularitySurfer, 2020-10-06:
Small correction in the schematic: The reference clock input balun has a 1:2 ratio (according to the BOM)
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

dtcallcock, 2020-10-29:
Would also be good to annotate schematic/wiki with min/max input levels.  Right now the schematic has neither and the wiki just says +10dBm max.

Thread 84 (2020-10-23):

Kasli v1.1 suddenly died

sotirova, 2020-10-23:
I had a Kasli v1.1 connected to a Phaser board that I was trying to test. After sitting unattended for a day it suddenly stopped working and none of the LEDs (apart from power) on the kasli light up when it is plugged in.

cjbe, 2020-10-23:
@sotirova can you list exactly which of the power LEDs come on? IIRC only 2 of the power LEDs lit up, the rest of the rails were dead, showing that quite a lot of the power network was misbehaving.

sotirova, 2020-10-23:
The power LEDs that light up when it is plugged in are 1V0 and 12V0.

gkasprow, 2020-10-23:
Did you try to disconnect the Phaser?

sotirova, 2020-10-23:
Yes, it is currently disconnected and only 1V0 and 12V0 light up when powered.

hartytp, 2020-10-23:
What are the voltages on the various rails?

marmeladapk, 2020-10-23:
I had a problem like this once. It's probable that something shorted P2V5 rail. Was Kasli cooled when it sat idly?

Could look with a scope on P2V5?

gkasprow, 2020-10-23:
I have a few Kaslis with broken 2V5 rail - shorted FPGA bank
This happens usually during hot-plug or when 3V3 appears on LVDS lines.
Are you sure nobody touched the setup?

sotirova, 2020-10-23:
Here are the voltages:

- P1V0: 1 V
- P1V2: 0.435 V
- P1V5: 1e-3 V
- P1V8: 9e-3 V
- P2V5: 16e-3 V
- P3V3: 0 V
- P12V0: 12.2 V

marmeladapk, 2021-01-18:
Could you check with multimeter in short detection mode if P3V3 and GND are shorted when board is unplugged? P3V3 is next in power sequence after P1V0.

Closed 2022-07-25.

Thread 85 (2020-11-06):

Missing panel design outputs for v2.0 +

HarryMakes, 2020-11-06:
I would like to obtain some outputs for the front panel design, e.g. in form of PDFs like [this one for v1.1](https://github.com/sinara-hw/Kasli/releases/download/v1.1.1/PANELS.PDF). It would be nice to include such outputs for version 2.0 or up on the releases.

gkasprow, 2020-11-06:
You can generate them from sources.

HarryMakes, 2020-11-09:
Hi Greg, thanks for the reply. Since I can't use a Windows OS at work, I tried opening the source files using [Altium's online viewer](https://www.altium.com/viewer/).

I'd guess the file containing the front panel design would be `PCB_Kasli.PCBDOC`, but with the online viewer I can only see the layout designs of the PCB but not the front panel. There's also a 3D view where I can see most parts of the PCB and components, but the front panel doesn't seem to be complete - it appears cut in half to be 4HP instead of 8HP wide. I took a screenshot as attached below:
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

May I get some advice on whether or not `PCB_Kasli.PCBDOC` is the right file that contains the front panel design? Thank you.

gkasprow, 2020-11-09:
Kasli was not designed by me. It was a Creotech job.

HarryMakes, 2020-11-10:
Thanks! I'll reach out to him and write some updates here later on.

Thread 86 (2020-11-09):

Question about Cu thickness of top/bottom layer

HarryMakes, 2020-11-09:
For Kasli 2.0.1, is it correct that each of the top and bottom layers uses 1.5oz copper in production?

If there's a manufacturing limitation that doesn't allow 1.5oz for the trace spacing and/or width, would 1oz copper be suitable as a replacement? Are there current or temperature constraints imposing on the thickness of the top/bottom layer Cu? Thanks!

gkasprow, 2020-11-09:
Kasli needs impedance controlled traces. To use other thickness you'd have to redesign the PCB

gkasprow, 2020-11-09:
Also, the current density/drop analysis was performed for a specific thickness. If you use a thinner one, the voltage drop will be higher which may cause issues with stability. It's quite advanced PCB, if you change something, you do it at your risk. The PCB was designed to be compatible with certain PCB material (substrates, prepreg) vendors. Generally, in the case of complex PCB, you cannot change the process without redesigning it.

gkasprow, 2020-11-09:
Moreover, this is basic thickness, the manufacturer adds usually plating. AFAIR it was designed for 56um total thickness.

HarryMakes, 2020-11-11:
Greg, thanks for the info. I've made a reminder that impedance control is applied to all kinds of traces for the board.

Without much PCB manufacturing experience, I would like to know whether or not the 56um total Cu thickness is a parameter that certain PCB standards can satisfy. If I produce the PCB by following IPC class 2 requirements, would the stackup shown in the current Gerber files need to be modified? For your quick reference here's the stackup on our Gerber files:
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

Moreover, I'm looking at some design guidelines made by NCAB ([link](https://www.ncabgroup.com/pcb-design-guidelines/)), and I wonder about to what extent our current Gerber files would comply with these guidelines, say if the Kasli PCB were to be manufactured by NCAB. Thanks!

gkasprow, 2020-11-11:
Just follow the Gerbers. if you modify the stackup, run signal integrity and power integrity simulations to confirm that it  still works.  I cannot say without simulations that it would be fine. I won't take responsibility for any isues that results from modifications.  Simulations take time and I see no reason to do them again. Wahy you cannot simply order boards from existing producers?

sbourdeauducq, 2020-11-11:
> Why you cannot simply order boards from existing producers?

Long lead times, and unpredictable coronavirus lockdowns.

So the information in the Gerber is correct? How was this stack-up decided, is it a standard/common NCAB one?

dtcallcock, 2020-11-11:
It sounds like you are suggesting that a large fraction of users should switch hardware suppliers and you want to facilitate that?   If so, I think that such a serious reconfiguration of how the Sinara collaboration works merits some kind of discussion amongst the many stakeholders.

dtcallcock, 2020-11-11:
...like, not here on an obscure closed thread.

dhslichter, 2020-11-11:
Changing a stackup for a board like Kasli is not something that should be undertaken lightly, or without a good purpose.  There is also no such thing as a "standard" stackup, lots of different vendors/groups use different default stackups for different reasons -- and sometimes they change these without warning.  For high performance boards like this, it's not the same as a little hobbyist 2-layer/4-layer for low frequency signals and small currents where these things don't matter as much.  All of the thicknesses (copper, FR-4) listed above are available as standard prepreg or core thicknesses and foil thicknesses, any board house should be able to make them if you specify what you want.

hartytp, 2020-11-11:
I don't want to get into this conversation in any way, but there is perhaps one thing I would say (without really knowing any context/anyone's plans): we've put a lot of time into solving assorted manufacturing issues over the past few years and I would expect that switching to any new supplier will introduce some fresh issues. If I were a user purchasing hardware from a supplier that had previously sold me TS/CTI boards but was now switching suppliers I would want to be explicitly warned about that  unless PI/SI had been run and significant post-production testing carried out. I'd be pissed if I hit unexpected subtle manufacturing issues that wasted my time.

gkasprow, 2020-11-11:
We spent endless hours at the WUT both with CTI and TS to make sure we understand each other and know their PCB , manufacturing process and component vendors. For example, boards are designed with automated spot THT soldering in mind. The mechanic designs take into account manufacturing capabilities - they were trimmed to use UV printer and specific laser/CNC machine. We modified some footprints to improve the production yield, but this was optimized for particular production line, soldering paste and stencil printer. If another HW wendor wants to produce high quality modules, all the steps need to be taken into account.
The part of the OH approach success is at least two stable vendors, so the client has a choice and both vendors compete with price and quality.  This is what we tested already with White Rabbit technology which is remarkable success. I can't really believe that both TS and CTI have long lead times for all modules. The prices are very competetive and both Quartiq and Mlabs get massive discounts.

gkasprow, 2020-11-11:
In case of White Rabbit switch , the project was open source, but it took CTI nearly 2 years to fully implement production, calibration, tests and QC and make the clients happy.  The HW documentation (PCB, mechanics, test procedures) had to be modified to make it compatible with available resources and processes.

gkasprow, 2020-11-11:
One more thing - generic components. Both CTI and TS use the same generic components. That's why we reuse the same parts in the designs so heavily and I'm optimizing every board to limit the BOM. If other generic RC parts are used, for example from unknown vendors, issues may appear. Generic PN does not take into account several factors like C=f(V),  environmental resistance, long-term stability, and other things that may emerge on a long time scale. I have experience with cheap components from occasional vendors. They are good for a product that has 2 years of lifetime. For this reason, we ended cooperation with one international vendor who changed the part vendor without notification, preserving its own PN. That's why we use in all designs only parts from serious vendors. They are not cheap, but they can guarantee quality and long term availability. We are also using parts from trusted vendors only. It's estimated that 30% of the electronic components on the market are counterfeit. It's very tempting to produce things in China, which I also do and use JLPCB service where for a batch of ten, 4 layer boards with assembled components I paid 80$, but I never know which components they use. I do it only for hobby projects.

sbourdeauducq, 2020-11-12:
> Changing a stackup for a board like Kasli is not something that should be undertaken lightly, or without a really good purpose.

I'm not interested in changing the stackup.

> There is also no such thing as a "standard" stackup, lots of different vendors/groups use different default stackups for different reasons

Indeed, so let's change my question "How was this stack-up decided, is it a standard/common NCAB one?" to "is it a default NCAB one?".

> It sounds like you are suggesting that a large fraction of users should switch hardware suppliers and you want to facilitate that? If so, I think that such a serious reconfiguration of how the Sinara collaboration works merits some kind of discussion amongst the many stakeholders.

I want to double-check the correctness of information about the design, namely the published board stackup. Errors in design files happen (https://github.com/sinara-hw/DIO_SMA/issues/8 for example). This isn't "reconfiguring" anything; the hardware was going to be open from the beginning, and there is little value in open but incorrect information that is not used in practice.

> One more thing - generic components. [...]

Thanks for the reminder. I'm not planning to produce anything at a cheap obscure board house in China.

jordens, 2020-11-12:
>  "is it a default NCAB one?"

Can't you answer that yourself? If you need others to help you with preparing production, then you may be misjudging what's required to satisfy your urge to do it yourself. Or you may want to contract and fund them to do it. Conversely, if you can improve and document that production process you are trying to implement, it would certainly be appreciated.

sbourdeauducq, 2020-11-12:
> Can't you answer that yourself?

I'm trying to understand what was done here and how decisions were made. And NCAB does not publish default stackups, so no, I cannot answer that easily. It's a simple question for people who produced with NCAB but not for others.

gkasprow, 2020-11-12:
Normally what you do is you reach the company and ask for materials they have. Different companies use different material vendors. Then you compose your board with these materials.
I usually use Brandner [stack up calculator](https://www.brandner.ee/capabilities/make-your-build-up/), other companies often have similar ones.
In the case of complex boards, I ask companies like NCAB for their default stack up that satisfies my needs (layers, possible impedance ranges, thickness).
And yes, NCAB provides (on request naturally) default stackups with impedance profiles.
Since TS offers also PCBs, I usually ask them for this information. You can do the same.

sbourdeauducq, 2020-11-12:
@gkasprow thanks.

Closed 2020-11-11.

Thread 87 (2020-12-31):

Kasli 2.0 12V input short circuit

sbourdeauducq, 2020-12-31:
I have <s>two</s> <s>three</s> four Kasli 2.0 from TS and Creotech that died in exactly the same way: after a few weeks, a short circuit developed on the 12V input. No burned components or other visible damage. Both failures occurred while boards were inside metallic chassis (ESD is very unlikely).

I'm opening this issue here to collect information about this problem.

kaolpr, 2021-01-05:
Have you tried disconnecting the fan? As problems with these have already been reported (#76) maybe it's generating not only vibrations...

sbourdeauducq, 2021-01-05:
This is on Technosystem boards. They came without fan, and we fitted them with another fan model that we used many times before on Kasli 1 without such an issue.
Also, this is a hard short that can be measured with a DMM, without power applied to the board. The MOSFET that controls the fan cannot have voltage above threshold on its gate.

gkasprow, 2021-01-07:
This could be related to the input protection diode.
If you use a power supply with an output voltage that exceeds 12V significantly, you may heat the D1. It may burn after some time and get shorted.
Just remove D1 and see what happenes.

sbourdeauducq, 2021-01-08:
The power supply is the same AKM65US12 that we have been using before on many Kasli 1.1 without problems, and every time I measured their output it was well below the 13.3V breakdown voltage of the SMBJ12A used on all Kaslis. So this scenario does not sound likely.

sbourdeauducq, 2021-01-17:
One of the boards was actually from Creotech.

> Just remove D1 and see what happenes.

Still the same.

sbourdeauducq, 2021-01-17:
> Have you tried disconnecting the fan?

For good measure, I also tried that - still the same, as expected.

maciejprzybysz, 2021-01-18:
We have just checked Kasli v2.0 sent to Technosystem. We found that the cause of the short circuit is C3 capacitor on the TLV62150 DCDC converter input. In the project 10uF / 6.3V capacitor was used. This converter is powered by 12V, so the capacitor should be rated at least 16V. This problem affects all of the Kasli boards manufactured in accordance with [v2.0rc2](https://github.com/sinara-hw/Kasli/releases/tag/v2.0rc2) and [v2.0.1](https://github.com/sinara-hw/Kasli/releases/tag/v2.0.1) release documentation.

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

We removed the capacitor from the board. It looks like the short circuit is gone and the board is working fine. Unfortunately, there are no suitable 10uF capacitors in 0402 case on the market, so a design change is required.

dtcallcock, 2021-01-18:
Would stacking 2x 4.7uF on top of each other be a reasonable way of patching existing boards?

sbourdeauducq, 2021-01-19:
> Unfortunately, there are no suitable 10uF capacitors in 0402 case on the market

What makes a capacitor suitable here besides the obvious - X5R dielectric?

> Would stacking 2x 4.7uF on top of each other be a reasonable way of patching existing boards?

Or maybe try to fit a 0603 if the footprint happens to be large enough...

sbourdeauducq, 2021-01-19:
Patch with 0805 capacitor (Murata GRM21BR61C106KE15K) and solder bridges
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

Board works again!

akaminska, 2021-01-25:
Thank you all very much for your help with understanding this issue! Attached is a description of a recommended patch
[Kasli_v2_patch_210122.pdf](https://github.com/sinara-hw/Kasli/files/5866415/Kasli_v2_patch_210122.pdf)

Closed 2022-08-05.

Thread 88 (2021-02-03):

+5v fan output

pkozakiewicz, 2021-02-03:
The fan included in BOM seems to be causing some problems. Some of them have stopped working so far, some of the others are generating vibrations. The mounting clip that could not be mounted easily without special tools is also an issue. What is more, I think that we should not rely on avaliability of those accessories because some day it might cause unnecessary delay. It would be much better if we find some alternative.

My suggestion is to go back to the old heat sink and mount some widely available fan onto it, for example SUNON MF20100V1-1000U-A99. The problem is that 99 percent of fans smaller than 23x23 mm are rated for 5 volts and we have only 12v fan output on the board.

jordens, 2021-02-03:
The sunon fans are good. I'm all for this.

jordens, 2021-02-03:
And Sunon has 12v fans of that size as well which we've been using for years on Kasli v1.1. But the fan needs to be mounted properly. That was the entire purpose of the exercise.

pkozakiewicz, 2021-02-03:
@jordens Could you please give me an example of such a fan? I cannot find anything interesting on Digikey. Wouldn't it be more safe to add +5v output instead?

jordens, 2021-02-03:
https://www.mouser.de/ProductDetail/Sunon/MC25101V2-000U-A99

pkozakiewicz, 2021-02-03:
The one that you proposed is EoL, but I found this 25x25mm : MF25101V3-1000U-A99. It will be slightly larger than sink, but we have no other option. I'll order some and we'll check how it works.

I'm wondering if gluing it together will look fine for end customers. Maybe it would be better to design our own heatsink.

jordens, 2021-02-03:
That's version 3 of the same fan. We've been gluing them for years. Works very reliably (if done right) and looks fine. Alternatrively now with the space around the FPGA, we could look for an oversized heatsink that we can screw this fan onto.

marmeladapk, 2021-02-03:
We found [this fan](https://www.digikey.pl/products/pl?keywords=MS2006H12D-RSR) but we have a sample size of 1 working continuously at @sbourdeauducq's lab.

sbourdeauducq, 2021-02-03:
Gluing isn't the perfect solution; in particular, it makes the fan difficult to replace. I also wonder if all the weight that the fan puts on the FPGA is ok, we've had a few Kasli boards with cracked FPGA solders (which appeared after shipping) and this could have something to do with it. A large heatsink attached to the PCB sounds more solid and more serviceable.

jordens, 2021-02-03:
FPGA solder joints breaking due to the fan is implausible. The fan is less than 7 g, at 10 G, that's a meager 0.7 N assuming no lever. Even a single solder ball is typically spec'd to hold that and they are ductile. Other things will fail before the fan breaks a proper solder. Not to mention that the current clip fans attach to the FPGA, not the board. That damage you see likely has different origin (several come to mind).

kaolpr, 2021-02-10:
I agree with @sbourdeauducq on gluing fan. Replacement scenario must be considered. On the other hand, replacing fan along with glued radiator can be easier and, when followed by board testing, should be relatively low-risk.

However, it sounds better to have it with clip or attached to PCB. From what I see, finding an integrated radiator and fan having the right size and voltage is somewhat cumbersome, so maybe let's explore PCB attachment. The question is if we can fit mounting holes in the FPGA region? @marmeladapk what do you think?

marmeladapk, 2021-02-11:
I considered it with 2.0 but I couldn't find enough space for it (see #44 and #7). One of the smaller heatsinks with fan that I found was [this](https://cofan-usa.com/pdf/30-2304_REV01.pdf) but it requires enormous holes:

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

This and other small heatsinks collide with EEM connectors (we have 6.3mm from south edge of FPGA to north edge of EEM conn). However moving FPGA north is way too much work for the benefit.
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

I looked through my notes and it seems that I didn't find a heatsink with fan with that mounting mechanism smaller than 30mm x 30mm. Smaller ones come with a clip.

Then when it comes to mounting holes, the could be located only on lower left and upper right, although even then I don't think I could preserve proper clearance between traces particularly with clock signals. It's only a 6 layer board after all.

kaolpr, 2021-02-11:
So we're left with two options:

1. glue fan to the radiator and consider detaching radiator-fan set from FPGA a valid replacement method,
2. use radfan with clip - @pkozakiewicz did you find a suitable one for 5V?

pkozakiewicz, 2021-02-11:
@kaolpr I'm somewhere between those two options. Using thermoconductive tape to glue the radiator as we used to do in v1.1 is fine for me. I don't think that removing it generates that much stress to damage the solders. This operation is not performed so often (it happens mostly when replacing FPGA itself).

However, in the terms of production process, gluing fan to the heatsink seems to be worse option than screwing it. I suggest that we should try to design a new heatsink with threaded holes dedicated to the most popular 20x20 and 25x25 heatsinks. Manufacturing it won't be expensive.

I thought merely of using 5V fan to avoid shipping delays in the future, because tiny fans are much more widely available for +5V than +12V. I will make some stock of 12v fans, but we have to take into account the possible market situation in the future.

kaolpr, 2021-02-11:
I've talked to @jgajewski and we've came up with the solution where thermal tape is used to glue 25x25mm radiator (slightly bigger then the current one) to the FPGA and fan is screwed to the radiator, much alike in the radfan used in the project now.

Changing to 25x25 radiator will make choosing fan [much easier](https://eu.mouser.com/Thermal-Management/Fans-Blowers/_/N-axg88Z1yzvvqx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) and we won't have to switch to 5V.

marmeladapk, 2021-02-11:
We used thermal tape in v1.1 and it we decided to move away from this solution: #7. I seem to recall that it was also due to risk (or real incidents, can't remember now) of heatsink falling off in transport.

kaolpr, 2021-02-11:
Ok, so we're left with snap-on option. What would you say on a simple, 3D printed adapter glued onto the radiator (e.g. [this one](https://eu.mouser.com/datasheet/2/596/TS-53230K-C1-R0-1480355.pdf)?

Draft of the adapter is given in the figure. Top holes would contain metal threaded inserts, so screwing and unscrewing fan will not damage the adapter. From bottom two tabs would go in between radiator fins and will be glued to it.
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
This solution would allow as using generic 25x25 fan that can be easily replaced and not gluing anything to the FPGA.

kaolpr, 2021-02-19:
Are there any comments on suggested solution?

marmeladapk, 2021-02-22:
@kaolpr I think it's a fine backup plan, but I'd prefer first to get more data on the fan I linked earlier. Hopefully we won't need this at all.

Thread 90 (2021-03-01):

SFP / USB GND connection

kaolpr, 2021-03-01:
See https://github.com/sinara-hw/meta/issues/64

Thread 91 (2021-04-09):

Power supplu connector - panel isolation

mmroz88, 2021-04-09:
In regarding to issue https://github.com/sinara-hw/Kasli/issues/69
I think that it should be proposed a solutoion for SWITCHCRAFT 712RA connector, such as for SMA connentor (issue 69)
For now we added a pressboard washer to isolate the sleeve, hovewer it still could be connection beetween sleeve and the panel due to the too small gap marked in the second photo
As explained by @gkasprow: grounding the power connector bypasses one of the CMC inductors. This may result in lower ground loop impedance and worse EMI susceptibility

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

Thread 92 (2021-06-16):

Power chip failure on v1.1

dtcallcock, 2021-06-16:
Looks like IC6 pretty much exploded.

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

Crate has been running for months, and was working fine at end of day on Friday.  Found in this state on Mon morning so it seems like it was spontaneous rather than user-inflicted.  Was powered using XP PSU it shipped with (via backplane adaptor barrel connector).  That was plugged into a surge protector strip.  Kasli was located in a 19" subrack with forced air cooling.  Connected were 2xUrukuls, 1x DIO_SMA, 1x Sampler, 1x DIO_RJ45.

Any ideas on why it might have done this?

pathfinder49, 2021-06-16:
I've also seen an exploding SMPS on Kasli 1.1 👀

dtcallcock, 2021-06-16:
> I've also seen an exploding SMPS on Kasli 1.1

> Such explosions happen when the input voltage is exceeded.

Is there an issue with the quality of PSUs then?  To be clear, I'm using an XP Power AKM65US12.  I just checked it and it puts out 12.38V unloaded and 11.95V into a 10R resistive load (14W).

> The black residue around L16 and P3V3 test point look suspicious. It looks like some fluid was flowing and causing the short circuit.

I does, but 'to the right' on this photo would have been 'up' when mounted in rack so I'm not sure fluid would flow like this.  Also, no traces of fluid on the fan tray or other electronics that sit above it in rack.

dtcallcock, 2021-06-16:
Obviously v1.1 is somewhat historical but AFAICT this part of the board is very similar on V2.

> Such explosions happen when the input voltage is exceeded.

For reference, the ADP5052 Vin is specced as 4.5-15V with an abs. max of 18V, so there is quite a bit of safety margin.

>  I'm using an XP Power AKM65US12

Btw, I note that the schematic specifies Mean Well GSM90B12-P1M.  That PSU has overvoltage protection that would shut it down at <135%=16.2V (ie. below abs. max).  The XP doesn't so perhaps that's a clue.  Any idea which PSUs are generally out there in the wild?

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

sbourdeauducq, 2021-06-17:
We've shipped plenty of systems with the AKM65US12, and have not seen this issue.

dtcallcock, 2021-06-17:
> We've shipped plenty of systems with the AKM65US12

Are all systems shipped with AKM65US12?  Anyone know why the schematic is not followed (or what even motivated the schematic choice in first place)?

marmeladapk, 2021-06-17:
Schematic choice was based on recomendation from @Robert Jördens
***@***.***> in some old thread. (Or maybe was it just a statement that
he used this supply successfully? I can't remember right now)

czw., 17 cze 2021, 02:04 użytkownik David Allcock ***@***.***>
napisał:

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

gkasprow, 2023-01-09:
It looks like the mid-layer 1 where 12V is routed, was really hot. As well as the GND return path on top layer.
Your power supply must be delivering a lot of current.
It looks like the dc/dc converter shorted the 12V rail.
Moreover, it looks like the 3V3 converter was affected first, probably killing all 3V3 circuits like SFPs.

dtcallcock, 2023-01-09:
> Your power supply must be delivering a lot of current.
It's a 6.67A PSU.

> Moreover, it looks like the 3V3 converter was affected first, probably killing all 3V3 circuits like SFPs.
Any change a bad SFP caused this?  I believe we reused the SFP off the first fried board.  It's hard to imagine it fried the board without frying itself though!

Do you want these fried board for post-mortem?  I guess it's not interesting unless\until you start seeing v2 boards fail in the field (which it sounds like isn't happening even though this part of the board is basically the same).

dtcallcock, 2023-01-09:
Is it worth thinking about putting a fuse on Kasli?  Especially given how many random things pull power via the EEMs.  Presumably wouldn't have prevented this failure but at least there would be a better chance of tracking down the issue rather than leaving a smoking wreckage behind.

Thread 94 (2021-11-17):

CLK_SEL unrouted

jbqubit, 2021-11-17:
On Kasli v2.0 PCB why is CLK_SEL not routed to the FPGA? Currently it looks like it requires a hardware change to choose between OSC1 (Main_DCXO) and Si5424.

gkasprow, 2021-11-17:
these lines are routed to the I2C extender (IC25), the same applies to DCXO OE lines.

jbqubit, 2021-11-17:
Got it. Thanks @gkasprow. 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

sbourdeauducq, 2021-11-18:
Current firmware handles this just fine already.

Closed 2021-11-17.

Thread 95 (2021-12-16):

Grounding modifications

kaolpr, 2021-12-16:
Depends on the final conclusions of https://github.com/sinara-hw/meta/issues/64.

There are several points to consider:

1. Establish front panel circuit and connect mounting holes to it.
1. Power connector - it was pointed out in #91 that power connector in a current setup connects to the panel and, as a consequence can connect to GND via microUSB port or SFP cage effectively diminishing effect of EMI filters (FL1, FL2). As a solution we could pull the connector back and increase FP cutout, so that insulating sleeve can fit between connector and front panel. This would mean lack of nut, but should not be a problem.
2. microUSB shield should be connected to FP circuit and disconnected from GND.
3. SMA stays as it is.
4. Connect SFP cages to FP circuit.

gkasprow, 2021-12-17:
We should do it with properly characterized power sources. Both stand-alone and 3U ones.

kaolpr, 2021-12-17:
What does power source characterization has to do with it? Isn't it only the matter of consequent separation of chassis circuit from the module's ground?

gkasprow, 2021-12-17:
Not only, but It also creates the common mode noise that is propagated across the crate via a ground loop it creates with the AC network.
There are many more such loops that are not obvious.

Thread 97 (2022-05-19):

EEPROM availability

gkasprow, 2022-05-19:
add footprint for 24AA02E48T-I/SN

filipswit, 2022-05-20:
There is 24AA025E48-I/SN already, they are footprint compatible.

gkasprow, 2022-05-20:
24AA025E48 has 16byte page while 24AA02E48 has 8byte page.

marmeladapk, 2022-07-25:
24AA02E48 takes 8 I2C addresses (last 3 bits of address are "don't care") and clashes with SFP3 address space.

Closed 2022-08-05.

Thread 99 (2022-06-27):

Inadequate IC6 decoupling blows up C299

TopQuark12, 2022-06-27:
We recently had the 12v supply input shorted on a Kasli v2.0.1 fresh off the production line, powered on for around 1 hour. C299 (TAJB336K016R) was smoked and shorted. The faulty capacitor was removed and the board functionality was restored.

It was suspected that the capacitor ESR together with high ripple on the P12V0_SMPS rail caused excessive heating leading to the failure. As such, the P12V0_SMPS rail was probed with C299 un populated to see what condition C299 was operating in. To reduce inductive pickup of the scope probe, a probe socket was soldered to C299 footprint and the measurements are done with probe inserted into the socket.

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

As can be seen from the screenshot, there are high frequency noise spikes >1V p-p present on P12V0_SMPS. It was suspected that the multiple 10uF ceramic capacitors (C130-C133) were not adequately decoupling the switching current spikes generated by IC6.

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

To try and reduce the switching noise of IC6 on P12V0_SMPS, 100nF 0603 ceramic capacitors were soldered on top of the 10uF capacitors decoupling IC6 input pins.

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

As can be seen from the scope screenshot, the 100nF caps soldered on top of the 10uF capacitors made no effect on the switching noise.

Upon inspection of the PCB layout, it was discovered that the vias connecting the 12v rail to IC6 were placed between IC6 input pins and decoupling caps. This arrangement is known to reduce the effectiveness of the decoupling capacitors.

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

To prove this hypothesis, 100nF 0402 ceramic capacitors were soldered directly to the power input pins of IC6, with the ground connections of the caps made to be as short as possible.

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

This decoupling arrangement had a drastic effect on reducing the switching noise spikes on the P12V0_SMPS, and reduce the ripple current going through C299, possibly extending its lifetime.

To workaround the issue of C299 blowing up, MLCC capacitors can be used to replace C299. If ESR of original C299 is desired to dampen the LC network formed by L38 and C299, C130-C133, series resistance can be added to one of the multiple MLCC caps replacing C299. This arrangement prevents the ugly outcome of smelly blown up tantalum caps.

Placing 100nF capacitors right at IC6 multiple power input pins, increasing the capacitance / number of decoupling capacitors and placing capacitor pads between vias and IC6 input pins should improve the decoupling performance, minimizing the ripple on P12V0_SMPS and stress placed on C299.

gkasprow, 2022-06-27:
The role of C299 is to dump oscillations of LC circuit. The spikes you are measuring are mainly caused by ground loop effect. Try measuring them on the negative terminal of the same cap with GND clip kept in same place. They won't differ much. I usually use special low impedance probes to measure ripples because standard scope probes simply don't work.

TopQuark12, 2022-06-27:
> The role of C299 is to dump oscillations of LC circuit.

I have noted the role of C299 in my original comment, and have suggested using a discrete resistor in series with a MLCC to provide the required dampening to improve reliability.

> The spikes you are measuring are mainly caused by ground loop effect. Try measuring them on the negative terminal of the same cap with GND clip kept in same place. They won't differ much. I usually use special low impedance probes to measure ripples because standard scope probes simply don't work.

I have verified the integrity of my measurements with your suggestion, and did not observe ground loop noise pickup with my setup. You are welcome to reproduce my test with the equipment you have.

I also measured the 12v rail with a differential probe. While the signal level is close to the noise floor of the probe, a significant difference can be observed when the 100nF caps are soldered right at the power input pins VS 100nF caps disconnected.

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

gkasprow, 2022-06-28:
Yep, a sub-Ohm resistor in series with MLCC is also a good solution. Of course, 100nF should be present because it has a much higher resonance frequency. Via placement is a bug. But I'm not sure if mV or ripples could heat the tantalum capacitors and blow them.

jordens, 2022-06-28:
* The ripples that are "improved" in the [last post](https://github.com/sinara-hw/Kasli/issues/99#issuecomment-1167286244) are clearly unrelated to that SMPS frequency (the trigger). That's not convincing of anything.
* The via placement follows the datasheet reference design. So does the capacitor value, voltage, and material choice AFAICT. I'd be surprised if that's a bug. And I don't see how you could do better given the real estate.
* I also don't see how 100 mV ripple across a tantalum, or even 600 mV (especially in its absence when desoldered!) would blow them.
* In your scope shots your trigger frequency varies a lot (200, 725, 840, 460 kHz). Are you sure you are triggering on and measuring the same thing each time? And are you sure the thing you are measuring is the thing you think you are measuring?
* Maybe rather a transient when plugging in/out, TVS broken, or mechanical damage.
* You claim it's overtemperature of C299. How hot does get?
* That said, we have also seen similar damage twice now. One of them is at creotech right now. You can have a look at it if you want, @gkasprow

gkasprow, 2022-06-28:
I will reach out to the production and ask if maybe they had to use some replacement for this tantalum capacitor. In the case of tantalum caps, one must add some derating because they tend to blow when operated close to Vmax.

gkasprow, 2022-06-29:
CTI installed TAJB336K016RNJ

gkasprow, 2022-09-18:
sure, we can which will lower the cost but I don't think this is an issue. Tantalum caps are known to spontaneously ignite.

gkasprow, 2022-09-19:
They do fail. I used to work as a repairman 20 years ago and was replacing them quite often.
https://ntrs.nasa.gov/api/citations/20205008339/downloads/Breakdown%20and%20Self-healing%20DEI%20rev%20A1.pdf
https://iopscience.iop.org/article/10.1149/2162-8777/abf728

anyway, they are placed in parallel with three ceramic caps with much lower impedance.
Such low trace impedance cause peaks with negligible energy due to their length.
And, tantalum and generally electrolytic caps have high impedance for such high frequency components.
Let's simply replace it with ceramic cap and 0.2R resistor. The function will be the same.
I don't have any v2 Kasli to test it.

dhslichter, 2022-12-15:
We just had the same failure of C299 on a Kasli yesterday. It does appear to be related to the tantalum cap being operated close to its rating, and if for some reason you happen to get a voltage spike it may be enough to cause it to have a thermal runaway. I replaced the dead cap with two 22 uF 25 V X7R caps in parallel (DC bias derates this to more like 18 uF total). Didn't add series resistance but the board powered up OK. I can have a look with a scope and post a trace to see how large the spikes are currently.

Thread 100 (2022-07-26):

External clock reference power limit

Spaqin, 2022-07-26:
This issue is also on Kasli-SOC as it shares most of the design.

The Kasli wiki mentions quite explicitly:
> 1 SMA to the clock recovery and clock distribution chip used as RTIO reference clock input in master/stand-alone mode (10 dBm sine/square max)

10dBm would mean 2Vp-p w/ 50ohm impedance (and that is doubled by the transformer at the SMA input).

That clock input goes further into the FPGA, to LVDS_25 input (pins U20/V20), where Xilinx specifies the maximum differential input voltage at 600mV (both on Artix and Zynq):
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

We found this discrepancy while trying to connect Clocker output to Kasli clock input. Since Clocker output is 800mVp-p with 50ohm impedance, we thought it could cause damage to the FPGA.

In Kasli 1.1 the external clock went directly to Si5324, but in 2.0 (and SoC) it is routed through the FPGA - possibly explaining the rather high signal limit in the wiki.

Is there something we're missing or are the specifications in the wiki wrong?

marmeladapk, 2022-07-26:
It was not updated for v2. I'll update the wiki and add a note to
schematics (#83).

wt., 26 lip 2022, 04:38 użytkownik Spaqin ***@***.***>
napisał:

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

sbourdeauducq, 2022-07-26:
This means using Clocker as clock source requires an attenuator.

hartytp, 2022-07-26:
> 10dBm would mean 2Vp-p w/ 50ohm impedance (and that is doubled by the transformer at the SMA input).

Checking we're on the same page, but the 2:1 transformer is a sqrt(2) step up on the voltage, not a factor of 2. Or, is that what you meant?

hartytp, 2022-07-26:
> We found this discrepancy while trying to connect Clocker output to Kasli clock input. Since Clocker output is 800mVp-p with 50ohm impedance, we thought it could cause damage to the FPGA.

nit pick but for the sake of accuracy...agreed that over-driving an input isn't a good idea, but it's worth noting that (unless I'm mistaken) the numbers you quote there are the recommended operating conditions, not the abs max (no damage) ratings. Usually the damage threshold is quite a bit higher than these numbers.

hartytp, 2022-07-26:
> This means using Clocker as clock source requires an attenuator.

Throwing a couple of options out there if only to discount them:
(a) on the next hw revision we put a clock buffer in front of the FPGA. This adds a bit of additional robustness at the cost of a small amount of additional power dissipation. Am I right in thinking that if we used a 1:2 fanout buffer with the second output connected to CLKIN2 on the 5324 we no longer need to route this signal via the FPGA. May not actually be worth the effort thought...
(b) make a version of clocker which uses a LVDS buffer. Since nothing in Sinara actually uses LVPECL the current design is perhaps not ideally matched. The one caveat here is that the extra uumph is often useful when driving long cable runs which add additional attenuation.

gkasprow, 2022-07-26:
we may also add a Schottky diode limiter

Closed 2022-08-05.

Thread 101 (2022-08-01):

Recommendations to the new revision regarding components supply.

pkozakiewicz, 2022-08-01:
@marmeladapk Below you can find a list of current shortages:

Si5324C-C-GM
24AA025E48-I/SN
TCA9548ARGER
MCP23017-E/SS
549BACB001937ABG

Please consider finding alternatives as you redesign Kasli.

sbourdeauducq, 2022-08-01:
> Si5324C-C-GM
> 549BACB001937ABG

Most parts from Silabs/Skyworks seem to be unobtainium these days. Do you know what is going on with that company?
Replacing those looks like it's going to be a pain.

> TCA9548ARGER

PCA9547 is a viable and available alternative. It is electrically and mechanically compatible and the board does not need to be modified. We use it on some Kasli-SoC. It would simply need porting support from zynq-rs.

pkozakiewicz, 2022-08-01:
> Do you know what is going on with that company?

There's been an acquisition of one company by another and there have been supply chain issues since then. Many chips are claimed to be available only on January 2024. Some could be sourced from the brokers but the prices are approx 20-50x higher.

marmeladapk, 2022-08-01:
FOR TCA9548 I'm going to suggest MAX7356ETG as an alternative, it's somewhat available now. However adding support for PCA9547 would be nice.

marmeladapk, 2022-08-01:
@sbourdeauducq I'm going to add PCA9539 as alternative to MCP23017-E/SS (I'll try to fit both footprints), could you add support for that? MCP23017 price also skyrocketed and PCA9539 seems to be available at the moment and there are pin compatible alternatives.

sbourdeauducq, 2022-08-01:
In principle yes but we should check the compatibility carefully and also how to autodetect which chip is present on the board. It would be annoying to require different firmware builds. For the PCA9547 we can do it by reading the register values after reset.

marmeladapk, 2022-08-01:
PCA9539 uses different address so you can check which one is present on the board.

pkozakiewicz, 2022-08-01:
PS It would also be good to have an alternative for S25FL128SAGMFIR01.

marmeladapk, 2022-08-05:
24AA025E48-I/SN, TCA9548ARGER, MCP23017-E/SS now have alternatives, clock chips unfortunately no.

pkozakiewicz, 2022-08-05:
And what about flash memory?

marmeladapk, 2022-08-05:
There are still some memory configurations that are available. Unfortunately I can't use another package as only SOIC package has VIO pin (unless we move to BGA packages). I also can't fit another footprint in there.

Closed 2022-08-05.

Thread 102 (2022-09-16):

Replacement fan info

TopQuark12, 2022-09-16:
We had kasli cooling fans fail on some of our boards, and the original fan was acoustically a bit obnoxious.

We looked for a replacement, and [CFM-2510B-1100-218](https://www.mouser.hk/ProductDetail/CUI-Devices/CFM-2510B-1100-218?qs=GedFDFLaBXHxyJdzwff0Gg%3D%3D) from CUI Devices works as a replacement for kasli and kasli soc cooling fan.

The fit of this fan on kasli is a bit tight, care must be taken to make sure the screws do screw into the heatsink fins, but it does work. Ideally we would use 20x20 mm fans, but choices are limited with that form factor, especially from good manufacturers. The fitment of this fan is better on kasli-soc with its larger heatsink. M2x16 screws are needed for this replacement fan, and the fan comes un-terminated, so a crimper and crimps are needed too. We only had JST XH connectors on hand so that's what we used, but ideally the matching molex connectors should be used.

marmeladapk, 2022-10-12:
For future reference: https://github.com/sinara-hw/Kasli/issues/88#issuecomment-772604088

lriesebos, 2024-03-13:
I can also confirm that we have seen multiple of these radian fans break. having a better fan to start with would be great. the recommended replacement fan works fine, but it is not really a great fit on the existing heatsink too.

Thread 104 (2022-11-23):

I2c Expander

gkasprow, 2022-11-23:
swap DISABLE with FAULT due to MCP23017 issue
https://github.com/sinara-hw/EEM_FMC_Carrier/issues/46#issuecomment-1317083831

jmatyas, 2023-05-26:
VUSB_PRESENT_N and SFP0_LED should be swapped, rather than DISABLE and FAULT, since the issue concerns MCP23017's IO7 pin

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

Thread 107 (2023-10-27):

bootloader button

gkasprow, 2023-10-27:
In the next revision add a small r/a button available via the front panel hole. It's function is to revert back to the default FLASH bitstream with bootloader.

maciejprzybysz, 2024-02-15:
It could be tricky to fit additional button on EFC front panel. If we want to keep consistency and use similar P/N, please take this into account in new revision.

https://github.com/sinara-hw/EEM_FMC_Carrier/issues/55

gkasprow, 2024-02-22:
use same switch as on KASLI-DIOT

Thread 109 (2024-04-26):

Add P12V0 switch for EEMs

marmeladapk, 2024-04-26:
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

Somewhere here, and switch P12V0 for EEMs only after FPGA is programmed.

gkasprow, 2024-04-26:
That wont work because many boards have independent supply. But in DIOT we might use servmod line to control supplies

gkasprow, 2024-04-27:
Most boards don't use external power connectors, but we have a few that do:
HVAMP32
HVAMP8
SILPA
Thermostat EEM
Stabilizer
Magneto (new one)
HV_PSU
VHF_AMP(new one)

Having even one of them in the crate will make such switching impossible and cause an unintended flow of current.

gkasprow, 2024-04-27:
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

But they short 12V from EEM to external 12V and will supply other boards anyway

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

It can also work as EEM; we even have an ARTIQ driver.

marmeladapk, 2024-05-06:
Still these cards will be in minority of setups, so we could protect most of them. Later in DIOT we won't need that anyway.

Thread 110 (2024-08-06):

R62 & R92 BOM issue

MorganTL, 2024-08-06:
From kasli V2.0.2 project output's BOM:
```
...
"51k"	"Resistor - 1%"	"R62, R92"	"RESC1005X40N"	"GENERIC"	"R0402_51K_1%_0.0625W_100PPM"	"0.4mm"	"YAGEO PHYCOMP"	"232270674703L"	"General Purpose Thick Film Chip Resistor"	"R0402_51K_1%_0.0625W_100PPM"	"2"
...
```
R62 and R92 are 51k ohm resistors but [232270674703L](https://www.digikey.at/en/products/detail/yageo/RC0402FR-0747KL/726616?s=N4IgTCBcDa4MxjAdgAwDYkBZVwDIgF0BfIA) is a 47k ohm resistor

Thread 113 (2025-06-02):

v2.1.0 review

martafafara, 2025-06-02:
Schematic
- [ ] EEM_FLT_N has multiple nets and it causes compilation problem. Use Net Tie to resolve it.
- [ ] The revision number may be changed without template. It is a project parameter, thus use: "Project->Option->Parameters" and change its value.

PCB layout:
- [ ] It's minor remark, but the board shape at the front panel side could be unified as mentioned in this [issue](https://github.com/sinara-hw/DIOT_PSU_integrated/issues/3)
- [ ] To keep unified shape of copper balance layer from version to version consider using the keep out shape as in [DIOT Template](https://github.com/sinara-hw/DIOT-Template)
- [ ] P12V0_EEM polygon in SIgnalLayer1 is wider then necessary. I suppose that it's inherited from previous version. In current layout part of if could be replaced by copper thieving for copper balancing.
- [ ] P3V3 polygon on Bottom Layer contains dead copper - is it purposely?
- [ ] R259, D21 and D22 have no thermal pads - potential tombstone effect

Thread 115 (2025-06-13):

The AC coupling caps on SFP GT lanes are unnecessary according to SFP(+) spec

MorganTL, 2025-06-13:
see [kasli-soc/#83](https://github.com/sinara-hw/Kasli-SOC/issues/83)
