sinara-hw/Kasli/(list of files, drawings)

Other design files:
ClockRecovery.SchDoc
FPGA.schdoc
FPGA_I2C.SchDoc
FPGA_SDRAM.SchDoc
FPGAGTP.SchDoc
FPGAPower&Misc.SchDoc
IDC_EXT_Connectors.SchDoc
Kasli.PrjPCB
PcbLib1.PcbLib
PowerSupplies.SchDoc
Schlib1.SchLib
SFP.SchDoc
TOP.SchDoc
USB_Serial_Quad.SchDoc
