sinara-hw/Kasli/(commit log)

2018-05-26 Moved files from sinara repository
    [BackplaneConnector.SchDoc, ClockRecovery.SchDoc, FPGA.schdoc, FPGAGTP.SchDoc, FPGAPower&Misc.SchDoc, FPGA_I2C.SchDoc, FPGA_SDRAM.SchDoc, IDC_EXT_Connectors.SchDoc]
2018-06-12 Added .gitignore Added PcbLibrary used for components absent from Cern library Changed order of files in project
    [PCB_3U_Kasli.PrjPCB, PcbLib1.PcbLib]
2019-01-08 Grounded MMCX and SMA connectors. Removed CernLibs from search path in project.
    [ClockRecovery.SchDoc, PCB_3U_Kasli.PrjPCB, TOP.SchDoc]
2019-06-12 Schematics WIP for 2.0
    Added DC blocking capacitors on SFP lines
    Added dust covers for SFP
    SMA clock input goes to the FPGA
    Added 2x DCXOs
    Switched ADCLK944 to ADCLK948 for clock mux
    Added 12V0->5V0 buck and 5V0->3V3 regulator for ADCLK948 and Si5324 (Si549 DCXO uses 2V5 LDO)
    Moved most of GPIO signals to I2C extender (interrupts go to the FPGA_
    Added stacked 2x1 SFP cage
    Removed backplane connector and clock signal that went to it
    Added 4x EEM connectors
    Switched FTDI buck to LDO with higher input voltage range
    Switched the FPGA to -3 speed grade
    Changed some designators
    Schematic compiles without any errors
    [BackplaneConnector.SchDoc, ClockRecovery.SchDoc, FPGA.schdoc, FPGAGTP.SchDoc, FPGAPower&Misc.SchDoc, FPGA_I2C.SchDoc, FPGA_SDRAM.SchDoc, IDC_EXT_Connectors.SchDoc]
2019-08-28 - Switched some components to CERN library (mainly LEDs) - Removed 1,2V LDO - Switched to 2x2 SFP cage, added SFP3, sharing lines with SATA port (SFP selected by default) ( closes #41 ) - Placed rear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
    [ClockRecovery.SchDoc, FPGA.schdoc, FPGAGTP.SchDoc, FPGAPower&Misc.SchDoc, FPGA_I2C.SchDoc, PCB_3U_Kasli.PrjPCB, PcbLib1.PcbLib, PowerSupplies.SchDoc]
2019-09-19 - Switched pullup resistors ( closes #46 ) - Switched TCA9517 to PCA9306 for truer 0V low level on I2C bus (both near FPGA and near FTDI) - Removed EN pullup on IC13, increased pulldown strength on E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
    [ClockRecovery.SchDoc, FPGA.schdoc, FPGAPower&Misc.SchDoc, FPGA_I2C.SchDoc, PCB_3U_Kasli.PrjPCB, PcbLib1.PcbLib, PowerSupplies.SchDoc, SFP.SchDoc]
2019-09-24 Ready for schematic review - Removed external termination SMA input to the FPGA (placed an optional 51 termination resistor if balun is not used) - Updated version number in schematic sheets - Readde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
    [ClockRecovery.SchDoc, FPGA.schdoc, FPGAGTP.SchDoc, FPGAPower&Misc.SchDoc, FPGA_I2C.SchDoc, FPGA_SDRAM.SchDoc, IDC_EXT_Connectors.SchDoc, PCB_3U_Kasli.PrjPCB]
2019-10-16 After schematic review - Added FBs and decoupling to Si549 ( closes #48 ) - Implemented optional galvanic isolation ( closes #50 ) - Removed FPGA mode and DXP DXN jumpers - Added diode in parallel wi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
    [ClockRecovery.SchDoc, FPGA.schdoc, FPGAGTP.SchDoc, FPGAPower&Misc.SchDoc, FPGA_I2C.SchDoc, PCB_3U_Kasli.PrjPCB, Schlib1.SchLib, TOP.SchDoc]
2019-11-28 Release - DNP J26 - Removed SATA connector - Added cap to IC5 - IC14, IC15: removed 0R to address pins - Pin swapping Ext8-11 - Swapped pins on GPIO extenders ( closes #54 ) - Added second reset sour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
    [ClockRecovery.SchDoc, FPGA.schdoc, FPGAGTP.SchDoc, FPGAPower&Misc.SchDoc, FPGA_I2C.SchDoc, FPGA_SDRAM.SchDoc, PCB_3U_Kasli.PrjPCB, PcbLib1.PcbLib]
2019-12-15 RC2 Close #65 Added DNPed resistors on unused complementary LVPECL outputs - Close #63 Close #61 Close #59 Switched Si549 to CERNlib MMCX net lengths were equalized (xsignals were broken). Additional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
    [ClockRecovery.SchDoc, PCB_3U_Kasli.PrjPCB, PcbLib1.PcbLib, Schlib1.SchLib]
2020-09-04 Kasli v2.0.1 - Close #80 - Fixed #78 - Change LT3045 output capacitors to 0603 22uF 6.3V, fixed #70 - Fixed #68 - Fixed #67 - #66: added LC filter to SMPS input and fan supply (both IC6 and IC7) - Ch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
    [ClockRecovery.SchDoc, FPGA.schdoc, FPGAGTP.SchDoc, FPGAPower&Misc.SchDoc, FPGA_I2C.SchDoc, FPGA_SDRAM.SchDoc, IDC_EXT_Connectors.SchDoc, Kasli.PrjPCB]
2020-09-11 Reduced current loops for P2V5, P3V3, P1V0.
2020-09-22 Power supply improvements
    [FPGA.schdoc]
2020-09-22 Added DC bias to input clock. Closes #82
    [FPGA.schdoc, TOP.SchDoc]
2020-09-23 Kasli v2.0.1 Added 10 uF capacitors on input and output of FL1 and FL2 Added P3V3 test point.
    [FPGA.schdoc, PowerSupplies.SchDoc]
2022-08-05 Small fixes and alternative components - schematics only
    - Added SMA washers (closes #74)
    - Added note with max and recommended sma input level (closes #83, closes #100)
    - Changed C3 to a higher voltage rating (closes #87)
    - Fixed #93
    - Changed LD14 (closes #67)
    - Fixed #96
    - Added PCA9539 as an alternative GPIO expander
    - Added switching frequency selection to IC7
    - Added LT1938 as an alternative to TLV62150
    - Added additional I2C bus dedicated to 24AA02\* EEPROM on FPGA pins P19 and P20 (closes #97)
    - Removed unused DDR3 DQ termination resistors from FPGA_SDRAM (they weren't placed on the PCB, they were just on schematics)
    - Updated version number in schematics
    [ClockRecovery.SchDoc, FPGA.schdoc, FPGA_I2C.SchDoc, FPGA_SDRAM.SchDoc, Kasli.PrjPCB, PcbLib1.PcbLib, PowerSupplies.SchDoc, Schlib1.SchLib]
2022-08-08 Fixed SCL<->SDA on GPIO expanders. Applied variants to gpio expanders. Removed additional SDA, SCL, RESET jumpers on gpio expanders. PCB WIP.
    [FPGA_I2C.SchDoc, Kasli.PrjPCB]
2022-08-10 PCB WIP
2022-08-12 Finished PCB. Moved 712RA 0.5mm back
    [Kasli.PrjPCB]
2022-08-12 Kasli v2.0.2 Updated copyright year
    [ClockRecovery.SchDoc, FPGA.schdoc, FPGAGTP.SchDoc, FPGAPower&Misc.SchDoc, FPGA_I2C.SchDoc, FPGA_SDRAM.SchDoc, IDC_EXT_Connectors.SchDoc, Kasli.PrjPCB]
2025-05-30 Kasli v2.1.0
    [FPGA.schdoc, IDC_EXT_Connectors.SchDoc, Kasli.PrjPCB, PowerSupplies.SchDoc, TOP.SchDoc]
2025-09-04 v2.1rc1
    Merge pull request #114 from linuswck/v2.1.0
    [FPGA.schdoc, FPGA_I2C.SchDoc, Kasli.PrjPCB, PowerSupplies.SchDoc, SFP.SchDoc]
